ArminJo/JK-BMSToPylontechCAN/README.md

<div align = center>

# [Arduino JK-BMS To Pylontech CAN Protocol Converter](https://github.com/ArminJo/JK-BMSToPylontechCAN)

Converts the JK-BMS RS485 data to Pylontech CAN data for inverters which are not compatible with JK-BMS protocol but with Pylontech protocol, like Deye inverters.<br/>
Display of many BMS information and alarms on a locally attached serial 2004 LCD.<br/>


 &nbsp; &nbsp;

 &nbsp; &nbsp;

 &nbsp; &nbsp;

 &nbsp; &nbsp;

<br/>

Based on https://github.com/syssi/esphome-jk-bms and https://github.com/maxx-ukoo/jk-bms2pylontech.<br/>
The JK-BMS RS485 data (e.g. at connector GPS) are provided as RS232 TTL with 115200 Bit/s.

</div>

#### If you find this program useful, please give it a star.

&#x1F30E; [Google Translate](https://translate.google.com/translate?sl=en&u=https://github.com/ArminJo/JK-BMSToPylontechCAN)

<br/>

# Features
- Protocol converter from the JK-BMS status frame to Pylontech CAN frames.
- Supports sending of total capayity for **SMA** and **Luxpower** inverters.
- Optional linear **reducing maximum current above 80% SOC** (values can be adapted to your needs).
- Support for **multiple BMS** on a Nano board.
- Display of BMS information, Cell voltages, statistics and alarms on a locally attached **serial 2004 LCD**.
- Page button for switching **6 LCD display pages**.
- **CAN Info page** and debug output during long press of button.
- Statistics of minimum and maximum cells during balancing to **identify conspicuous cells**.
- Switch off LCD backlight after timeout (can be disabled at compile time).
- Beep on alarm and connection timeouts with selectable timeout.
- Alarm on cell voltage zero which indicats an internal BMS failure.
- Serial.print() function is still available for monitoring and debugging.
- **SOC graph output for Arduino Serial Plotter** at Plotter Info page. Clearing of SOC EEPROM data on long press.
- The voltage in the SOC graph is corrected by the automatically computed ESR to get a smoother voltage curve.
- Runs on an ATmega644 with all features. Compile it with [MightyCore](https://github.com/MCUdude/MightyCore).

<br/>

**If the Aduino IDE complains about more than 100% of program storage space, burn the Uno Bootloader on your Nano, if not already done, and select the Uno as board. The Arduino Nano board definition has a [wrong "upload.maximum_size" value](https://github.com/arduino/ArduinoCore-avr/pull/546).**<br/>
Look [here](https://github.com/ArminJo/JK-BMSToPylontechCAN/blob/main/JK-BMSToPylontechCAN/JK-BMSToPylontechCAN.ino#L139) for options to reduce program size / add optional features.

**On a MCP2515 / TJA1050 kit for Arduino you must [replace the assembled 8 MHz crystal with a 16 MHz one](https://www.mittns.de/thread/1340-mcp2515-8mhz-auf-16mhz-upgrade/).**

**The MCP2515 / TJA1050 kit for Arduino may be supplied by an extra 5 V regulator. My Arduino-Nano internal regulator cannot provide more than 100 mA and got defect on my site after a few days.**

**By default, the program sends a request to force charge the battery if SOC is below 5 %. This can be adapted by changing the line `#define SOC_THRESHOLD_FOR_FORCE_CHARGE_REQUEST_I 5`.**

At around 100% SOC, the JK-BMS seems to send strange current information of more than +/- 1 ampere.<br/>
If CAN communications breaks, the inverter may use different values for controlling the battery (e.g. "Use Batt V"), which may lead to additional discharging / charging.

<br/>

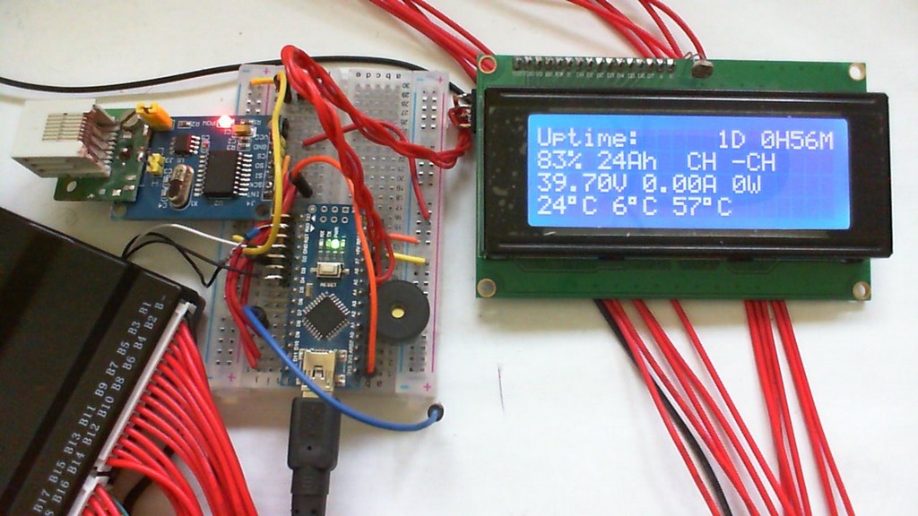
[picture p1: pictures/BreadboardAndOverviewPage.jpg]
Overview


<br/>

# Multiple BMS
Multiple BMS are enabled by activating line `#define HANDLE_MULTIPLE_BMS`.<br/>
At the time, 2 BMS are supported, but the code is prepared to support more.

The first BMS is connected with 115200 baud at pin 4 by SoftwareSerialTX to the JK-BMS RX line.
The second BMS can be connected at Nano pin 5 to the JK-BMS RX line of the second BMS.

We use the hardware serial RX pin for all serial from BMS (RX) because the RX data won't come at the same time.
But it is necessary to use a Schottky diode in each line to create a wired OR gate. 
As the active level of USART is **low**, all the cathodes of the Schottky diodes must be connected to the Nano RX pin, 
while each anode is connected to the BMS TX pin.

**Therefore we do not need a CPU with 2 serial ports, a Arduino Nano is sufficient.**

<br/>

# SOC graph for a 16S LiFePO4 battery
Created by attaching Arduio 1.8.19 Serial Plotter and then doing a long button press followed by a single one to enter the SOC History page.<br/>

Here you see a steep capacity increasing at the transition from 100 % to 99 %.
This happens when the specified capacity in the BMS is smaller than the real one.
The new 99 % represents a bigger capacity than the old 100 %.<br/>
If the capacity is around 100 Ah, the gradient of the capacity and the SOC line is identical.

Here the current is not negative for 99%, because it is the average of the current above 100% -increasing the capacity- and the negative current delivered for the step from 100% to 99%.

The voltage line is smooth, because it is corrected with the ESR (Equivalent Series Resistance) of the battery.
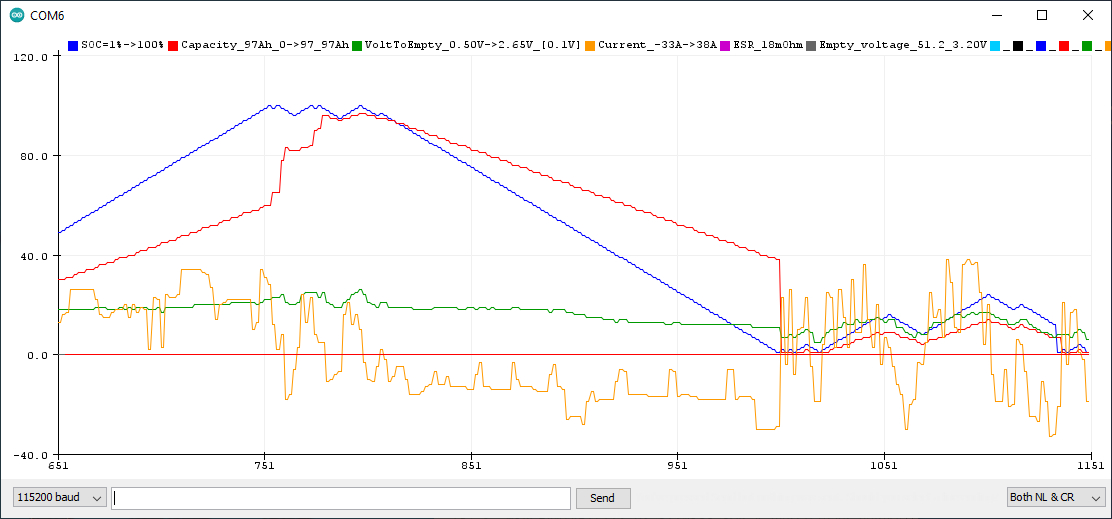
[picture p2: extras/SOCDataESR.png]


The same (raw) data without ESR correction of voltage.
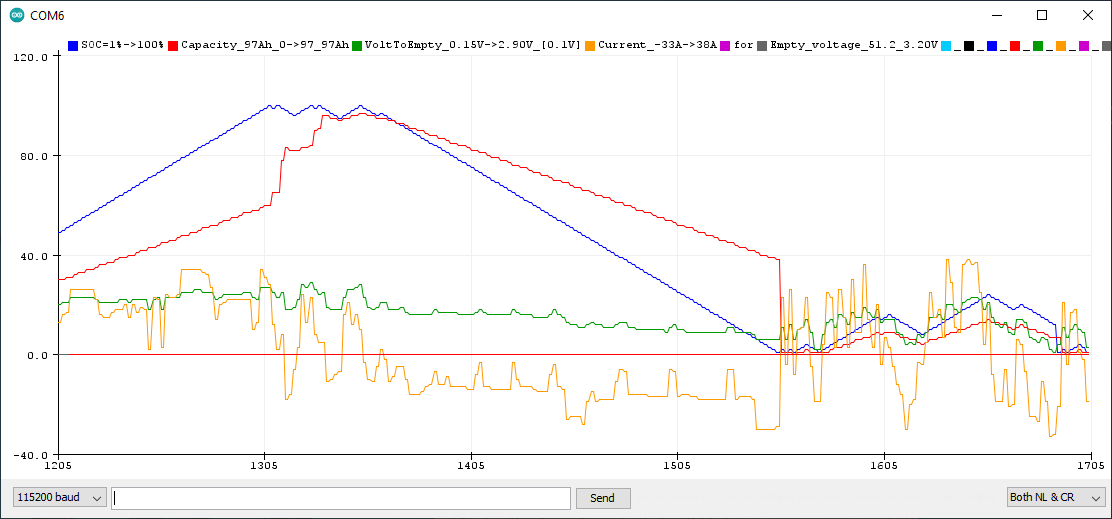
[picture p3: extras/SOCDataNoESR.png]


# Screenshots
 The screenshots are taken from the [Wokwi example](https://wokwi.com/projects/371657348012321793) with `STANDALONE_TEST` enabled and therefore may contain random data.

| Big Info page with:<br/>- SOC and Power<br/>- Maximum of 3 Temperatures and Ampere in/out<br/>- Difference between minimum / empty and (current battery voltage - Volt to full)<br/>- Display of  "C"harging "D"ischarging and "B"alancing active flags | Overview pagewith :<br/>- SOC, charged capacity, state of enable flags<br/>- Voltage, current and power<br/>- Voltage difference to empty, MosFet temperature, maximum sensor temperature, state of enabled functions. <br/>- If Overvoltage, C is replaced by O<br/>- If Undervoltage, D is Replaced by U |
| :-: | :-: |
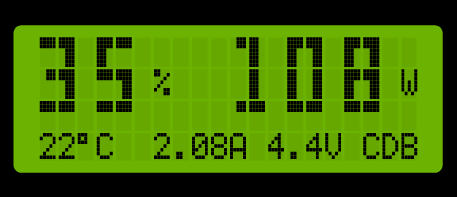
[picture p4: pictures/BigInfoPage.png]
Big Info page
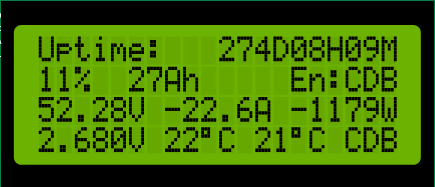
[picture p5: pictures/OverviewPage.png]
Overview page
|  |  |
| Undervoltage Alarm page<br/>Start of alarm message in first line<br/>Index and value of minimum cell and uptime in second line | Overtemperature Alarm page<br/>Alarm message is cleared by switching page |
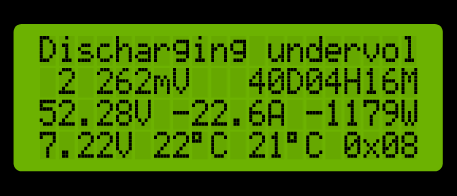
[picture p6: pictures/AlarmPage_Undervoltage.png]
Alarm page undervoltage
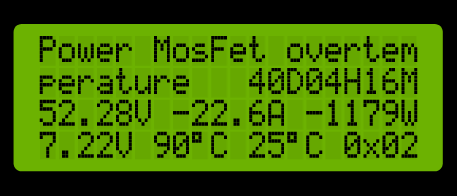
[picture p7: pictures/AlarmPage_MosFetOvertemperature.png]
Alarm page overtemperature
|  |  |
| Cell Info page with maximum and minimum indicators | Cell Info page with SHOW_SHORT_CELL_VOLTAGES aktivated:<br/>- (Cell voltages - 3 V)<br/>- SOC, current in A, state of enabled functions and difference between minimum / empty and current battery voltage in last column |
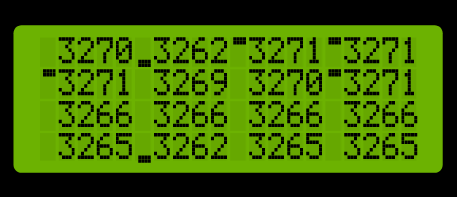
[picture p8: pictures/CellInfoPage.png]
Cell Info page long
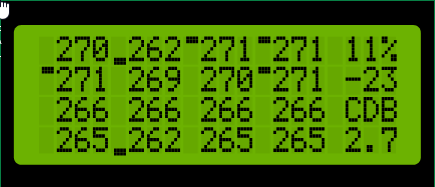
[picture p9: pictures/CellInfoPage_shortVoltages.png]
Cell Info page short
|  |  |
| Maximum Cell Statistics page with total balancing time in right rows | Minimum Cell Statistics page<br/>The maximum and minimum displays are toggled every 8 seconds |
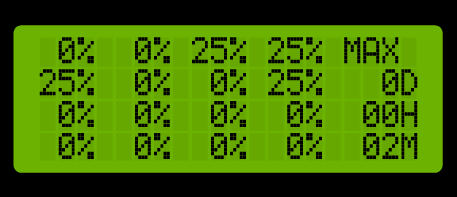
[picture p10: pictures/StatisticsMaxPage.png]
Max page
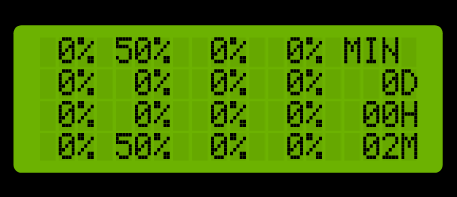
[picture p11: pictures/StatisticsMinPage.png]
Min page
|  |   |
| CAN Info page |  |
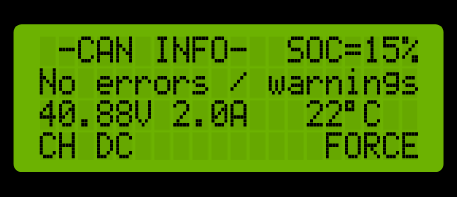
[picture p12: pictures/CANInfoPage.png]
CAN Info page
|  |  |
| Capacity Info page (CAN Info page + 2 buttton presses) percentages | Capacity Info page voltages<br/>Current capacity change in first row if delta-SOC > 1<br/>Historic capacity changes with delta-SOC > 40 in row 2 to 4 |
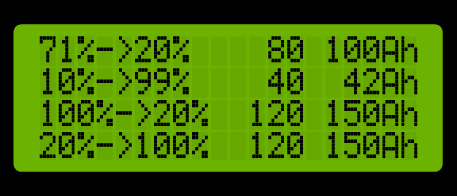
[picture p13: pictures/CapacityStatisticsPercentagePage.png]
Percentage page
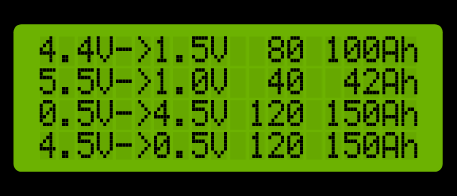
[picture p14: pictures/CapacityStatisticsVoltagePage.png]
Voltage page
|  |   |

<br/>

# Pictures

| My installation | Automatic brightness |
| :-: | :-: |
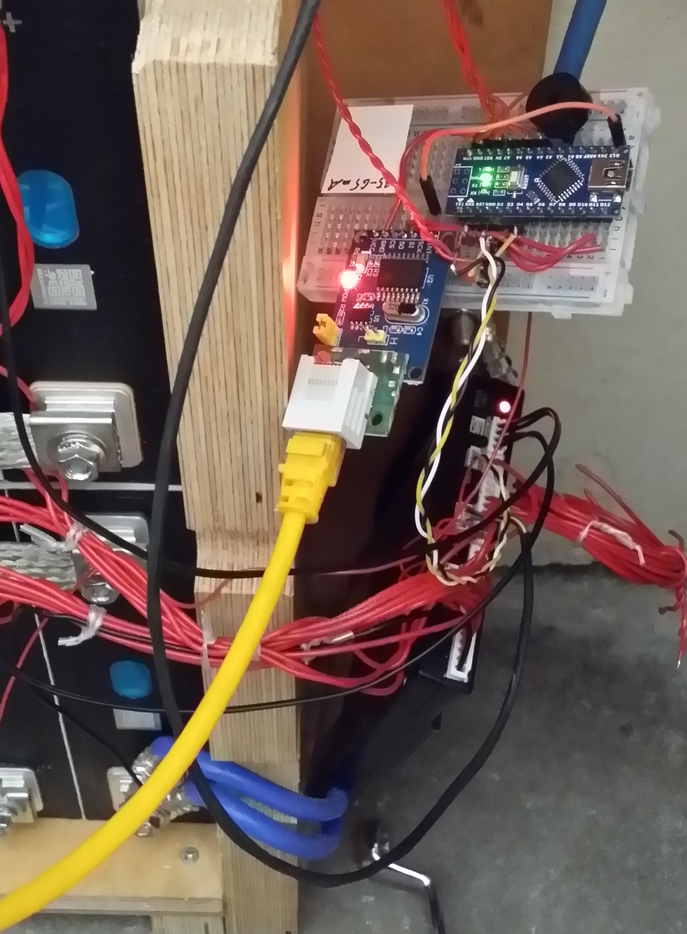
[picture p15: pictures/CompleteInstallation.jpg]
My installation
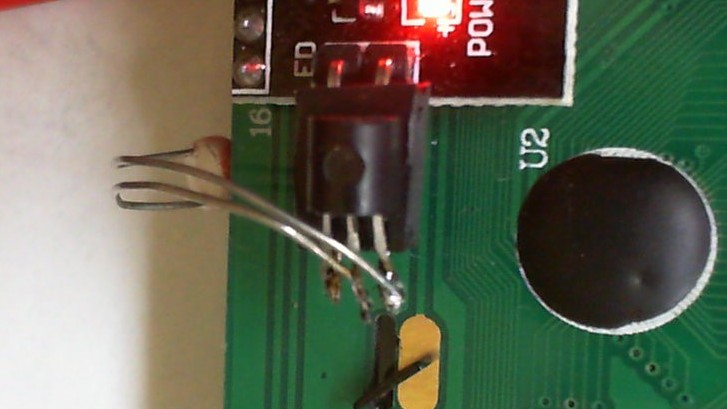
[picture p16: pictures/AutomaticBrightness.jpg]
Automatic brightness
|  |  |
| Breadboard detail |  |
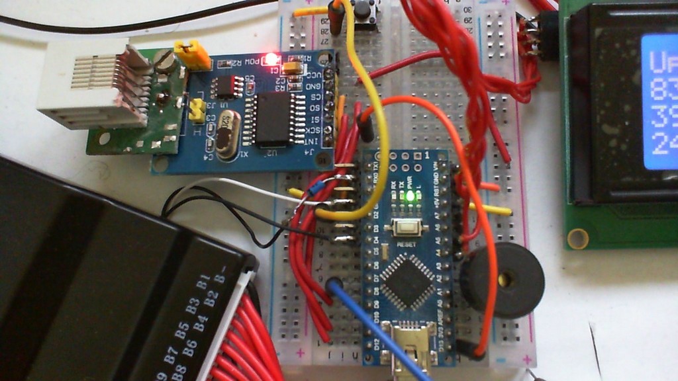
[picture p17: pictures/BreadboardDetail.jpg]
Breadboard detail
|  |  |
| Breadboard without BMS connected | Standalone test |
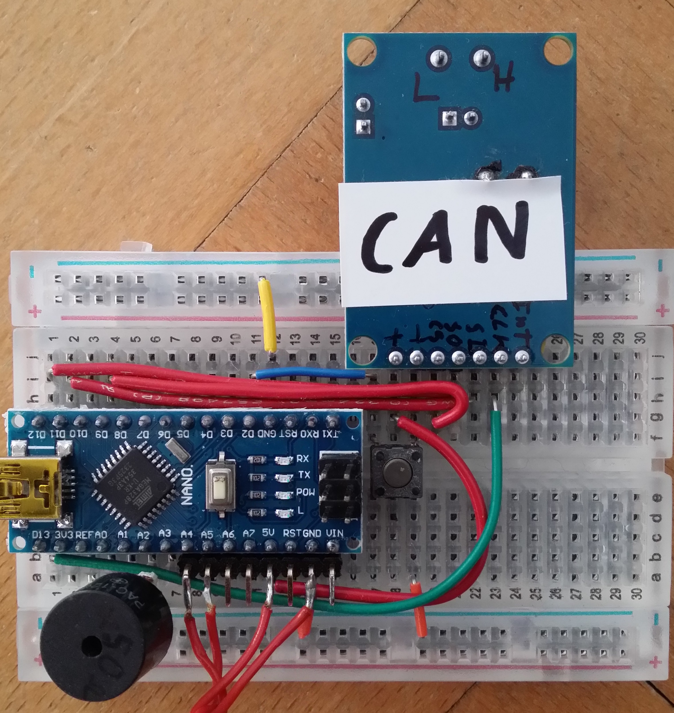
[picture p18: pictures/BreadboardSimple.jpg]
Breadboard detail
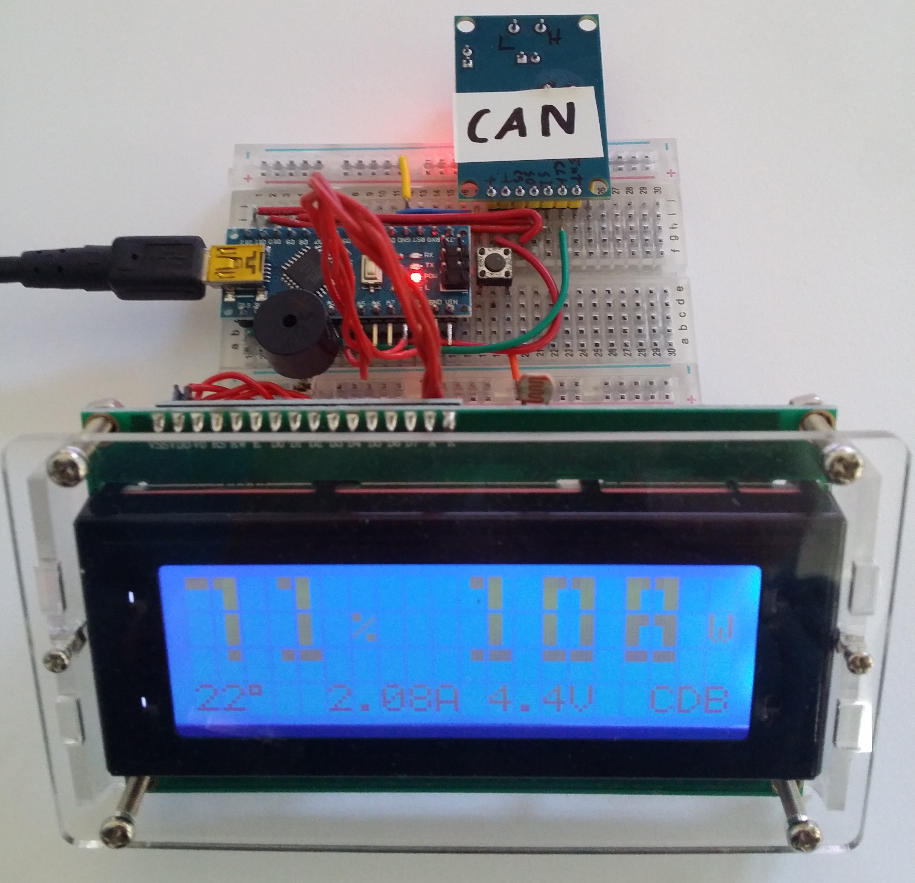
[picture p19: pictures/StandaloneTest.jpg]
Standalone test
|  |  |
| No-breadboard version overview | No-breadboard version overview |
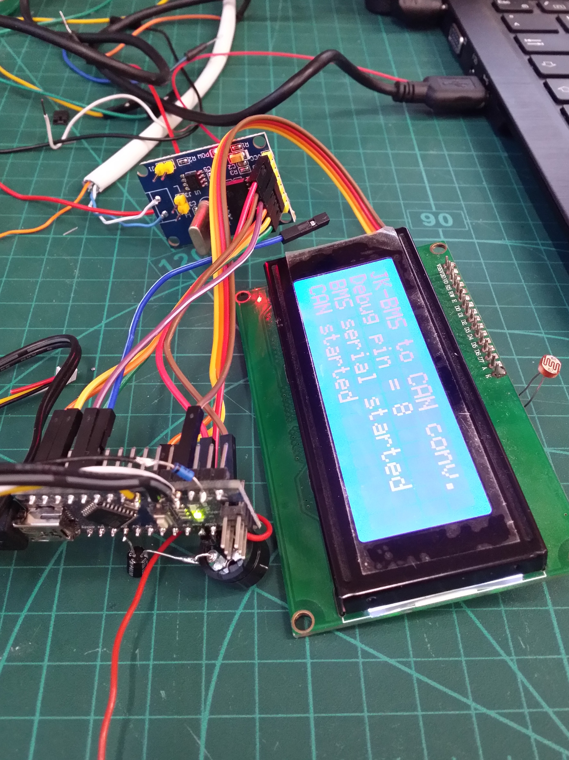
[picture p20: pictures/NoBreadboardOverview1.jpg]
Overview no breadboard
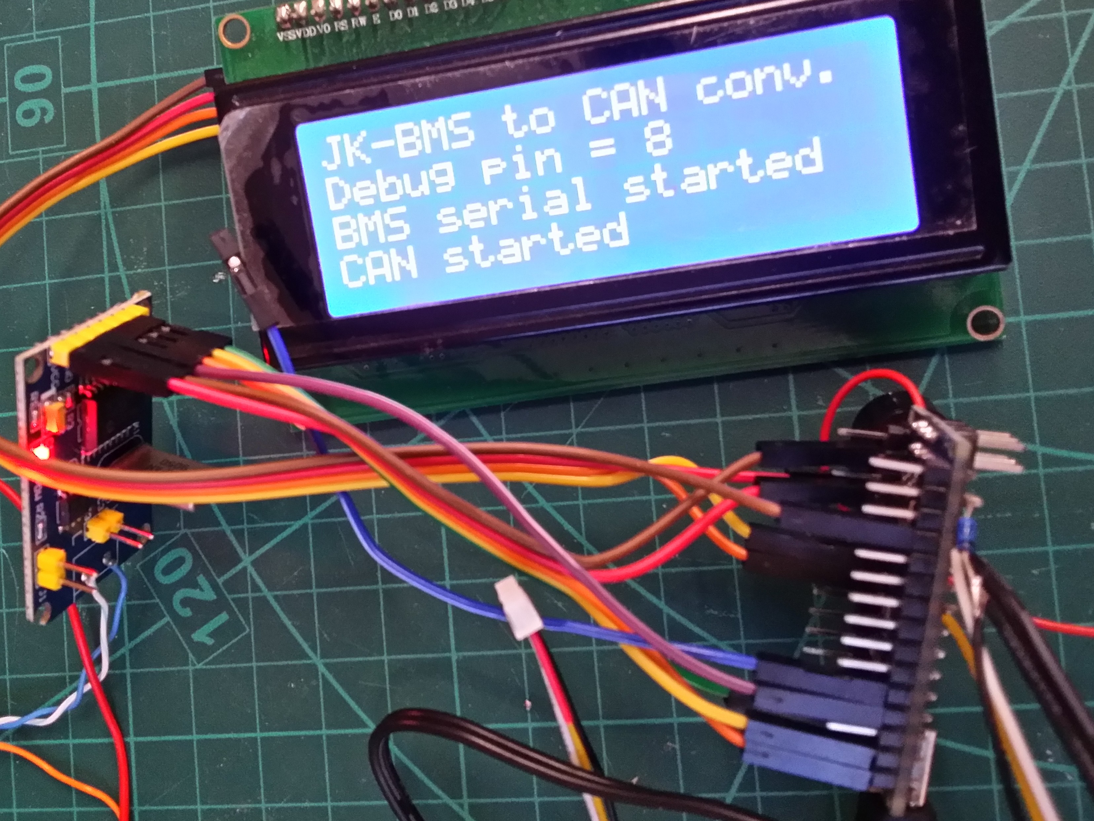
[picture p21: pictures/NoBreadboardOverview2.jpg]
Overview no breadboard
|  |  |
| Nano top view | Nano bottom view |
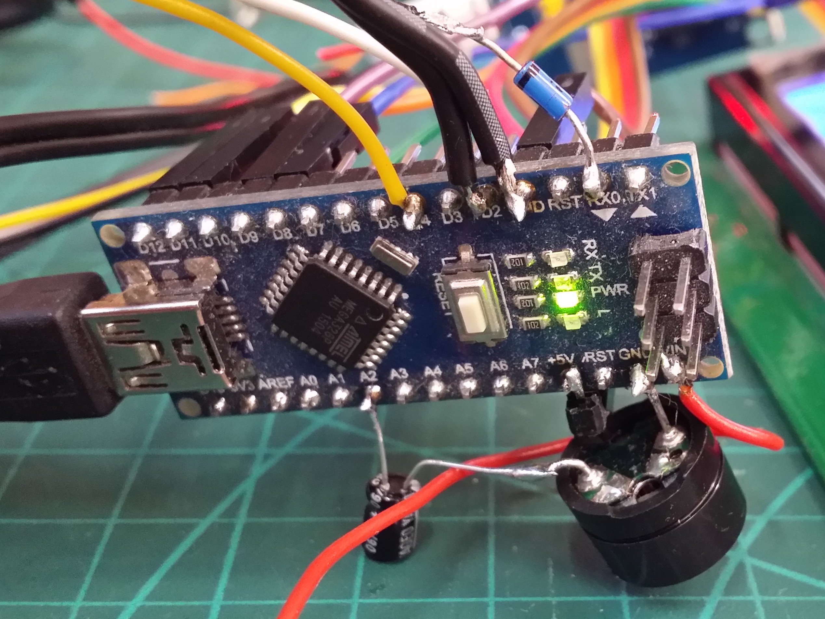
[picture p22: pictures/NanoTop.jpg]
Nano top view
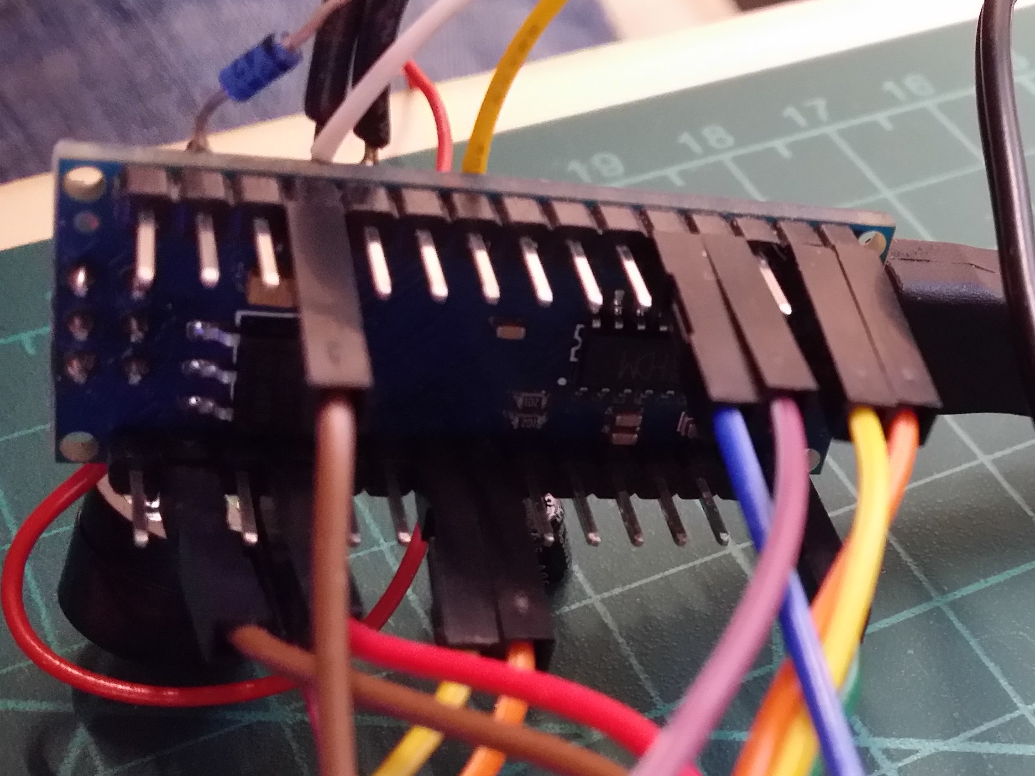
[picture p23: pictures/NanoBottom.jpg]
Nano bottom view
|  |  |

<br/>

# Youtube video of JK-BMS doing wrong computing of capacity.
I discharged the battery for 10 minutes with 45A, which gives **7.5 Ah** capacity loss.<br/>
Start of 10 minutes period is left screenshot with time of ...**21M40S** and Capacity **50.7 Ah**, end of period is right screenshot with time of ...**31M40S** and Capacity **38.6 Ah**.<br/>
These 2 values correspond to a **BMS computed capacity loss of 12.1 Ah** (50.7 Ah - 38.6 Ah)!<br/>
**What the hell is the formula they used for this obviosly wrong result!!!***<br/>
SOC went from 40 % to 30 %, which at least corresponds to 12.5 Ah for a total battery capacity of 125 Ah.

Youtube video of JK-BMS doing wrong computing of capacity (https://www.youtube.com/watch?v=tDN8iFr98JA)

<br/>

# Example on Wokwi
Also usable as connection schematic.

- [Wokwi JK-BMSToPylontechCAN example](https://wokwi.com/projects/371657348012321793).

 <br/>

# Connection schematic
The standard **RX** of the Arduino is used for the JK-BMS connection.<br/>
A **schottky diode** is inserted into the RX line to allow programming the AVR with the JK-BMS still connected and switched on.
Keep in mind that programming will fail if JK-BMS is connected and switched off.<br/>
The standard **TX** of the Arduino is used for Serial.print() for monitoring and debugging. The short **request to JK-BMS is sent by `SoftwareSerialTX` using pin 4**.<br/>
If you use the cable from the separate RS485 adapter of the JK-BMS and follow the labeling on the board, you have to **swap the lines for RX and TX (pin 4)** on the Uno / Nano.

**Troubleshooting BMS receive problems**<br/>
Since the RX pin of the Nano is also connected to the TX pin of the USB converter chip (CH340 or similar),
it can be difficult for the JK-BMS TX output to pull it properly down.<br/>
This results in not receiving any data from the BMS despite the connection.<br/>
In this case, first try to remove the diode and second connect a pull down at the Nano RX.<br/>
Depending on the USB converter chip, this pull down can be in the range from 680 Ohm to 1 kOhm.

**Power** is taken from an **USB power supply** connected to the Nano. Current is 40 mA for a dark 2004 display and 55 mA for a bright one.<br/>
Optionally, power can be taken from the second battery (>6.4 V), but then you may require an external 5V regulator. My built in regulator broke 2 times (with LCD connected).<br/>
Or use the complete battery voltage for Nano supply and a buck converters for around 48 to 60 volt. But my test converter had an idle current of 6 mA (0.3 W), so I decided to stay with the USB power supply.

On the Deye, connect cable before setting `Battery Mode` to `Lithium`, to avoid alarm. `Lithium Mode` for Pylontech CAN is `0` or `PYLON`.

```
 ALTERNATIVE EXTERNAL POWER SUPPLY:
                                          78L05    Optional Schottky diode - From Uno/Nano 5 V
                                           ___                         to enable powering CAN
 Optional 6.4 V from Battery #2 >-o-------|___|-------o-|<|-< Uno 5V   module by Nano USB, if
                                  |         |         |                battery is not attached
                                  |        ---        |
 . . . . . . . . . . . . . . . . . . . . . . . . . . . . . . . . . . . . . . . . . . . . . . .
                                  |                   |
  __________ Schottky diode   ____|____           ____|____             _________
 |        TX|>--|<|-o- RX -->|RX Vin   |<- SPI ->|   5V    |           |         |
 |        RX|<------|- TX --<|4  Uno/  |         | MCP2515 |           |         |
 |  JK-BMS  |      .-. opt.  |   Nano  |         |   CAN   |<-- CAN -->|  DEYE   |
 |          |   1k | | pull  |         |         |         |           |         |
 |          |      '-' down  |         |         |         |           |         |
 |__________|<------o- GND ->|_________|<- GND ->|_________|           |_________|

An optional pull down may be required at the RX pin of the Nano,
to compensate for the load of the USB chip (CH340 or similar) at this pin.
Depending on the USB chip, the pull down can be down to 680 Ohm.

# Connection diagram for JK-BMS GPS / UART-TTL socket (4 Pin, JST 1.25mm pitch)
  ___ ________ ___
 |                |
 | O   O   O   O  |
 |GND  RX  TX VBAT|
 |________________|
   |   |   |
   |   |   o-|<|-- RX of Uno / Nano
   |   o---------- D4 (or other pin, if specified differently)
   o-------------- GND

# Using an abitrary PNP transistor instead of a diode between BMS TX and Nano RX,
#   to support weak TX outputs and multiple BMS connected to one Nano RX.
  ___ ________ ___
 |                |
 | O   O   O   O  |
 |GND  RX  TX VBAT|
 |________________|
   |   |   |
   |   |   |      o GND
   |   |   |      |
   |   |   |    |/  C
   |   |   o----|       Any PNP will work!
   |   |     B  |<
   |   |          | E
   |   |          o-- RX of Uno / Nano
   |   o------------- D4 (or other pin, if specified differently)
   o----------------- GND

# Automatic brightness control for 2004 LCD
   5V O------o------o
             |      |
            .-.     |
        LDR | |     |
            | |     |
            '-'     |
             |    |/
             o----|
                  |>
                    |
                    o To anode of LCD backlight

Alternative circuit for VCC lower than 5 volt e.g. for supply by Li-ion battery

  3.5V to 5V O------o------o Anode of LCD backlight
             |
            .-.
   LDR with | |
     high R | |     o Kathode of LCD backlight
            '-'     |
             |    |/
             o----|
                  |>
                    |
  GND O-------------o

```
<br/>

# Example schematics and PCB layouts
- [KiCad8 schematics and PCB layout](https://github.com/dremeier/Arduino-JK-BMS-To-Pylontech-CAN-PCB) for ATmega644 compiled with [MightyCore](https://github.com/MCUdude/MightyCore) and 2 BMS connectors by Andé Meier.
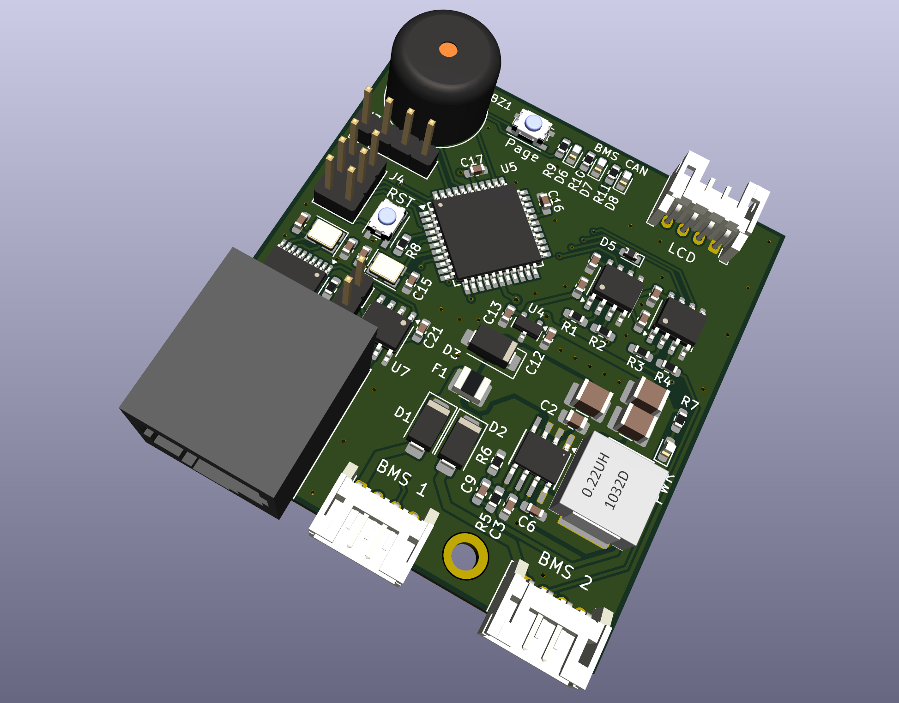
[picture p24: pictures/BMS-CAN_PCB_top_v0.1.png]
PCB layout (https://github.com/dremeier/Arduino-JK-BMS-To-Pylontech-CAN-PCB)


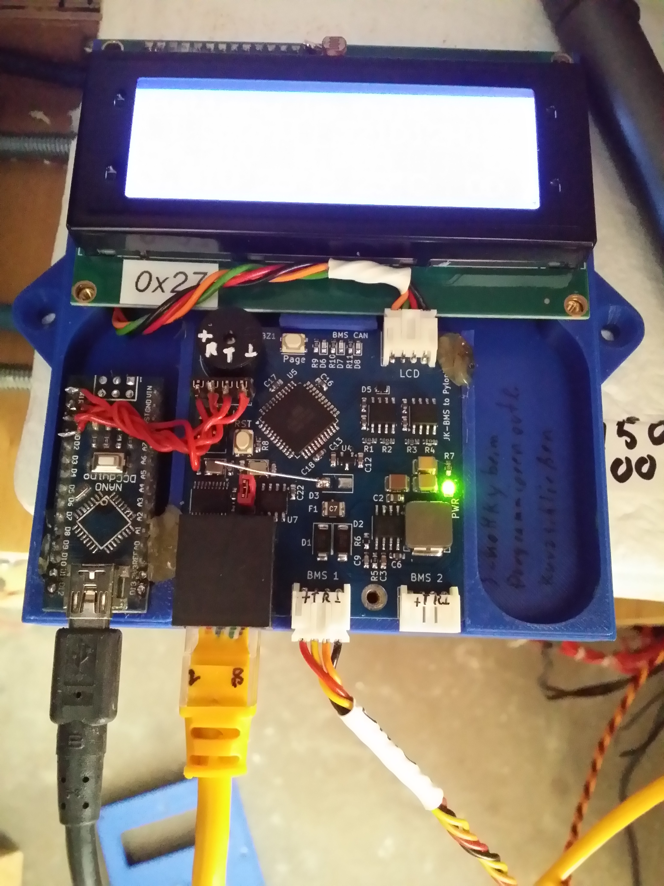
[picture p25: pictures/644Board.jpg]
644 board


- EasyEda schematics and PCB layout by Ngoc Dang Dinh.
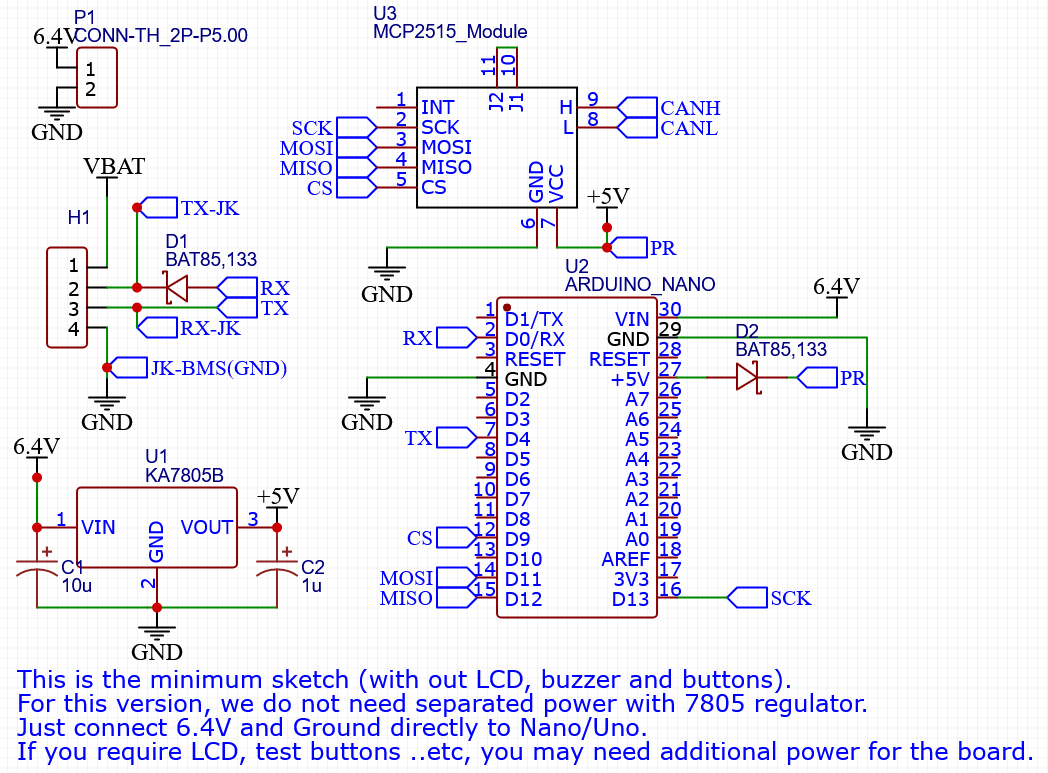
[picture p26: pictures/EasyEda_shematics_by_Ngoc_Dang_Dinh.png]
Minimal layout (https://easyeda.com/editor#id=0d1a2556b7634c8bbd22e9c0474cd401)


- EasyEda [schematics](https://easyeda.com/editor#id=809cb7e913b5453f9d324c442df66a4e) and [PCB layout](https://easyeda.com/editor#id=005061dbeb414870bc63ab052561ddf4) by rooftopsolarsa/WannaBeSolarSparky from [this](https://github.com/ArminJo/JK-BMSToPylontechCAN/discussions/27) discussion. The status LEDs are missing in the schematic and button2 is no longer required.

<br/>

# Board pinout diagrams
- [Nano](https://store.arduino.cc/products/arduino-nano#docs)
- [Uno](https://store.arduino.cc/products/arduino-uno-rev3#docs)
 <br/>

# Principle of operation
1. A request to deliver all informations is sent to the BMS (1.85 ms).
2. Wait and receive the BMS status frame (wait for 0.18 to 1 ms + receive 25.5 ms).
3. The BMS status frame is stored in a buffer and parity and other plausi checks are made.
4. The cell data are converted and enhanced to fill the JKConvertedCellInfoStruct.
   Other frame data are mapped to a C structure.
   But all words and longs in this structure are filled with big endian and thus cannot be read directly but must be swapped on reading.
5. Other frame data are converted and enhanced to fill the JKComputedDataStruct.
6. The content of the status frame is printed. After reset, all info is printed once, then only dynamic info is printed.
7. The required CAN data is filled in the according PylontechCANFrameInfoStruct.
8. Dynamic data and alarms are displayed on the optional 2004 LCD if attached.
9. CAN data is sent.

<br/>

# Compile with the Arduino IDE
Download and extract the repository. In the Arduino IDE open the sketch with File -> Open... and select the JK-BMSToPylontechCAN folder.<br/>
All libraries, especially the modified ones, are included in this project.

It is always recommended to burn the Uno bootloader on a Nano board, and trating your Nano board as an an Uno board for Arduino compiles.
This will give you 1.5 kB more program space, without any disadvantages. Even A6 and A7 are available :-).

<br/>

# Compile options / macros for this software
To customize the software to different requirements, there are some compile options / macros available.<br/>
These macros must be defined in your program before the line `#include "JK-BMS.hpp"` to take effect.<br/>
Modify them by enabling / disabling them, or change the values if applicable.

| Name | Default value | Description |
|-|-|-|
| `MILLISECONDS_BETWEEN_JK_DATA_FRAME_`<br/>`REQUESTS` | 2000 | % |
| `MILLISECONDS_BETWEEN_CAN_FRAME_SEND` | 2000 | % |
| `NO_BEEP_ON_ERROR` | disabled | . |
| `ONE_BEEP_ON_ERROR` | disabled | If activated, only beep once if error was detected. |
| `MULTIPLE_BEEPS_WITH_TIMEOUT` | enabled | If error was detected, beep for `BEEP_TIMEOUT_SECONDS` (60) s. |
| `BEEP_TIMEOUT_SECONDS` | 60 | 1 minute, every MILLISECONDS_BETWEEN_JK_DATA_FRAME_REQUESTS` (2) seconds. |
| `SUPPRESS_LIFEPO4_PLAUSI_WARNING` | disabled | Disables warning on Serial out about using LiFePO4 beyond 3.0 v to 3.45 V. |
| `ENABLE_OVER_AND_UNDER_VOLTAGE_WARNING_ON_LCD` | disabled | Enables switching to Overview page and showing over- and undervoltage data. |
| `MAXIMUM_NUMBER_OF_CELLS` | 24 | Maximum number of cell info which can be converted. Saves RAM. |
| `USE_NO_LCD` | disabled | Disables the code for the LCD display. Saves 25% program space on a Nano. |
| `DISPLAY_ALWAYS_ON` | disabled | If activated, the display backlight is always on. This disables the value of `DISPLAY_ON_TIME_SECONDS`. |
| `DISPLAY_ON_TIME_SECONDS` | 300 | 300 s / 5 min after the last button press, the backlight of the LCD display is switched off. |
| `DISPLAY_ON_TIME_SECONDS_IF_TIMEOUT` | 180 | 180 s / 3 min after the first timeout / BMS shutdown, the backlight of the LCD display is switched off. |
| `USE_NO_COMMUNICATION_STATUS_LEDS` | disabled | If activated, the code for the BMS and CAN communication status LED is deactivated and the pins are not switched to output. |
| `SERIAL_INFO_PRINT` | disabled | Enables writing some info to serial output. Requires additional 1684 bytes program space. |
| `ENABLE_MONITORING` | enabled for more than 32k FLASH | Enables writing cell and current values CSV data to serial output. Requires additional 858 bytes program space. |
| `NO_CELL_STATISTICS` | disabled | Disables generating and display of cell balancing statistics. Saves 1628 bytes program space. |
| `NO_SOC_HISTORY` | disabled | Disables generating, storing and display of SOC graph for Arduino Serial Plotter. Saves 3882 bytes program space. |
| `STANDALONE_TEST` | disabled | If activated, fixed BMS data is sent to CAN bus and displayed on LCD. |
| `NO_CAPACITY_35F_EXTENSIONS` | disabled | If activated, supress sending of frame 0x35F for total capacity for SMA Sunny Island inverters over CAN. Saves 56 bytes program space. |
| `NO_CAPACITY_379_EXTENSIONS` | disabled | If activated, supress sending of frame 0x379 for total capacity for Luxpower SNA inverters over CAN. Saves 24 bytes program space. |
| `NO_BYD_LIMITS_373_EXTENSIONS` | disabled | If activated, supress sending of frame 0x373 for cell limits as sent by BYD battery over CAN. Saves 200 bytes program space. |
| `DO_NOT_SHOW_SHORT_CELL_VOLTAGES` | disabled | If activated, do not print 3 digits cell voltage (value - 3.0 V) on Cell Info page. Disables display of up to 20 voltages or display of additional information on this page. Saves 470 bytes program space. |

The next macros enables and controls the build in CAN data modification function.

| Name | Default value | Description |
|-|-|-|
| `CAN_DATA_MODIFICATION` | disabled | If activated, it currently enables the function to reduce max current at high SOC level. |
| `MAX_CURRENT_MODIFICATION_LOWER_SOC_`<br/>`THRESHOLD_PERCENT` | 80 | Start SOC for linear reducing maximum current. |
| `MAX_CURRENT_MODIFICATION_MIN_CURRENT_`<br/>`TENTHS_OF_AMPERE` | 50 | Value of current at 100 % SOC. Units are 100 mA! |

There may be some some more options like `BUTTON_DEBOUNCING_MILLIS`, which are only for very special requirements.

The CSV data printed, if `ENABLE_MONITORING` is enabled, has the caption:
`"Uptime[min];Cell_1;Cell_2;Cell_3;Cell_4;Cell_5;Cell_6;Cell_7;Cell_8;Cell_9;Cell_10;Cell_11;Cell_12;Cell_13;Cell_14;Cell_15;Cell_16;Voltage[mV];Current[A];Capacity[100mAh];SOC[%]`<br/>
Example data: `CSV: 270;262;271;271;271;269;270;271;266;266;266;266;265;262;265;265;5228;-22.56;71;1`
<br/>

# Libraries used
This program uses the following libraries, which are already included in this repository:

- [SoftwareSerialTX](https://reference.arduino.cc/reference/en/libraries/liquidcrystal-i2c/) for sending Serial to JK-BMS.
- Modified [LiquidCrystal_I2C](https://reference.arduino.cc/reference/en/libraries/liquidcrystal-i2c/) for LCD connected by I2C.
- [SoftI2CMaster](https://github.com/felias-fogg/SoftI2CMaster) for LCD minimal I2C functions.
- [LCDBigNumbers](https://github.com/ArminJo/LCDBigNumbers) for LCD big number generation.
- [EasyButtonAtInt01](https://github.com/ArminJo/EasyButtonAtInt01) for LCD page switching button.
- Modified mcp_can_dfs.h file from Seed-Studio [Seeed_Arduino_CAN](https://github.com/Seeed-Studio/Seeed_Arduino_CAN).

 <br/>

# BOM
### Required
- Breadboard.
- Jumper wire.
- Pin header to connect cables to breadboard.
- Schottky diode e.g. BAT 42, BAT 43, BAT 85.
- Arduino Nano.
- 16 MHz crystal.
- MCP2515 / TJA1050 kit for Arduino. !!! You must replace the assembled 8 MHz crystal with a 16 MHz one !!!

### Optional
- 2004 LCD with serial I2C interface adapter.
- 2 pin female header for automatic LCD brightness control.
- LDR for automatic LCD brightness control.
- BC 549 or any NPN type for automatic LCD brightness control. The effect varies, depending on the LDR and the hFE of the transistor.

<br/>

### Links:
- [CAN Bus Bit Timing Calculator](https://www.kvaser.com/support/calculators/bit-timing-calculator/)
- [Pylontech US2000 / US3000 CAN reading and CAN replication](https://www.setfirelabs.com/green-energy/pylontech-can-reading-can-replication)
- [BYD Battery-Box Premium LVS B019 CAN Protocol](https://github.com/dfch/BydCanProtocol/tree/main)
- [Ultimate Guide to LiFePO4 Voltage Chart](https://www.jackery.com/blogs/knowledge/ultimate-guide-to-lifepo4-voltage-chart)

<br/>

# Tested Inverter
- SUN-5K-SG05LP1-EU
- Growatt SPH6000

# Revision History
### Version 4.0.0
- JK_BMS communication and print functions are now contained in the JK_BMS class.
- Support for multi BMS handling.

### Version 3.2.1
- New macro ENABLE_OVER_AND_UNDER_VOLTAGE_WARNING_ON_LCD.

### Version 3.2.0
- Adaption for ATmega644.
- Automatic ESR computation only for more than 100 data points.
- Keep accumulated analytics data at reset.

### Version 3.1.0
- Analytics bug fixing.
- Analytics graph handling of extra capacity below 0 % and above 100 %.

### Version 3.0.0
- Automatic computation of battery ESR if analytics are enabled.
- Removed direct computation of capacity.
- Changed CSV line.
- Changed default monitoring interval to 10 min / 1 hour.
- Added monitoring every Ah.

### Version 2.6.0
- Refactored alarm and timeout handling.
- Removed default setting of `CAPACITY_35F_EXTENSIONS`, `CAPACITY_379_EXTENSIONS` and `BYD_LIMITS_373_EXTENSIONS`.

### Version 2.5.2
- Fixed bugs.
- Back to start page at next button press after 1 minute.
- `SHOW_SHORT_CELL_VOLTAGES` is default now.
- Improved graph output.
- Reduced serial output.

### Version 2.4.0
- Added optional user function to reduce max current at high SOC level.
- Optional 3 digits cell voltage on LCD.
- Support for communication status LED.
- Internal capacity computing.
- Added frame 0x373 for BYD style Cell limits.
- SOC graph output for Arduino Serial Plotter at startup and Capacity Statistics page.

### Version 2.3.0
- Added frame 0x35F for total capacity as SMA extension, which is no problem for Deye inverters.
- Added frame 0x379 for total capacity as Luxpower extension, which is no problem for Deye inverters.

### Version 2.2.0
- Fixed LCD backlight timeout bug introduced in 1.3.0.
- Long press of page button instead of debug button.
- Do not use sleep any more by default.

### Version 2.1.1
- Fixed SOH == 0 bug.

### Version 2.1
- New compile option / macro `USE_NO_LCD`.
- GUI and print improvements.

### Version 2.0
- New page for minimum and maximum cell statistics and balancing time.
- Show difference between actual and 100% voltage.

### Version 1.3
- First release version.

### Version 0.9
- Initial version.

# Sample Serial output
See also [here](https://github.com/ArminJo/JK-BMSToPylontechCAN/tree/main/extras).

```
START ../src/JK-BMSToPylontechCAN.cpp
Version 2.0 from Sep  8 2023
Serial to JK-BMS started with 115.200 kbit/s!
CAN started with 500 kbit/s!
Page switching button is at pin PAGE_BUTTON_PIN
At long press, CAN Info page is entered and additional debug data is printed as long as button is pressed
2000 ms between 2 BMS requests
2000 ms between 2 CAN transmissions
No LCD Backlight timeout

*** BMS INFO ***
Protocol Version Number=1
Software Version Number=11.XW_S11.26___
Modify Parameter Password=1234
# External Temperature Sensors=2

*** BATTERY INFO ***
Manufacturer Date=2307
Manufacturer Id=Armins__BMS1JK_B2A20S20P
Device ID String=Armins__
Device Address=1
Total Battery Capacity[Ah]=115, Low Capacity Alarm Percent=20
Charging Cycles=1
Total Charging Cycle Capacity=218
# Battery Cells=16, Cell Count=16

*** VOLTAGE PROTECTION INFO ***
Battery Overvoltage Protection[mV]=55200, Undervoltage=48000
Cell Overvoltage Protection[mV]=3450, Recovery=3400, Delay[s]=5
Cell Undervoltage Protection[mV]=3000, Recovery=3050, Delay[s]=5
Cell Voltage Difference Protection[mV]=300
Discharging Overcurrent Protection[A]=80, Delay[s]=30
Charging Overcurrent Protection[A]=43, Delay[s]=30

*** TEMPERATURE PROTECTION INFO ***
Power MosFet Temperature Protection=80, Recovery=70
Sensor1 Temperature Protection=100, Recovery=100
Sensor1 to Sensor2 Temperature Difference Protection=20
Charge Overtemperature Protection=45, Discharge=45
Charge Undertemperature Protection=3, Recovery=5
Discharge Undertemperature Protection=-20, Recovery=-10

*** MISC INFO ***
Balance Starting Cell Voltage=[mV]3350
Balance Triggering Voltage Difference[mV]=10

Current Calibration[mA]=1048
Sleep Wait Time[s]=10

Dedicated Charge Switch Active=0
Start Current Calibration State=0
Battery Actual Capacity[Ah]=115

Reboot detected: keep SOCDataPointsInfo

Total Runtime Minutes=49260 ->   34D05H00M
*** CELL INFO ***
16 Cells, Minimum=3397 mV, Maximum=3408mV, Delta=11 mV, Average=3403 mV
 1=3397 mV,  2=3399 mV,  3=3400 mV,  4=3403 mV,  5=3406 mV,  6=3407 mV,  7=3407 mV,  8=3408 mV,
 9=3400 mV,  10=3406 mV, 11=3407 mV, 12=3404 mV, 13=3404 mV, 14=3403 mV, 15=3401 mV, 16=3402 mV,

Temperature: Power MosFet=28, Sensor 1=25, Sensor 2=25
SOC[%]=99 -> Remaining Capacity[Ah]=113
Battery Voltage[V]=54.41, Current[A]=-1.25, Power[W]=-68
Battery Voltage difference to full[V]=0.8
Charging MosFet enabled, active | Discharging MosFet enabled, active | Balancing enabled, not active
Battery Voltage[V]=54.41, Current[A]=1.25, Power[W]=68
Battery Voltage difference to full[V]=0.8
Set LCD display page to: 0
Set LCD display page to: 1
Set LCD display page to: 2
Debug mode just activated
Send CAN
CANId=0x351, FrameLength=8, Data=0x28, 0x2, 0xF4, 0x1, 0x20, 0x3, 0xE0, 0x1
CANId=0x355, FrameLength=4, Data=0x3C, 0x0, 0x64, 0x0
CANId=0x356, FrameLength=6, Data=0x6C, 0x14, 0x0, 0x0, 0xDC, 0x0
CANId=0x35E, FrameLength=8, Data=0x50, 0x59, 0x4C, 0x4F, 0x4E, 0x20, 0x20, 0x20
CANId=0x35C, FrameLength=2, Data=0xC0, 0x0
CANId=0x305, FrameLength=8, Data=0x21, 0x0, 0x0, 0x0, 0x0, 0x0, 0x0, 0x0
CANId=0x359, FrameLength=7, Data=0x0, 0x0, 0x0, 0x0, 0x1, 0x50, 0x4E

Send requestFrame with TxToJKBMS
 0x4E 0x57 0x0 0x13 0x0 0x0 0x0 0x0 0x6 0x3 0x0 0x0 0x0 0x0 0x0 0x0 0x68 0x0 0x0 0x1 0x29
291 bytes received
0x00  0x4E 0x57 0x01 0x21 0x00 0x00 0x00 0x00 0x06 0x00 0x01
0x0B  0x79 0x30 0x01 0x0C 0xC6
0x10  0x02 0x0C 0xBE 0x03 0x0C 0xC7 0x04 0x0C 0xC7 0x05 0x0C 0xC7 0x06 0x0C 0xC5 0x07
0x20  0x0C 0xC6 0x08 0x0C 0xC7 0x09 0x0C 0xC2 0x0A 0x0C 0xC2 0x0B 0x0C 0xC2 0x0C 0x0C
0x30  0xC2 0x0D 0x0C 0xC1 0x0E 0x0C 0xC1 0x0F 0x0C 0xC1 0x10 0x0C 0xC1
0x3D  0x80 0x00 0x16
0x40  0x81 0x00 0x15 0x82 0x00 0x16 0x83 0x14 0x6C 0x84 0x00 0x00 0x85 0x3C 0x86 0x02
0x50  0x87 0x00 0x00 0x89 0x00 0x00 0x00 0x00 0x8A 0x00 0x10 0x8B 0x00 0x00 0x8C 0x00
0x60  0x03 0x8E 0x15 0x90 0x8F 0x12 0xC0 0x90 0x0D 0x7A 0x91 0x0D 0x48 0x92 0x00 0x05
0x70  0x93 0x0B 0xB8 0x94 0x0B 0xEA 0x95 0x00 0x05 0x96 0x01 0x2C 0x97 0x00 0x50 0x98
0x80  0x00 0x1E 0x99 0x00 0x32 0x9A 0x00 0x1E 0x9B 0x0C 0x80 0x9C 0x00 0x0A 0x9D 0x01
0x90  0x9E 0x00 0x50 0x9F 0x00 0x46 0xA0 0x00 0x64 0xA1 0x00 0x64 0xA2 0x00 0x14 0xA3
0xA0  0x00 0x3C 0xA4 0x00 0x46 0xA5 0x00 0x05 0xA6 0x00 0x0A 0xA7 0xFF 0xEC 0xA8 0xFF
0xB0  0xF6 0xA9 0x10 0xAA 0x00 0x00 0x00 0x6E 0xAB 0x01 0xAC 0x01 0xAD 0x04 0x18 0xAE
0xC0  0x01 0xAF 0x00 0xB0 0x00 0x0A 0xB1 0x14 0xB2 0x31 0x32 0x33 0x34 0x35 0x36 0x00
0xD0  0x00 0x00 0x00 0xB3 0x00 0xB4 0x41 0x72 0x6D 0x69 0x6E 0x73 0x5F 0x5F 0xB5 0x32
0xE0  0x33 0x30 0x37 0xB6 0x00 0x00 0x0E 0x85 0xB7 0x31 0x31 0x2E 0x58 0x57 0x5F 0x53
0xF0  0x31 0x31 0x2E 0x32 0x36 0x5F 0x5F 0x5F 0xB8 0x00 0xB9 0x00 0x00 0x00 0x6E 0xBA
0x100  0x41 0x72 0x6D 0x69 0x6E 0x73 0x5F 0x5F 0x42 0x4D 0x53 0x00 0x4A 0x4B 0x5F 0x42
0x110  0x32 0x41 0x32 0x30 0x53 0x32 0x30 0x50 0xC0 0x01
0x11A  0x00 0x00 0x00 0x00 0x68 0x00
0x120  0x00 0x51 0xCA

```
