ArminJo/JK-BMSToPylontechCAN/(threads)

Thread 5 (2023-07-30):

Troubleshooting and Warning W31 on Deye

ArminJo, 2023-07-30:
<div type='discussions-op-text'>

<sup>Originally posted by **cfi700** July 29, 2023</sup>
First of all, thanks for the great project.

While rebuilding (with Arduino Nano Clone) I noticed the following problems:
PIN SCL is not PIN A3 but PIN A5.
PIN Rx is not PIN 1 as specified but PIN 2.

If you use the cable from the RS485 adapter of the JK-BMS and follow the labeling on the board, you have to swap the lines for RX and TX on the nano.

The BigNumbers are not always displayed correctly, mostly when the current changes from two digits (e.g. 31.5 A) to one digit (e.g. 7.9 A).

The Inverter (SUN-10K-SG04LP03-EU) displays the warning "W31 Battery_comm_warn" after a short time. Nevertheless, correct data is displayed on the Deye.
</div>

ArminJo, 2023-07-30:
From Author cfi700

Hello, I have found a solution for the warning W31.
When transmitting the battery voltage, the value in the CAN frame is shifted by one decimal place.
After the change:
FrameData.Voltage100Millivolt = JKComputedData.BatteryVoltage10Millivolt;// / 10;
the voltage value is transferred correctly and the warning disappears.

ArminJo, 2023-07-30:
@cfi700 Thanks for doing the QS 👍
These and many other display bugs are fixed now.

Closed 2023-07-30.

Thread 7 (2023-08-06):

Cell Info Page with maximum and minimum indicators

cfi700, 2023-08-06:
The indicator for the maximum is not always displayed correctly (see first row).
The indicator for the minimum does not appear at all.

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

Info: I use a battery with 16 cells and have set this in the source code accordingly.

ArminJo, 2023-08-06:
What is the Serial output telling?

cfi700, 2023-08-06:
I have captured some serial information.
The indicator looks always the same (Max: left top corner) (Min: not displayed)

SOC[%]=33 -> Remaining Capacity[Ah]=66
Battery Voltage[V]=52.09, Current[A]=-20.29, Power[W]=-1056

Total Runtime Minutes=41521 -> -> 28D20H 1M

*** CELL INFO ***
1=3257 mV, 2=3258 mV, 3=3258 mV, 4=3257 mV, 5=3256 mV, 6=3257 mV, 7=3257 mV, 8=3256 mV,
9=3254 mV, 10=3256 mV, 11=3257 mV, 12=3254 mV, 13=3256 mV, 14=3256 mV, 15=3254 mV, 16=3256 mV,
Minimum=3254 mV at cell #9, Maximum=3258 mV at cell #2 of 16
Delta=4 mV, Average=3256 mV<\r>

SOC[%]=33 -> Remaining Capacity[Ah]=66
Battery Voltage[V]=52.09, Current[A]=-20.68, Power[W]=-1077

Closed 2023-08-06.

Thread 13 (2023-10-22):

Inverter read battery total capacity (norminal) wrong (50Ah) while serial log show different value (210Ah)

paulsteigel, 2023-10-22:
Hi Armin,
Today I tried a test with Arduino Uno R3 (ATMega328) at my parent's home and have the inverter connected successfully with the JK-BMS. However, Battery Capacity shown by Inverter was only 50Ah while the real value (read by Serial log was 210Ah - this is the correct number). Other values were correct such as: SOC, voltage...etc, only the total capacity of the battery was wrong!
I doubt the CAN converter module (code) have a bit of problem on calculating. Can you please be so kind to help checking this with thanks.
Yours very faithfully,
Dang Dinh Ngoc
===============QUOTE SERIAL LOG========================
C:\Users\Admin\Desktop\JK-BMSToPylontechCAN-main\JK-BMSToPylontechCAN-main\JK-BMSToPylontechCAN\JK-BMSToPylontechCAN.ino
Version 2.2.2 from Oct 19 2023
No I2C LCD connected at address 0x27
Serial to JK-BMS started with 115200 bit/s!
CAN started with 500 kbit/s!
Page switching button is at pin 2
At long press, CAN Info page is entered and additional debug data is printed as long as button is pressed
2000 ms between 2 BMS requests
2000 ms between 2 CAN transmissions
LCD Backlight timeout is 5 min

* BMS INFO *
Protocol Version Number=1
Software Version Number=11.XW_S11.272__
Modify Parameter Password=123456a@
# External Temperature Sensors=2

* BATTERY INFO *
Manufacturer Date=2310
Manufacturer Id=Input Userda210Ah0804202
Device ID String=Input Us
Device Address=1
Total Battery Capacity[Ah]=210, Low Capacity Alarm Percent=20
Charging Cycles=8
Total Charging Cycle Capacity=1710
# Battery Cells=16, Cell Count=16

* VOLTAGE PROTECTION INFO *
Battery Overvoltage Protection[mV]=56000, Undervoltage=48000
Cell Overvoltage Protection[mV]=3500, Recovery=3450, Delay[s]=5
Cell Undervoltage Protection[mV]=3000, Recovery=3050, Delay[s]=5
Cell Voltage Difference Protection[mV]=300
Discharging Overcurrent Protection[A]=80, Delay[s]=300
Charging Overcurrent Protection[A]=60, Delay[s]=30

* TEMPERATURE PROTECTION INFO *
Power MosFet Temperature Protection=100, Recovery=80
Sensor1 Temperature Protection=100, Recovery=100
Sensor1 to Sensor2 Temperature Difference Protection=20
Charge Overtemperature Protection=70, Discharge=70
Charge Undertemperature Protection=-20, Recovery=-10
Discharge Undertemperature Protection=-20, Recovery=-10

* MISC INFO *
Balance Starting Cell Voltage=[mV]2900
Balance Triggering Voltage Difference[mV]=10

Current Calibration[mA]=834
Sleep Wait Time[s]=10

Dedicated Charge Switch Active=0
Start Current Calibration State=0
Battery Actual Capacity[Ah]=210

Total Runtime Minutes=18848 ->   13D02H08M
* CELL INFO *
16 Cells, Minimum=3273 mV, Maximum=3281mV, Delta=8 mV, Average=3279 mV
 1=3280 mV,  2=3279 mV,  3=3279 mV,  4=3278 mV,  5=3279 mV,  6=3278 mV,  7=3280 mV,  8=3281 mV,
 9=3273 mV,  10=3279 mV, 11=3278 mV, 12=3279 mV, 13=3280 mV, 14=3280 mV, 15=3280 mV, 16=3281 mV,

Warning: CellOvervoltageProtectionMillivolt value 3500 mV > 3450 mV is not recommended for LiFePO4 chemistry. There is less than 1% extra capacity above 3.5V.
Temperature: Power MosFet=31, Sensor 1=27, Sensor 2=27
SOC[%]=38 -> Remaining Capacity[Ah]=79
Battery Voltage[V]=52.46, Current[A]=-9.34, Power[W]=-489, Difference to full[V]=3.5
===============END QUOTE===============================

ArminJo, 2023-10-22:
> At long press, CAN Info page is entered and additional debug data is printed as long as button is pressed

What is the output of the debug page???

paulsteigel, 2023-10-22:
Hi Armin,
Thank you for your quick response. I connected a button to pin 3 (on A) and C to Ground (my button has 4 pin) - I currently dont have a 1K resitor to limit current - sorry. The following data is printed, I dont see CAN debuging data printed. I might be wrong then!

1= 0 % |    0,  2= 0 % |    0,  3= 0 % |    0,  4= 0 % |    0,  5= 0 % |    0,  6= 0 % |    0,  7= 0 % |    0,  8= 0 % |    0,
 9=72 % |  150, 10= 0 % |    0, 11=27 % |   57, 12= 0 % |    0, 13= 0 % |    0, 14= 0 % |    0, 15= 0 % |    0, 16= 0 % |    0,
Cell Maximum percentages
 1= 2 % |    7,  2= 0 % |    0,  3= 0 % |    0,  4= 0 % |    0,  5= 0 % |    0,  6= 0 % |    0,  7= 1 % |    6,  8=18 % |   59,
 9= 0 % |    0, 10= 0 % |    0, 11= 0 % |    0, 12= 0 % |    0, 13= 2 % |    7, 14=15 % |   49, 15=16 % |   52, 16=43 % |  138,

Warning: CellOvervoltageProtectionMillivolt value 3500 mV > 3450 mV is not recommended for LiFePO4 chemistry. There is less than 1% extra capacity above 3.5V.
Charging MosFet enabled, active | Discharging MosFet enabled, active | Balancing enabled, not active
Charging MosFet enabled, active | Discharging MosFet enabled, active | Balancing enabled, active

Charging MosFet enabled, active | Discharging MosFet enabled, active | Balancing enabled, active
Charging MosFet enabled, active | Discharging MosFet enabled, active | Balancing enabled, not active
Charging MosFet enabled, active | Discharging MosFet enabled, active | Balancing enabled, active
Charging MosFet enabled, active | Discharging MosFet enabled, active | Balancing enabled, not active
Charging MosFet enabled, active | Discharging MosFet enabled, active | Balancing enabled, active
Charging MosFet enabled, active | Discharging MosFet enabled, active | Balancing enabled, not active
Charging MosFet enabled, active | Discharging MosFet enabled, active | Balancing enabled, active
Charging MosFet enabled, active | Discharging MosFet enabled, active | Balancing enabled, not active
Charging MosFet enabled, active | Discharging MosFet enabled, active | Balancing enabled, active
Battery Voltage[V]=52.44, Current[A]=-9.47, Power[W]=-496, Difference to full[V]=3.6
Charging MosFet enabled, active | Discharging MosFet enabled, active | Balancing enabled, not active
Charging MosFet enabled, active | Discharging MosFet enabled, active | Balancing enabled, active
Battery Voltage[V]=52.43, Current[A]=-9.60, Power[W]=-503, Difference to full[V]=3.6
Charging MosFet enabled, active | Discharging MosFet enabled, active | Balancing enabled, not active
Charging MosFet enabled, active | Discharging MosFet enabled, active | Balancing enabled, active
Battery Voltage[V]=52.43, Current[A]=-9.87, Power[W]=-517, Difference to full[V]=3.6
Charging MosFet enabled, active | Discharging MosFet enabled, active | Balancing enabled, not active
Charging MosFet enabled, active | Discharging MosFet enabled, active | Balancing enabled, active
Charging MosFet enabled, active | Discharging MosFet enabled, active | Balancing enabled, not active
Charging MosFet enabled, active | Discharging MosFet enabled, active | Balancing enabled, active
Battery Voltage[V]=52.43, Current[A]=-10.00, Power[W]=-524, Difference to full[V]=3.6
Battery Voltage[V]=52.43, Current[A]=-9.60, Power[W]=-503, Difference to full[V]=3.6
Charging MosFet enabled, active | Discharging MosFet enabled, active | Balancing enabled, not active
Battery Voltage[V]=52.43, Current[A]=-9.20, Power[W]=-482, Difference to full[V]=3.6
Charging MosFet enabled, active | Discharging MosFet enabled, active | Balancing enabled, active
Battery Voltage[V]=52.43, Current[A]=-9.47, Power[W]=-496, Difference to full[V]=3.6
Battery Voltage[V]=52.43, Current[A]=-9.74, Power[W]=-510, Difference to full[V]=3.6
Total Runtime Minutes=18920 ->   13D03H20M
* CELL INFO *
16 Cells, Minimum=3270 mV, Maximum=3280mV, Delta=10 mV, Average=3276 mV
 1=3279 mV,  2=3278 mV,  3=3278 mV,  4=3276 mV,  5=3278 mV,  6=3276 mV,  7=3279 mV,  8=3279 mV,
 9=3271 mV,  10=3275 mV, 11=3270 mV, 12=3276 mV, 13=3278 mV, 14=3279 mV, 15=3279 mV, 16=3280 mV,

* CELL STATISTICS *
Total balancing time=314 s ->   0D00H05M14S
Cell Minimum percentages

SOC[%]=32 -> Remaining Capacity[Ah]=67

ArminJo, 2023-10-22:
It must look like https://github.com/ArminJo/JK-BMSToPylontechCAN/blob/9f9be264ac7ef9d2e3c29954dffca267e3409461/extras/JK-BMS.log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

paulsteigel, 2023-10-22:
> It must look like
>
> https://github.com/ArminJo/JK-BMSToPylontechCAN/blob/9f9be264ac7ef9d2e3c29954dffca267e3409461/extras/JK-BMS.log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

Hi Armin,
I updated the log file and discovered that CAN data frame does not include Total Capacity in Ah. That is why the Inverter does not reflect / and or calculate and just use its default value! (50Ah).
I also update the CAN log (previous comment) for your reference then!
Ngoc

ArminJo, 2023-10-22:
I must test it for backward compatibility...

paulsteigel, 2023-10-22:
Many thanks Armin,
It will be well appreciated by many users like my country then.
Also, I am thinking of adding a mod-bus with MAXRS485 to connect several batteries in parallel (the mater will connect with converter via CAN and slave batteries will connect together using mod-bus.
Thanks again for all your supports!
Ngoc

ArminJo, 2023-10-23:
Hi Ngoc,
what is the sensible content of the 6 non capacity bytes in frame 0x35F? I guessed some values.

What is the sensible content of `SOCHighDefinition100PPM` as 3. word of frame 0x355, documented in SMA CAN protocol. I did not include it so far.

There should be no difference between the 328 versions, except if this are counterfeit versions.
My two China clone Nanos are working fine.

paulsteigel, 2023-10-24:
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

Hi Armin,
Regarding this table, I assume only the 4th and 5th are meaningful for the capacity in Ah to be sent to the inverter.
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

I am now checking a bit more with other type of batteries to see whether these can be meaningful and worth incorporating into the PylontechCAN. At the moments, the SOC is enough for the inverter to control charging/discharging.

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
What I am wondering is how the inverter can have this data for some other type of the batteries (SVE5000WM), it can read the Capacity in Ah and also apply a nice charging curve for the battery (see second image). So it means that the Inverter can request more data than we have included in the CAN message and probably have its internal charging computation so far.
Best,
Ngoc

Closed 2023-10-24.

Thread 23 (2023-12-11):

TJA1050 instead of MCP2515

anntwel98, 2023-12-11:
Hi
Can I use TJA1050 Instead of MCP2515!
How about wiring for TJA1050, It only have
Vcc,Rx,Tx and GND.

Thanks,

ArminJo, 2023-12-11:
1. This is NO issue!
2. You can use TJA1050, because it is on the MCP2515 board too, but then you must simulate the functionality of MCP2515 in software.

Closed 2023-12-11.

Thread 29 (2023-12-16):

Code Signal Flag from inverter to indicate CAN comms is working?

rooftopsolarsa, 2023-12-16:
Hey ArminJo :)

I am trying to add status LED's to show if COMMS is working or not.

On the JKBMMS side I have managed to adjust/add to the code to allow LED to be on/off depending on status of BMS comms working or not.

I have defined STATUS LED's for CAN and BMS and POWER status
Then..
AT LINE 698 in JK-BMSToPylontechCAN.ino

```
bool readJK_BMSStatusFrame() {
    sMillisOfLastReceivedByte = millis();
    uint8_t tReceiveResultCode = readJK_BMSStatusFrameByte();
    if (tReceiveResultCode == JK_BMS_RECEIVE_FINISHED) {
        /*
         * All JK-BMS status frame data received
         */

// START MY CODE HERE TO SWITCH ON LED
digitalWrite(BMS_STATUS_LED_PIN, HIGH); // Turn on LED IF BMS CONNECTED and Receiving - WORKING
// END MY CODE

        return true;

    } else if (tReceiveResultCode != JK_BMS_RECEIVE_OK) {
        /*
         * Error here
         */

// START MY CODE HERE TO SWITCH OFF LED
digitalWrite(BMS_STATUS_LED_PIN, LOW); // Turn on LED IF BMS CONNECTED and Receiving - WORKING
// END MY CODE HERE TO SWITCH OFF LED

        Serial.print(F("Receive error="));
        Serial.print(tReceiveResultCode);
        Serial.print(F(" at index"));
        Serial.println(sReplyFrameBufferIndex);
        sFrameIsRequested = false; // do not try to receive more
        sBMSFrameProcessingComplete = true;
        printJKReplyFrameBuffer();
    }
    return false;
}
```

Now I want to do the same for the CAN side.
In the code I can find where to see status if CAN Module is on or not. But I cannot find any code which shows any signal/flag/callback coming from the inverter to say all comms are working.

Currently it looks like the CAN is one-way only, sending to the inverter, and nothing coming back from the inverter?
Or advise suggest another way to know in the code if CAN is communicating or not?

ArminJo, 2023-12-17:
Yes you are right. The CAN communication is one way. I do not try to receive any response or acknowledge from the inverter, but maybe there is a response or acknowledge I am not aware of.

rooftopsolarsa, 2023-12-17:
Ok great, I thought I was going crazy to not find anything coming back from inverter.
So it will have to be enough to know the CAN MODULE is working by showing LED on.
Now I can maybe just flash the led each time CAN is sent to inverter.

In your code at line 546
```
    /*
     * Send CAN frame independently of the period of JK-BMS data requests
     * 0.5 MB/s
     * Inverter reply every second: 0x305: 00-00-00-00-00-00-00-00
     * Do not send, if BMS is starting up, the 0% SOC during this time will trigger a deye error beep.
     */
    if (sCANDataIsInitialized && !JKComputedData.BMSIsStarting
            && millis() - sMillisOfLastCANFrameSent >= MILLISECONDS_BETWEEN_CAN_FRAME_SEND) {
        sMillisOfLastCANFrameSent = millis();

          digitalWrite(CAN_STATUS_LED_PIN, LOW); // Turn OFF LED IF CAN SENT
          delay(20);
          digitalWrite(CAN_STATUS_LED_PIN, HIGH); // Turn ON LED BACK ON

        if (sDebugModeActivated) {
            Serial.println(F("Send CAN"));
        }
        sendPylontechAllCANFrames(sDebugModeActivated);
    }
```
I am just not sure how the delay(n) will affect the timing in your code?
Or do you have a better more elegant solution to flash the LED each time CAN is sent to the inverter?

ArminJo, 2023-12-17:
Thanks for the inspiration 🥇
I added code for communication status LEDs and tested it.

Closed 2023-12-17.

Thread 36 (2024-08-23):

UART received from JKBMS(B2A8S20P) needs offset to ground in order for Arduino Nano 5V to hear it.

agmkv70, 2024-08-23:
Hello, after setting up recommended design, I found out that Nano(5V 328p) wasn't hearing the BMS. It occurred that having VCC at 5.09V (when line at 1) and 5.09-2V at sending 0 was not enough to trigger RX to be heard! (2V - amplitude of BMS signal on oscilloscope)
Well, so I put a random pulldown 0.6kOhm resistor at Nano's RX and it worked just fine. Could be of use for someone else.

ArminJo, 2024-08-23:
Thanks for the hint 👍
Are you using a shottky diode in the BMS TX line, or is it a plain silizium diode?
You can mesure it with the diode range of a multimeter, the shottky diode should have 0,2 to 0.3 V.

agmkv70, 2024-08-23:
I do not use any diode now (programming needs taking the board away from the room with bms), but I tried putting in some 0.59V diode. voltage seemed to drop by about 0.5 and it still wasn't enough

ArminJo, 2024-08-23:
No diode is optimal, with a 0.59V (SI) diode it will most probably not work.
600 Ohm seems to be a bit low, can you check it with 1 or 2 k Ohm?
Depending on your results, I will document the pull down resistor in the readme then.
Thanks

agmkv70, 2024-08-23:
OK, I'll check in the evening or tomorrow

agmkv70, 2024-08-23:
I have a nice robotdyn version of nano like this: https://www.cgtrader.com/3d-models/electronics/other/arduino-nano-v3-with-microchip-atmega328p-from-robotdyn
on CH340G.
Resistor is marked as 680 Ohm, and has 673 Ohm.
Signal range on RX is just fine 3.63V max and amplitude:1.65V. So I guess no reason to even try anything else...

Closed 2024-08-23.

Thread 39 (2025-01-20):

HV BATTERY

Emiton41, 2025-01-20:
Can i use this solution to make hv battery from 10 jk pb bms in series and connect them to deye 50kwt inverter?

ArminJo, 2025-01-20:
This is a discussion, not an issue!

Closed 2025-01-20.
