ArminJo/JK-BMSToPylontechCAN/JK-BMSToPylontechCAN/JK-BMS.h

/*
 * JK-BMS.h
 *
 * Definitions of the JK-BMS class and the data structures used by JK-BMS and the converter
 *
 *  We use 6 Structures:
 *  1. JKReplyStruct - the main reply structure, containing raw BMS reply data Big Endian, which must be swapped.
 *  2. JKLastReplyStruct - copy of SOC, Uptime, Alarm and Status flags of last reply to detect changes.
 *  3. JKConvertedCellInfoStruct - including statistics (min, max, average etc.) for print and LCD usage.
 *  4. JKComputedDataStruct - swapped and computed data based on JKReplyStruct content.
 *  5. JKLastPrintedDataStruct - part of last JKComputedDataStruct to detect changes.
 *  6. CellStatisticsStruct - for minimum and maximum cell voltages statistics.
 *
 *  Copyright (C) 2023-2026  Armin Joachimsmeyer
 *
 *  This file is part of ArduinoUtils https://github.com/ArminJo/JK-BMSToPylontechCAN.
 *
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
 */

/*
 * The protocol at the display connector RS485 is 2400 baud 294 bytes in 1.2 seconds with a pause of 0.5 s.
 * It starts with A5 5A 5D 82 10 00 0F 7C-7E
 * at 0x16 there are 10 words 0F 7C-7F
 * At 0x32 there are 46 bytes 0x00 for error flags, (tested with sensor over temperature resulting in a 01 at 0x57)
 * At 0x60 there are 24 Values A5 5A 05 82 2 (0 0 to 1 7) 3 for 24 cell values
 * of 16 bit each (for the status display page) followed by the END token A5 5A 03 80 01 00
 *
 *
 */
#ifndef _JK_BMS_H
#define _JK_BMS_H

#include "SoftwareSerialTX.h"

#define JK_FRAME_START_BYTE_0   0x4E
#define JK_FRAME_START_BYTE_1   0x57
#define JK_FRAME_END_BYTE       0x68

extern uint8_t JKReplyFrameBuffer[350]; // The raw big endian data as received from JK BMS

extern char sUpTimeString[12]; // "1000D23H12M" is 11 bytes long
extern bool sUpTimeStringMinuteHasChanged;

uint8_t swap(uint8_t aByte);
uint16_t swap(uint16_t aWordToSwapBytes);
uint32_t swap(uint32_t aLongToSwapBytes);

void myPrintln(const __FlashStringHelper *aPGMString, uint8_t a8BitValue);
void myPrint(const __FlashStringHelper *aPGMString, uint8_t a8BitValue);
void myPrintln(const __FlashStringHelper *aPGMString, uint16_t a16BitValue);
void myPrint(const __FlashStringHelper *aPGMString, uint16_t a16BitValue);
void myPrintln(const __FlashStringHelper *aPGMString, int16_t a16BitValue);
void myPrint(const __FlashStringHelper *aPGMString, int16_t a16BitValue);
void myPrintlnSwap(const __FlashStringHelper *aPGMString, uint16_t a16BitValue);
void myPrintlnSwap(const __FlashStringHelper *aPGMString, int16_t a16BitValue);
void myPrintSwap(const __FlashStringHelper *aPGMString, int16_t a16BitValue);
void myPrintIntAsFloatSwap(const __FlashStringHelper *aPGMString, int16_t a16BitValue);
void myPrintlnSwap(const __FlashStringHelper *aPGMString, uint32_t a32BitValue);

struct JKCellInfoStruct {
    uint16_t CellMillivolt;
#if defined(USE_SERIAL_2004_LCD)
    uint8_t VoltageIsMinMaxOrBetween; // One of VOLTAGE_IS_MINIMUM, VOLTAGE_IS_MAXIMUM or VOLTAGE_IS_BETWEEN_MINIMUM_AND_MAXIMUM
#endif
};

struct JKConvertedCellInfoStruct {
    uint8_t ActualNumberOfCellInfoEntries;
    JKCellInfoStruct CellInfoStructArray[MAXIMUM_NUMBER_OF_CELLS];
    uint16_t MinimumCellMillivolt;
    uint8_t IndexOfMinimumCellMillivolt;
    uint16_t MaximumCellMillivolt;
    uint8_t IndexOfMaximumCellMillivolt;
    uint16_t DeltaCellMillivolt;    // Difference between MinimumVoltagCell and MaximumVoltagCell
    uint16_t RoundedAverageCellMillivolt;
};
#if defined(CAN_DATA_MODIFICATION_TOP_SOC)
uint16_t MaximumCellMillivoltAtSOC90 = 0;
#endif

#define VOLTAGE_IS_BETWEEN_MINIMUM_AND_MAXIMUM  0
#define VOLTAGE_IS_MINIMUM                      1
#define VOLTAGE_IS_MAXIMUM                      2

#if !defined(NO_CELL_STATISTICS)
/*
 * Arrays of counters, which count the times, a cell has minimal or maximal voltage
 * To identify runaway cells
 */
struct CellStatisticsStruct {
    uint16_t CellMinimumArray[MAXIMUM_NUMBER_OF_CELLS]; // Count of cell minimums
    uint16_t CellMaximumArray[MAXIMUM_NUMBER_OF_CELLS];
    uint8_t CellMinimumPercentageArray[MAXIMUM_NUMBER_OF_CELLS]; // Percentage of cell minimums
    uint8_t CellMaximumPercentageArray[MAXIMUM_NUMBER_OF_CELLS];
    uint32_t BalancingCount;            // Count of active balancing in SECONDS_BETWEEN_JK_DATA_FRAME_REQUESTS (2 seconds) units
    uint32_t LastPrintedBalancingCount; // For printing with printJKDynamicInfo()
};

#define MINIMUM_BALANCING_COUNT_FOR_DISPLAY     60 //  120 seconds / 2 minutes of balancing
#endif // NO_CELL_STATISTICS

#define JK_BMS_FRAME_HEADER_LENGTH              11
#define JK_BMS_FRAME_TRAILER_LENGTH             9
#define JK_BMS_FRAME_CELL_INFO_LENGTH           2 // 1 byte +1 for token 0x79
#define JK_BMS_FRAME_INDEX_OF_CELL_INFO_LENGTH  (JK_BMS_FRAME_HEADER_LENGTH + 1) // +1 for token 0x79
#define MINIMAL_JK_BMS_FRAME_LENGTH             19

#define TIMEOUT_MILLIS_FOR_FRAME_REPLY          100 // I measured 26 ms between request end and end of received 273 byte result
#if TIMEOUT_MILLIS_FOR_FRAME_REPLY > MILLISECONDS_BETWEEN_JK_DATA_FRAME_REQUESTS
#error "TIMEOUT_MILLIS_FOR_FRAME_REPLY must be smaller than MILLISECONDS_BETWEEN_JK_DATA_FRAME_REQUESTS to detect timeouts"
#endif

/*
 * All 16 and 32 bit values are stored byte swapped, i.e. MSB is stored in lower address.
 * Must be read with swap()
 */
struct JKFrameHeaderStruct {
    uint16_t StartFrameToken;   // 0x4E57
    uint16_t LengthOfFrame;     // Excluding StartFrameToken
    uint32_t BMS_ID;            // Highest byte is default 00
    uint8_t Function;           // 0x01 (activation), 0x02 (write), 0x03 (read), 0x05 (password), 0x06 (read all)
    uint8_t FrameSource;        // 0=BMS, 1=Bluetooth, 2=GPRS, 3=PC
    uint8_t TransportType;      // 0=Request, 1=Response, 2=BMSActiveUpload
};

struct JKFrameTailStruct {
    uint32_t RecordNumber;      // High byte is random code, low 3 bytes is record number
    uint8_t EndToken;           // 0x68
    uint16_t UnusedChecksum;    // 0x0000
    uint16_t Checksum;          // Including StartFrameToken
};

/*
 * This structure contains all converted and computed data useful for display
 * One structure per BMS
 */
struct JKComputedDataStruct {
    int16_t TemperaturePowerMosFet;     // Degree Celsius
    int16_t TemperatureSensor1;
    int16_t TemperatureSensor2;
    int16_t TemperatureMaximum;         // Computed value

    uint16_t TotalCapacityAmpereHour;
    uint16_t RemainingCapacityAmpereHour;   // Computed value
    uint16_t BatteryFullVoltage10Millivolt; // Computed by BMS! Is ActualNumberOfCellInfoEntries *  CellOvervoltageProtectionMillivolt
    uint16_t BatteryEmptyVoltage10Millivolt;
    uint16_t BatteryVoltage10Millivolt;
//    int16_t BatteryVoltageDifferenceToFull10Millivolt; // saves 60 bytes program memory :-)
    int16_t BatteryVoltageDifferenceToEmpty10Millivolt;
    float BatteryVoltageFloat;          // Volt
    int16_t Battery10MilliAmpere;       // Charging is positive discharging is negative
    float BatteryLoadCurrentFloat;      // Ampere
    int16_t BatteryLoadPower;           // Watt Computed value, Charging is positive discharging is negative
    int32_t BatteryCapacityAsAccumulator10MilliAmpere; // 500 Ah = 180,000,000 10MilliAmpereSeconds. Pre-computed capacity to compare with accumulator value.
    bool BMSIsStarting;                 // True if SOC and Cycles are both 0, for around 16 seconds during JK-BMS startup.
};

#define AMPERE_HOUR_AS_ACCUMULATOR_10_MILLIAMPERE   (3600L * 100 * MILLIS_IN_ONE_SECOND / MILLISECONDS_BETWEEN_JK_DATA_FRAME_REQUESTS) // 180000

struct JKLastPrintedDataStruct {
    int16_t TemperaturePowerMosFet;     // Degree Celsius
    int16_t TemperatureSensor1;
    int16_t TemperatureSensor2;
    float BatteryVoltageFloat;          // Volt
    int16_t BatteryLoadPower;           // Watt Computed value, Charging is positive discharging is negative
    int32_t BatteryCapacityAccumulator10MilliAmpere; // For CSV line to print every 1%
};

//#define NUMBER_OF_DEFINED_ALARM_BITS    14
#define NUMBER_OF_DEFINED_ALARM_BITS    15
#define NO_ALARM_WORD_CONTENT         0x00
#define MASK_OF_CHARGING_AND_DISCHARGING_OVERVOLTAGE_ALARM_UNSWAPPED    0x0C00
// Required for displaying specific info for this alarms
#define INDEX_OF_CHARGING_OVERVOLTAGE_ALARM                 2
#define MASK_OF_CHARGING_OVERVOLTAGE_ALARM_UNSWAPPED        0x0800
#define INDEX_OF_DISCHARGING_UNDERVOLTAGE_ALARM             3
#define MASK_OF_DISCHARGING_UNDERVOLTAGE_ALARM_UNSWAPPED    0x0400
#define INDEX_NO_ALARM                                      0xFF

union BatteryAlarmFlagsUnion {                  // 0x8B
    uint16_t AlarmsAsWord;
    struct {
        // High byte of alarms sent. Swapped value is only used locally/temporarily for display and error message output
        bool Sensor2OvertemperatureAlarm :1;    // 0x0100
        bool Sensor1Or2UndertemperatureAlarm :1; // 0x0200 Disables charging, but Has no effect on discharging
        bool CellOvervoltageAlarm :1;           // 0x0400
        bool CellUndervoltageAlarm :1;
        bool _309_A_ProtectionAlarm :1;         // 0x1000
        bool _309_B_ProtectionAlarm :1;
        bool Internal_CellVoltageIsZero :1;     // Me misuse this bit as internal "cell voltage is zero" alarm
        bool Reserved1Alarm :1;                 // Two highest bits were reserved

        // Low byte of alarms sent
        bool LowCapacityAlarm :1;               // 0x0001
        bool PowerMosFetOvertemperatureAlarm :1;
        bool ChargeOvervoltageAlarm :1;         // 0x0004 This happens quite often, if battery charging is approaching 100 %
        bool DischargeUndervoltageAlarm :1;
        bool Sensor1Or2OvertemperatureAlarm :1; // 0x0010 - Affects the charging/discharging MosFet state, not the enable flags
        /*
         * Set with delay of (Dis)ChargeOvercurrentDelaySeconds / "OCP Delay(S)" seconds initially or on retry.
         * Retry is done after "OCPR Time(S)"
         */
        bool ChargeOvercurrentAlarm :1; // 0x0020 - Set with delay of ChargeOvercurrentDelaySeconds seconds initially or on retry
        bool DischargeOvercurrentAlarm :1; // 0x0040 - Set with delay of DischargeOvercurrentDelaySeconds seconds initially or on retry
        bool CellVoltageDifferenceAlarm :1;     // 0x0080
    } AlarmBits;
};

#define STATUS_BYTE_BALANCER_MASK           0x04
#define STATUS_BYTE_CHARGE_ACTIVE_MASK      0x01
#define STATUS_BYTE_DISCHARGE_ACTIVE_MASK   0x02

union BMSStatusUnion {
    uint16_t StatusAsWord;
    uint8_t StatusAsByteArray[2]; // StatusAsByteArray[1] contains the flags
    struct {
        uint8_t ReservedStatusHighByte; // This is the low byte of StatusAsWord, but it was sent as high byte of status
        bool ChargeMosFetActive :1;     // 0x01 // Is disabled e.g. on over current or temperature
        bool DischargeMosFetActive :1;  // 0x02 // Is disabled e.g. on over current or temperature
        bool BalancerActive :1;         // 0x04
        bool BatteryDown :1;            // 0x08
        uint8_t ReservedStatus :4;
    } StatusBits;
};

struct JKMultiBMSDataStruct {
    int16_t SumOfBatteryLoadPower;
    int16_t SumOfTotalCapacityAmpereHour;
    int16_t SumOfBattery10MilliAmpere;
    bool anyAlarm;
    bool anyTimeout;
    uint16_t SumOfChargeOvercurrentProtectionAmpere;
    uint16_t SumOfDischargeOvercurrentProtectionAmpere;
    int16_t TemperatureMaximum;
    uint8_t oredStatusAsByte;
    BatteryAlarmFlagsUnion oredAlarms; // not swapped !!!
};

/*
 * Structure representing the semantic of the JK reply, except cell voltage info.
 * 221 bytes.
 *
 * All 16 and 32 bit values in this structure are filled with big endian by the JK protocol i.e. the higher byte is located at the lower memory address.
 * AVR and others are using little endian i.e. the lower byte is located at the lower memory address.
 * !!! => all 16 and 32 bit values in this structure must be "swapped" before interpreting them!!!
 *
 * All temperatures are in degree celsius.
 * Power MosFet temperature sensor is originally named PowerTube
 * Sensor1 temperature sensor is originally named Battery Box
 * Sensor2 temperature sensor is originally named Battery
 * Battery values are often originally named Total
 *
 * List of values seen in Bluetooth, but not in reply:
 * ChargeOvercurrentRecoverySeconds (Charge OCPR Time(S))
 * DischargeOvercurrentRecoverySeconds (Discharge OCPR Time(S))
 * ShortCircuitProtectionDelay  (SCP Delay(us))
 * ShortCircuitProtectionRecoverySeconds (SCPR Time(S))
 * CellPowerOffVoltage (Power Off Vol.(V))
 *
 * List of values in reply, but not in Bluetooth:
 * CellOvervoltageDelaySeconds (0x92)
 * CellUndervoltageDelaySeconds (0x95)
 */
struct JKReplyStruct {
    uint8_t TokenTemperaturePowerMosFet;    // 0x80
    uint16_t TemperaturePowerMosFet;        // 99 = 99 degree Celsius, 100 = 100, 101 = -1, 140 = -40
    uint8_t TokenTemperatureSensor1;        // 0x81 TemperatureSensor1
    uint16_t TemperatureSensor1;            // originally named Battery Box, the outmost sensor beneath the led
    uint8_t TokenTemperatureSensor2;        // 0x82
    uint16_t TemperatureSensor2;            // originally named Battery, the inner sensor beneath the battery+
    uint8_t TokenVoltage;                   // 0x83
    uint16_t Battery10Millivolt;
    uint8_t TokenCurrent;                   // 0x84
    // Current values start with 200mA at 240 mA real current -> 410 -> 620 -> 830mA@920mA real -> 1030@1080mA real -> 1.33 => Resolution is 0.21A
    uint16_t Battery10MilliAmpere; // Highest bit: 0=Discharge, 1=Charge -> depends on ProtocolVersionNumber. Maximal current is 327 A
    uint8_t TokenSOCPercent;                // 0x85
    uint8_t SOCPercent;                     // 0-100%
    uint8_t TokenNumberOfTemperatureSensors; // 0x86
    uint8_t NumberOfTemperatureSensors;     // 2
    uint8_t TokenCycles;                    // 0x87
    uint16_t Cycles;
    uint8_t TokenTotalBatteryCycleCapacity; // 0x89
    uint32_t TotalBatteryCycleCapacity;     // Ah

    uint8_t TokenNumberOfBatteryCells;      // 0x8A
    uint16_t NumberOfBatteryCells;
    uint8_t TokenBatteryAlarm;              // 0x8B
    union BatteryAlarmFlagsUnion BatteryAlarmFlags;

    uint8_t TokenBatteryStatus;                     // 0x8C
    union BMSStatusUnion BMSStatus;                 // Current status, not enabled one

    uint8_t TokenBatteryOvervoltageProtection10Millivolt; // 0x8E
    uint16_t BatteryOvervoltageProtection10Millivolt; // 1000 to 15000 BMS computed: # of cells * CellOvervoltageProtectionMillivolt
    uint8_t TokenBatteryUndervoltageProtection10Millivolt; // 0x8F
    uint16_t BatteryUndervoltageProtection10Millivolt; // 1000 to 15000 BMS computed: # of cells * CellUndervoltageProtectionMillivolt
    uint8_t TokenCellOvervoltageProtectionMillivolt;    // 0x90
    uint16_t CellOvervoltageProtectionMillivolt;        // 1000 to 4500
    uint8_t TokenCellOvervoltageRecoveryMillivolt;      // 0x91
    uint16_t CellOvervoltageRecoveryMillivolt;          // 1000 to 4500
    uint8_t TokenCellOvervoltageDelaySeconds;           // 0x92
    uint16_t CellOvervoltageDelaySeconds;               // Cannot be set by App! I received 5
    uint8_t TokenCellUndervoltageProtectionMillivolt;   // 0x93
    uint16_t CellUndervoltageProtectionMillivolt;
    uint8_t TokenCellUndervoltageRecoveryMillivolt;     // 0x94
    uint16_t CellUndervoltageRecoveryMillivolt;
    uint8_t TokenCellUndervoltageDelaySeconds;          // 0x95
    uint16_t CellUndervoltageDelaySeconds; // Cannot be set by App! I received 5 but the BMS took 100 seconds to signal an undervoltage, see CellUndervoltage.log

    uint8_t TokenVoltageDifferenceProtectionMillivolt;  // 0x96
    uint16_t VoltageDifferenceProtectionMillivolt;      // 0 to 100

    uint8_t TokenDischargeOvercurrentProtectionAmpere;  // 0x97
    uint16_t DischargeOvercurrentProtectionAmpere;      // 1 to 1000
    uint8_t TokenDischargeOvercurrentDelaySeconds;      // 0x98
    uint16_t DischargeOvercurrentDelaySeconds; // DischargeOvercurrentRecoverySeconds can be set by App, but is not contained in reply
    uint8_t TokenChargeOvercurrentProtectionAmpere;     // 0x99
    uint16_t ChargeOvercurrentProtectionAmpere;         // 1 to 1000
    uint8_t TokenChargeOvercurrentDelaySeconds;         // 0x9A
    uint16_t ChargeOvercurrentDelaySeconds;     // ChargeOvercurrentRecoverySeconds can be set by App, but is not contained in reply

    uint8_t TokenBalancingStartVoltage;                 // 0x9B
    uint16_t BalancingStartMillivolt;                   // 2000 to 4500
    uint8_t TokenBalancingStartDifferentialVoltage;     // 0x9C
    uint16_t BalancingStartDifferentialMillivolt;       // 10 to 1000
    uint8_t TokenBalancingState;                        // 0x9D
    uint8_t BalancingIsEnabled;                         // 0=off 1=on

    uint8_t TokenPowerMosFetTemperatureProtection;      // 0x9E
    uint16_t PowerMosFetTemperatureProtection;          // 0 to 100
    uint8_t TokenPowerMosFetRecoveryTemperature;        // 0x9F
    uint16_t PowerMosFetRecoveryTemperature;            // 0 to 100
    uint8_t TokenSensor1TemperatureProtection;          // 0xA0
    uint16_t Sensor1TemperatureProtection;              // 40 to 100
    uint8_t TokenSensor1RecoveryTemperature;            // 0xA1
    uint16_t Sensor1RecoveryTemperature;                // 40 to 100

    uint8_t TokenBatteryDifferenceTemperatureProtection; // 0xA2
    uint16_t BatteryDifferenceTemperatureProtection;    // 2 to 20

    uint8_t TokenChargeOvertemperatureProtection;       // 0xA3
    uint16_t ChargeOvertemperatureProtection;           // 0 to 100
    uint8_t TokenDischargeOvertemperatureProtection;    // 0xA4
    uint16_t DischargeOvertemperatureProtection;        // 0 to 100

    uint8_t TokenChargeUndertemperatureProtection;      // 0xA5
    int16_t ChargeUndertemperatureProtection;           // -45 to 25
    uint8_t TokenChargeRecoveryUndertemperature;        // 0xA6
    int16_t ChargeRecoveryUndertemperature;             // -45 to 25
    uint8_t TokenDischargeUndertemperatureProtection;   // 0xA7
    int16_t DischargeUndertemperatureProtection;        // -45 to 25
    uint8_t TokenDischargeRecoveryUndertemperature;     // 0xA8
    int16_t DischargeRecoveryUndertemperature;          // -45 to 25

    uint8_t TokenBatteryCellCount;              // 0xA9
    uint8_t BatteryCellCount;                   // 3 to 32

    uint8_t TokenTotalCapacity;                 // 0xAA
    uint32_t TotalCapacityAmpereHour;           // Ah

    uint8_t TokenChargeMosFetState;             // 0xAB
    uint8_t ChargeIsEnabled;                    // 0=off 1=on
    uint8_t TokenDischargeMosFetState;          // 0xAC
    uint8_t DischargeIsEnabled;                 // 0=off 1=on

    uint8_t TokenCurrentCalibration;            // 0xAD
    uint16_t CurrentCalibrationMilliampere;     // 100 to 20000 mA - 1039 for my BMS (factory calibration?)

    uint8_t TokenBoardAddress;                  // 0xAE
    uint8_t BoardAddress;                       // 1 -used for cascading

    uint8_t TokenBatteryType;                   // 0xAF
    uint8_t BatteryType;                       // 0 (lithium iron phosphate), 1 (ternary), 2 (lithium titanate), value is constant 1

    uint8_t TokenSleepWaitingTime;              // 0xB0
    uint16_t SleepWaitingTimeSeconds;           //

    uint8_t TokenLowCapacityAlarm;              // 0xB1
    uint8_t LowCapacityAlarmPercent;            // 0 to 80

    uint8_t TokenModifyParameterPassword;       // 0xB2
    char ModifyParameterPassword[10];           // "123456" - can be HEX

    uint8_t TokenDedicatedChargerSwitchState;   // 0xB3
    uint8_t DedicatedChargerSwitchIsActive;     // 0=off 1=on

    uint8_t TokenDeviceIdString;                // 0xB4
    char DeviceIdString[8];                // First 8 characters of the manufacturer id entered in the app field "User Private Data"

    uint8_t TokenManufacturerDate;              // 0xB5
    char ManufacturerDate[4];                   // "YYMM" - Date of first connection with app

    uint8_t TokenSystemWorkingMinutes;          // 0xB6
    uint32_t SystemWorkingMinutes;              // Minutes

    uint8_t TokenSoftwareVersionNumber;         // 0xB7
    char SoftwareVersionNumber[15];             // "11.XW_S11.26___" or from documentation: "NW_1_0_0_200428"

    uint8_t TokenStartCurrentCalibration;       // 0xB8
    uint8_t StartCurrentCalibration;            // 0=stop 1=start

    uint8_t TokenActualBatteryCapacity;         // 0xB9
    uint32_t ActualBatteryCapacityAmpereHour;   // Ah

    uint8_t TokenManufacturerId;                // 0xBA
    char ManufacturerId[24]; // First 12 characters of the 13 characters manufacturer id entered in the app field "User Private Data"
                             // followed by "JK_B2A20S20P" for my balancer

//    uint8_t TokenRestartSystem;                 // 0xBB
//    uint8_t RestartSystem;                      // 0=stop 1=restart
//    uint8_t TokenFactoryDataReset;              // 0xBC
//    uint8_t FactoryDataReset;                   // 0=stop 1=reset
//    uint8_t TokenRemoteUpgradeIdentification;   // 0xBD
//    uint8_t RemoteUpgradeIdentification;        // 0=stop 1=start
//
//    uint8_t TokenGPSTurnOffVoltage;             // 0xBE
//    uint16_t GPSTurnOffVoltageMillivolt;
//    uint8_t TokenGPSRecoveryVoltage;            // 0xBF
//    uint16_t GPSRecoveryVoltageMillivolt;

    uint8_t TokenProtocolVersionNumber;         // 0xC0
    uint8_t ProtocolVersionNumber;              // 00, 01 -> Redefine the 0x84 current data as 10 mA,
                                                // with the highest bit being 0 for discharge and 1 for charge
};

/*
 * Contains only 4 unconverted values (not in JKComputedDataStruct) which are compared witch current ones to detect changes
 */
struct JKLastReplyStruct {
    uint8_t SOCPercent;                         // 0-100% 0x85
    union BatteryAlarmFlagsUnion BatteryAlarmFlags;
    union BMSStatusUnion BMSStatus;
    uint32_t SystemWorkingMinutes;              // Minutes 0xB6
};

/*
 * Return codes for uint8_t returns
 */
#define JK_BMS_RECEIVE_ONGOING      0 // No requested or ongoing receiving
#define JK_BMS_RECEIVE_FINISHED     1
#define JK_BMS_RECEIVE_TIMEOUT      2
#define JK_BMS_RECEIVE_ERROR        3 // Received byte was not plausible

class JK_BMS {
public:
    JK_BMS();
    void init(uint8_t aTxPinNumber);
    void requestJK_BMSStatusFrame(bool aDebugModeActive);
    void RequestStatusFrame(bool aDebugModeActive);
    uint8_t readJK_BMSStatusFrameByte();
    uint8_t checkForReplyFromBMSOrTimeout();

    void printJKReplyFrameBuffer();

    /*
     * Processing functions
     */
    void fillJKComputedData();
    void fillJKConvertedCellInfo();
    void computeUpTimeString();
    void processReceivedData();

    /*
     * Print functions
     */
    void printEnabledState(bool aIsEnabled);
    void printActiveState(bool aIsActive);

#if defined(ENABLE_MONITORING)
    void setCSVString();
    void printCSVLine(char aLeadingChar = '\0');
#endif
#if !defined(NO_CELL_STATISTICS)
    void printJKCellStatisticsInfo();
#endif
    void printJKCellInfoOverview();
    void printJKCellInfo();
    void printVoltageProtectionInfo();
    void printTemperatureProtectionInfo();
    void printBatteryInfo();
    void printBMSInfo();
    void printMiscellaneousInfo();
    void detectAndPrintAlarmInfo();

    void printJKStaticInfo();
    void printJKDynamicInfo();

    int32_t getOnePercentCapacityAsAccumulator10Milliampere();
    int16_t getJKTemperature(uint16_t aJKRAWTemperature);
    int16_t getCurrent(uint16_t aJKRAWCurrent);

    /*
     * Flags for interface
     */
    bool TimeoutJustDetected = false; // Is set to true at first detection of timeout and reset by beep timeout or receiving of a frame
    bool JKBMSFrameHasTimeout;        // True, as long as BMS timeout persists.
    /*
     * sAlarmJustGetsActive is set and reset by detectAndPrintAlarmInfo() and reset by checkButtonPressForLCD() and beep handling.
     * Can also be set to true if 2 alarms are active and one of them gets inactive. If true, beep (with optional timeout) is generated.
     */
    bool AlarmJustGetsActive = false; // True if alarm bits changed and any alarm is still active. False if alarm bits changed and no alarm is active.
    bool AlarmActive = false;         // True as long as any alarm is still active. False if no alarm is active.
#if defined(USE_SERIAL_2004_LCD)
    uint8_t AlarmIndexToShowOnLCD = INDEX_NO_ALARM; // Index of current alarm to show with Alarm / Overview page. Set by detectAndPrintAlarmInfo() and reset on page switch.
#endif

    /*
     * Size of reply is 291 bytes for 16 cells. sizeof(JKReplyStruct) is 221.
     */
    uint16_t ReplyFrameLength;              // Received length of frame
    uint16_t ReplyFrameBufferIndex;         // Index of next byte to write to array, except for last byte received. Starting with 0.

    /*
     * BMS communication timeout
     */
    uint32_t MillisOfLastReceivedByte;      // For timeout detection

    /*
     * Use a 115200 baud software serial for the short request frame.
     * If available, we also can use a second hardware serial here :-).
     */
    SoftwareSerialTX TxToJKBMS;

#if defined(HANDLE_MULTIPLE_BMS)
    uint8_t NumberOfThisBMS; // The number of the BMS this class is used for. Starting with 1. => Is index of next BMS in list :-).
    static uint8_t sBMS_ArrayNextIndex;     // = number of the BMS classes instantiated.
    static JK_BMS *BMSArray[NUMBER_OF_SUPPORTED_BMS];
    static float getSumOfBatteryLoadCurrentFloat();
    static uint8_t getAverageOfBatterySOC();
    static void resetJKMultiBMSData();
#endif

    /*
     * The JKFrameAllDataStruct starts behind the header + cell data header 0x79 + CellInfoSize
     * + the variable length cell data 3 bytes per cell, (CellInfoSize is contained in JKReplyFrameBuffer[12])
     */
    JKReplyStruct *JKAllReplyPointer = reinterpret_cast<JKReplyStruct*>(&JKReplyFrameBuffer[JK_BMS_FRAME_HEADER_LENGTH + 2 + 48]); // assume 16 cells
    JKLastReplyStruct lastJKReply;
    JKComputedDataStruct JKComputedData;            // All derived converted and computed data useful for display
    JKLastPrintedDataStruct JKLastPrintedData;      // For detecting changes for printing
    JKConvertedCellInfoStruct JKConvertedCellInfo;  // The converted little endian cell voltage data
#if !defined(NO_CELL_STATISTICS)
    struct CellStatisticsStruct CellStatistics;
#endif //NO_CELL_STATISTICS
};

#endif // _JK_BMS_H
