ArminJo/JK-BMSToPylontechCAN/JK-BMSToPylontechCAN/JK-BMS_SOCHistory.hpp

/*
 * JK-BMS_SOCHistory.hpp
 *
 * Functions for computing the capacity and storing and displaying the SOC graph
 *
 * Automatic computation of ESR (Equivalent Series Resistor) = delta voltage / delta current by function readAndPrintSOCData().
 * Voltage output in graph is compensated by ESR.
 * Printout of the uncompensated voltage is forced by connecting pin DISABLE_ESR_IN_GRAPH_OUTPUT_PIN (8) to low.
 *
 * The right ESR if found by computing the sum of deltas for current ESR and ESR + 1 and ESR - 1.
 * If ESR + 1 or ESR - 1 deltas are at least 3 smaller than the current value, then the computation is run again with the ESR of the smaller value.
 *
 *  Copyright (C) 2024-2026  Armin Joachimsmeyer
 *
 *  This file is part of ArduinoUtils https://github.com/ArminJo/JK-BMSToPylontechCAN.
 *
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
 */

#ifndef _JK_BMS_SOC_HISTORY_HPP
#define _JK_BMS_SOC_HISTORY_HPP

#include <Arduino.h>
#include <limits.h>

#include "JK-BMS_SOCHistory.h"

#include "LocalDebugLevelCheck.h"
// This block must be located after the includes of other *.hpp files
//#define LOCAL_DEBUG // This enables debug output only for this file - only for development
//#define LOCAL_TRACE // This enables trace output only for this file - only for development
#include "LocalDebugLevelStart.h"

EEMEM uint8_t sBatteryESRMilliohm_EEPROM;
uint8_t sBatteryESRMilliohm;
// To consume the rest of the first 4 bytes (of a former SOCDataPointDeltaStruct)
volatile EEMEM uint8_t sFiller1_EEPROM;
volatile EEMEM uint8_t sFiller2_EEPROM;
volatile EEMEM uint8_t sFiller3_EEPROM;

/*
 * Cyclic buffer start is SOCDataPointsInfo.ArrayStartIndex and length (required if not fully written) SOCDataPointsInfo.ArrayLength
 */
EEMEM SOCDataPointDeltaStruct SOCDataPointsEEPROMArray[NUMBER_OF_SOC_DATA_POINTS]; // 255 for 1 kB EEPROM
SOCDataPointsInfoStruct SOCDataPointsInfo
#ifdef KEEP_SOC_HISTORY_ACCUMULATED_DATA_AT_RESET
__attribute__((section(".noinit")))
#endif
;

/*
 * Compute clipped 16 bit sum of 7 16 bit values from SOCDataPointsInfo.NumberOfSamples up to lastWrittenBatteryCapacityAsAccumulator10Milliampere
 */
uint16_t computeSOCDataPointsInfoChecksum() {
    uint16_t *tPointer = (uint16_t*) &SOCDataPointsInfo.NumberOfSamples;
    uint16_t tChecksum = 0;
    do {
        tChecksum += *tPointer++;
    } while (tPointer < &SOCDataPointsInfo.checksumForReboot);
    DEBUG_PRINT(F("SOCDataPointsInfoChecksum="));
    DEBUG_PRINTLN(SOCDataPointsInfo.checksumForReboot);
    return tChecksum;
}

/*
 * Is called only once in loop after receiving of first response
 */
void initializeAnalytics() {
#ifdef KEEP_SOC_HISTORY_ACCUMULATED_DATA_AT_RESET
    /*
     * If computed checksum is equal actual checksum, we assume that we had an reset
     * e.g. for displaying the Arduino Plotter graph and can reuse the contents of the accumulators,
     * especially NumberOfSamples and DeltaAccumulator10Milliampere
     */
    auto tComputedChecksum= computeSOCDataPointsInfoChecksum();
    if (tComputedChecksum != SOCDataPointsInfo.checksumForReboot) {
        // Clear only members from NumberOfSamples up to DeltaAccumulator10Milliampere
        memset(&SOCDataPointsInfo.NumberOfSamples, 0, 14);
        // Reset to computed value based on SOCPercent and TotalCapacityAmpereHour
        SOCDataPointsInfo.lastWrittenBatteryCapacityAsAccumulator10Milliampere =
                JK_BMS_1.JKComputedData.BatteryCapacityAsAccumulator10MilliAmpere;
        JK_INFO_PRINT(tComputedChecksum);
        JK_INFO_PRINT(F(" != "));
        JK_INFO_PRINT(SOCDataPointsInfo.checksumForReboot);
        JK_INFO_PRINT(F(" -> Break detected: clear"));
    } else {
        JK_INFO_PRINT(F("Reboot detected: keep"));
    }
    JK_INFO_PRINTLN(F(" SOCDataPointsInfo"));

#else
    // Reset to computed value based on SOCPercent and TotalCapacityAmpereHour
    SOCDataPointsInfo.lastWrittenBatteryCapacityAsAccumulator10Milliampere =
            JK_BMS_1.JKComputedData.BatteryCapacityAsAccumulator10MilliAmpere;
#endif
}
/*
 * Just clear the complete EEPROM
 */
void updateCompleteEEPROMTo_FF() {
    for (int i = 0; i <= E2END; ++i) {
        eeprom_update_byte((uint8_t*) i, 0xFF);
    }
    SOCDataPointsInfo.ArrayStartIndex = 0;
    SOCDataPointsInfo.ArrayLength = 0;

    Serial.println(F("Cleared EEPROM"));
}

void readBatteryESRfromEEPROM() {
    sBatteryESRMilliohm = eeprom_read_byte(&sBatteryESRMilliohm_EEPROM);
    if (sBatteryESRMilliohm > 0x30 || sBatteryESRMilliohm < 2) {
        // ESR cannot be smaller than 2 mOhm, because we use this formula: tCurrentSOCDataPoint.AverageAmpere * (sBatteryESRMilliohm - 1)
        sBatteryESRMilliohm = 10; // initial value, if EEPROM was not initialized
    }
}

/*
 * Assumes that cleared EEPROM is filled with 0xFF
 * Looks for first 0xFF entry or for a change in the SOC_EVEN_EEPROM_PAGE_INDICATION_BIT stored in SOC value.
 * Sets SOCDataPointsInfo.ArrayStartIndex and SOCDataPointsInfo.ArrayLength
 */
void findFirstSOCDataPointIndex() {

    // Default values
    uint16_t tSOCDataPointsArrayStartIndex = 0; // value if buffer was not fully written
    uint16_t tSOCDataPointsArrayLength = NUMBER_OF_SOC_DATA_POINTS; // value if SOC jump was found

    bool tStartPageIsEvenFlag;
    DEBUG_PRINTLN(F("Search for even/odd toggling"));

    for (uint16_t i = 0; i < NUMBER_OF_SOC_DATA_POINTS - 1; ++i) {
        uint8_t tSOCPercent = eeprom_read_byte(&SOCDataPointsEEPROMArray[i].SOCPercent);
        DEBUG_PRINT(F("tSOCPercent=0x"));
        DEBUG_PRINTLN(tSOCPercent, HEX);
        if (tSOCPercent == 0xFF) {
            // We found an empty entry, so EEPROM was not fully written => SOCDataPointsInfo.ArrayStartIndex is 0
            tSOCDataPointsArrayLength = i;
            break;
        }

        bool tPageIsEvenFlag = tSOCPercent & SOC_EVEN_EEPROM_PAGE_INDICATION_BIT;
        if (i == 0) {
            tStartPageIsEvenFlag = tPageIsEvenFlag; // Flag at begin of check
            SOCDataPointsInfo.currentlyWritingOnAnEvenPage = tPageIsEvenFlag;
        } else if (tStartPageIsEvenFlag ^ tPageIsEvenFlag) {
            // Here data page changes from even to odd or vice versa
#if defined(USE_LAYOUT_FOR_644_BOARD)
            JK_INFO_PRINT(F("Found even/odd toggling before index="));
            JK_INFO_PRINTLN(i);
#else
            DEBUG_PRINT(F("Found even/odd toggling before index="));
            DEBUG_PRINTLN(i);
#endif
            tSOCDataPointsArrayStartIndex = i;
            break;
        }
    }
    SOCDataPointsInfo.ArrayStartIndex = tSOCDataPointsArrayStartIndex;
    SOCDataPointsInfo.ArrayLength = tSOCDataPointsArrayLength;
}

void setESRMilliohmAndPrintDeltas(uint16_t aVoltToEmptyAccumulatedDeltasESR, uint16_t aVoltToEmptyAccumulatedDeltasNewESR,
        uint8_t aNewESRMilliohm) {

    JK_INFO_PRINT(F("Delta of "));
    JK_INFO_PRINT(sBatteryESRMilliohm);
    JK_INFO_PRINT(F(" mOhm="));
    JK_INFO_PRINT(aVoltToEmptyAccumulatedDeltasESR);
    JK_INFO_PRINT(F(", Delta of new "));
    JK_INFO_PRINT(aNewESRMilliohm);
    JK_INFO_PRINT(F(" mOhm="));
    JK_INFO_PRINTLN(aVoltToEmptyAccumulatedDeltasNewESR);
#if defined(NO_SERIAL_INFO_PRINT)
    (void) aVoltToEmptyAccumulatedDeltasESR;
    (void) aVoltToEmptyAccumulatedDeltasNewESR;
#endif
    sBatteryESRMilliohm = aNewESRMilliohm;
}

/*
 * Read and print SOC EEPROM data for Arduino Plotter
 * Compute ESR.
 * Capacity is reset to 1% on transition from SOC 0% to 1%
 */
void readAndPrintSOCData() {
    if (SOCDataPointsInfo.ArrayLength == 0) {
        return;
    }

    while (true) {
        SOCDataPointMinMaxStruct tMinimumSOCData;
        tMinimumSOCData.SOCPercent = UINT8_MAX;
        tMinimumSOCData.VoltageDifferenceToEmpty50Millivolt = INT16_MAX;
        tMinimumSOCData.CapacityAmpereHour = INT16_MAX;
        tMinimumSOCData.AverageAmpere = INT8_MAX;

        SOCDataPointMinMaxStruct tMaximumSOCData;
        tMaximumSOCData.SOCPercent = 0;
        tMaximumSOCData.VoltageDifferenceToEmpty50Millivolt = INT16_MIN;
        tMaximumSOCData.CapacityAmpereHour = INT16_MIN;
        tMaximumSOCData.AverageAmpere = INT8_MIN;

        SOCDataPointDeltaStruct tCurrentSOCDataPoint;
        auto tSOCDataPointsArrayIndex = SOCDataPointsInfo.ArrayStartIndex;
        int16_t tCurrentCapacityAmpereHour;
        int16_t tCurrentCapacity100MilliampereHour;
        int16_t tVoltageDifferenceToEmpty50Millivolt;

        /*
         * For automatic ESR computation
         */
        uint16_t tVoltToEmptyAccumulatedDeltasESR = 0;
        uint16_t tVoltToEmptyAccumulatedDeltasESRPlus1 = 0;
        uint16_t tVoltToEmptyAccumulatedDeltasESRMinus1 = 0;
        int16_t tLastVoltageDifferenceToEmpty50MillivoltESR;
        int16_t tLastVoltageDifferenceToEmpty50MillivoltESRPlus1;
        int16_t tLastVoltageDifferenceToEmpty50MillivoltESRMinus1;
        uint8_t tLastSOCPercent = 0;

//    float tDeltaTimeMinutes = 0;

        /*
         * Print 500 data points in order to shift unwanted entries out to left of plotter window
         */
        if (((499 / NUMBER_OF_SOC_DATA_POINTS) + 1) > 1) {
            Serial.println(F("1k EEPROM -> print SOC data with each entry printed twice")); // for 1 kB EEPROM
        } else {
            Serial.println(F("Print SOC data")); // for 2 kB EEPROM
        }
        // Using a bool variable requires 16 bytes more
        if (digitalReadFast(DISABLE_ESR_IN_GRAPH_OUTPUT_PIN) == LOW) {
            Serial.println(F("Pin " STR(DISABLE_ESR_IN_GRAPH_OUTPUT_PIN) " is low ->no battery ESR compensation for voltage"));
        }

        uint16_t i;
        for (i = 0; i < SOCDataPointsInfo.ArrayLength; ++i) {
            /*
             * Read EEPROM data block
             */
            eeprom_read_block(&tCurrentSOCDataPoint, &SOCDataPointsEEPROMArray[tSOCDataPointsArrayIndex],
                    sizeof(tCurrentSOCDataPoint));

            /*
             * This printout does not disturb the graph :-)
             */
            DEBUG_PRINT(F("index="));
            DEBUG_PRINT(tSOCDataPointsArrayIndex);
            DEBUG_PRINT(F(" even="));
            DEBUG_PRINT((bool) (tCurrentSOCDataPoint.SOCPercent & SOC_EVEN_EEPROM_PAGE_INDICATION_BIT));

            tCurrentSOCDataPoint.SOCPercent &= ~SOC_EVEN_EEPROM_PAGE_INDICATION_BIT; // remove indication bit

            DEBUG_PRINT(F(", SOC="));
            DEBUG_PRINT(tCurrentSOCDataPoint.SOCPercent);
            DEBUG_PRINT(F(", Diff50mV="));
            DEBUG_PRINT(tCurrentSOCDataPoint.VoltageDifferenceToEmpty50Millivolt);
            DEBUG_PRINT(F(", AverageA="));
            DEBUG_PRINT(tCurrentSOCDataPoint.AverageAmpere);
            DEBUG_PRINT(F(", Delta100mAh="));
            DEBUG_PRINTLN(tCurrentSOCDataPoint.Delta100MilliampereHour);

            if (i == 0) {
                // Initialize start value of capacity with a reasonable value
                tCurrentCapacity100MilliampereHour = (tCurrentSOCDataPoint.SOCPercent
                        * JK_BMS_1.JKComputedData.TotalCapacityAmpereHour) / 10;
                tCurrentCapacityAmpereHour = tCurrentCapacity100MilliampereHour / 10;
            }

            /*
             * Check for transition from 1 to 2 in order to reset capacity (before adding the delta) to the value of 1%
             */
            if (tLastSOCPercent == 1 && tCurrentSOCDataPoint.SOCPercent == 2) {
                tCurrentCapacity100MilliampereHour = JK_BMS_1.JKComputedData.TotalCapacityAmpereHour / 10; // * 10 / 100
                tMinimumSOCData.CapacityAmpereHour = 0; // Set minimum to 0
            }
            tLastSOCPercent = tCurrentSOCDataPoint.SOCPercent;

            /*
             * Compute minimum and maximum values for caption
             */
            if (tMinimumSOCData.SOCPercent > tCurrentSOCDataPoint.SOCPercent) {
                tMinimumSOCData.SOCPercent = tCurrentSOCDataPoint.SOCPercent;
            } else if (tMaximumSOCData.SOCPercent < tCurrentSOCDataPoint.SOCPercent) {
                tMaximumSOCData.SOCPercent = tCurrentSOCDataPoint.SOCPercent;
            }

            tCurrentCapacity100MilliampereHour += tCurrentSOCDataPoint.Delta100MilliampereHour;
            tCurrentCapacityAmpereHour = tCurrentCapacity100MilliampereHour / 10;
            if (tMinimumSOCData.CapacityAmpereHour > tCurrentCapacityAmpereHour) {
                tMinimumSOCData.CapacityAmpereHour = tCurrentCapacityAmpereHour;
            } else if (tMaximumSOCData.CapacityAmpereHour < tCurrentCapacityAmpereHour) {
                tMaximumSOCData.CapacityAmpereHour = tCurrentCapacityAmpereHour;
            }

            if (tMinimumSOCData.AverageAmpere > tCurrentSOCDataPoint.AverageAmpere) {
                tMinimumSOCData.AverageAmpere = tCurrentSOCDataPoint.AverageAmpere;
            } else if (tMaximumSOCData.AverageAmpere < tCurrentSOCDataPoint.AverageAmpere) {
                tMaximumSOCData.AverageAmpere = tCurrentSOCDataPoint.AverageAmpere;
            }

            tVoltageDifferenceToEmpty50Millivolt = tCurrentSOCDataPoint.VoltageDifferenceToEmpty50Millivolt;
            if (tVoltageDifferenceToEmpty50Millivolt > 240) {
                // Interpret values > 12 V as negative ones
                tVoltageDifferenceToEmpty50Millivolt = (int8_t) tCurrentSOCDataPoint.VoltageDifferenceToEmpty50Millivolt;
            }

            /*
             * Compensate voltage with Current * ESR
             * Show delta sum of sBatteryESRMilliohm + 1 and sBatteryESRMilliohm + 1
             * sBatteryESRMilliohm must me minimal to be correct, if one of the +1 or -1 value is smaller
             * it seems to be the more correct, than sBatteryESRMilliohm
             */
            if (digitalReadFast(DISABLE_ESR_IN_GRAPH_OUTPUT_PIN) != LOW) {
                /*
                 * Compute sum of delta values for (sBatteryESRMilliohm + 1)
                 */
                int16_t tVoltageDifferenceToEmpty50MillivoltPlus1 = tVoltageDifferenceToEmpty50Millivolt
                        - (((int16_t) tCurrentSOCDataPoint.AverageAmpere * (sBatteryESRMilliohm + 1)) / 50);
                if (i != 0) {
                    tVoltToEmptyAccumulatedDeltasESRPlus1 += abs(
                            tVoltageDifferenceToEmpty50MillivoltPlus1 - tLastVoltageDifferenceToEmpty50MillivoltESRPlus1);
                }
                tLastVoltageDifferenceToEmpty50MillivoltESRPlus1 = tVoltageDifferenceToEmpty50MillivoltPlus1;

                /*
                 * Compute sum of delta values for (sBatteryESRMilliohm - 1)
                 */
                int16_t tVoltageDifferenceToEmpty50MillivoltMinus1 = tVoltageDifferenceToEmpty50Millivolt
                        - (((int16_t) tCurrentSOCDataPoint.AverageAmpere * (sBatteryESRMilliohm - 1)) / 50);
                if (i != 0) {
                    tVoltToEmptyAccumulatedDeltasESRMinus1 += abs(
                            tVoltageDifferenceToEmpty50MillivoltMinus1 - tLastVoltageDifferenceToEmpty50MillivoltESRMinus1);
                }
                tLastVoltageDifferenceToEmpty50MillivoltESRMinus1 = tVoltageDifferenceToEmpty50MillivoltMinus1;

                /*
                 * Compute sum of delta values for sBatteryESRMilliohm
                 */
                tVoltageDifferenceToEmpty50Millivolt -= (((int16_t) tCurrentSOCDataPoint.AverageAmpere * sBatteryESRMilliohm) / 50);
                if (i != 0) {
                    tVoltToEmptyAccumulatedDeltasESR += abs(
                            tVoltageDifferenceToEmpty50Millivolt - tLastVoltageDifferenceToEmpty50MillivoltESR);
                }
                tLastVoltageDifferenceToEmpty50MillivoltESR = tVoltageDifferenceToEmpty50Millivolt;
            }

            if (tMinimumSOCData.VoltageDifferenceToEmpty50Millivolt > tVoltageDifferenceToEmpty50Millivolt) {
                tMinimumSOCData.VoltageDifferenceToEmpty50Millivolt = tVoltageDifferenceToEmpty50Millivolt;
            } else if (tMaximumSOCData.VoltageDifferenceToEmpty50Millivolt < tVoltageDifferenceToEmpty50Millivolt) {
                tMaximumSOCData.VoltageDifferenceToEmpty50Millivolt = tVoltageDifferenceToEmpty50Millivolt;
            }

            if (i < SOCDataPointsInfo.ArrayLength - 1) {
                /*
                 * ((499 / NUMBER_OF_SOC_DATA_POINTS) + 1) is 2 from 166 to 499 and 1 above
                 */
                for (uint_fast8_t j = 0; j < ((499 / NUMBER_OF_SOC_DATA_POINTS) + 1); ++j) {
                    Serial.print(tCurrentSOCDataPoint.SOCPercent);
                    Serial.print(' ');
                    Serial.print(tCurrentCapacityAmpereHour); // print capacity in Ah
                    Serial.print(' ');
                    Serial.print(tVoltageDifferenceToEmpty50Millivolt / 2);
                    Serial.print(' ');
                    Serial.print(tCurrentSOCDataPoint.AverageAmpere); // print ampere
                    Serial.println(F(" 0 0 0 0 0 0")); // to clear unwanted entries from former prints
                }

            } else {
                /*
                 * print last entry with caption
                 */
                for (uint_fast8_t j = 0; j < ((499 / NUMBER_OF_SOC_DATA_POINTS) + 1); ++j) {
                    Serial.print(F("SOC="));
                    Serial.print(tMinimumSOCData.SOCPercent);
                    Serial.print(F("%->"));
                    Serial.print(tMaximumSOCData.SOCPercent);
                    Serial.print(F("%:"));
                    Serial.print(tCurrentSOCDataPoint.SOCPercent);
                    Serial.print(F(" Cap_"));
                    Serial.print(tMinimumSOCData.CapacityAmpereHour); // Minimum Ah
                    Serial.print(F("->"));
                    Serial.print(tMaximumSOCData.CapacityAmpereHour); // Maximum Ah
                    Serial.print(F("_"));
                    Serial.print(tMaximumSOCData.CapacityAmpereHour - tMinimumSOCData.CapacityAmpereHour); // Delta Ah
                    Serial.print(F("Ah__100%_"));
                    uint16_t tTotalCapacity = ((tMaximumSOCData.CapacityAmpereHour - tMinimumSOCData.CapacityAmpereHour) * 100)
                            / (tMaximumSOCData.SOCPercent - tMinimumSOCData.SOCPercent);
                    Serial.print(tTotalCapacity);
                    Serial.print(F("Ah:"));
                    Serial.print(tCurrentCapacityAmpereHour); // print Ah
                    Serial.print(F(" VToEmpty"));
                    Serial.print(JK_BMS_1.JKComputedData.BatteryEmptyVoltage10Millivolt / 100.0, 1);
                    Serial.print('_');
                    Serial.print(swap(JK_BMS_1.JKAllReplyPointer->CellUndervoltageProtectionMillivolt) / 1000.0, 2);
                    Serial.print(F("V__"));
                    Serial.print(tMinimumSOCData.VoltageDifferenceToEmpty50Millivolt / 20.0, 2);
                    Serial.print(F("V->"));
                    Serial.print(tMaximumSOCData.VoltageDifferenceToEmpty50Millivolt / 20.0, 2);
                    Serial.print(F("V_[0.1V]:"));
                    Serial.print(tVoltageDifferenceToEmpty50Millivolt / 2);
                    Serial.print(F(" Current_"));
                    Serial.print(tMinimumSOCData.AverageAmpere);
                    Serial.print(F("A->"));
                    Serial.print(tMaximumSOCData.AverageAmpere);
                    Serial.print(F("A:"));
                    Serial.print(tCurrentSOCDataPoint.AverageAmpere);

                    if (digitalReadFast(DISABLE_ESR_IN_GRAPH_OUTPUT_PIN) != LOW) {
                        Serial.print(F(" ESR_"));
                        Serial.print(sBatteryESRMilliohm);
//#if defined(LOCAL_DEBUG)
                        Serial.print(F("mOhm_"));
                        Serial.print(tVoltToEmptyAccumulatedDeltasESR); // chosen value should be minimum
                        Serial.print(F("__"));
                        Serial.print(sBatteryESRMilliohm + 1);
                        Serial.print('_');
                        Serial.print(tVoltToEmptyAccumulatedDeltasESRPlus1); // adjacent value to proof that tVoltToEmptyAccumulatedDeltasESR is minimum
                        Serial.print(F("__"));
                        Serial.print(sBatteryESRMilliohm - 1);
                        Serial.print('_');
                        Serial.print(tVoltToEmptyAccumulatedDeltasESRMinus1); // adjacent value to proof that tVoltToEmptyAccumulatedDeltasESR is minimum
                        Serial.print(F(":0")); // does this avoid the initial peak for plotter?
//#else
//                        Serial.print(F("mOhm:0"));
//#endif

                    }

                    // to overwrite residual output of former prints
                    Serial.println(F(" _:0 _:0 _:0 _:0 _:0 _:0 _:0 _:0"));
                }

                /*
                 * If not enough data points, padding to 500 data points to guarantee,
                 * that old data is shifted out of the 500 point Arduino Serial Plotter window
                 */
                if (((499 / NUMBER_OF_SOC_DATA_POINTS) + 1) > 1) {
                    for (; i < 249; ++i) {
                        // For 1 k EEPROM print every entry twice
                        Serial.println(F(" 0 0 0 0 0 0 0 0 0 0"));
                        Serial.println(F(" 0 0 0 0 0 0 0 0 0 0"));
                    }
                } else {
                    for (; i < 499; ++i) {
                        // For 2 k EEPROM
                        Serial.println(F(" 0 0 0 0 0 0 0 0 0 0"));
                    }
                }
            }

            // Prepare for next block of cyclic buffer
            tSOCDataPointsArrayIndex = (tSOCDataPointsArrayIndex + 1) % NUMBER_OF_SOC_DATA_POINTS;
        }

        if (digitalReadFast(DISABLE_ESR_IN_GRAPH_OUTPUT_PIN) == LOW || SOCDataPointsInfo.ArrayLength < 100) {
            break; // no automatic ESR computation here
        }
        /*
         * Check if BatteryESR + 1 or BatteryESR - 1 deltas are at least 3 smaller than current value,
         * then run loop again with the ESR of the smaller value.
         */
        if (tVoltToEmptyAccumulatedDeltasESR - 3 >= tVoltToEmptyAccumulatedDeltasESRPlus1) {
            setESRMilliohmAndPrintDeltas(tVoltToEmptyAccumulatedDeltasESR, tVoltToEmptyAccumulatedDeltasESRPlus1,
                    sBatteryESRMilliohm + 1);
        } else if (tVoltToEmptyAccumulatedDeltasESR - 3 >= tVoltToEmptyAccumulatedDeltasESRMinus1 && sBatteryESRMilliohm >= 2) {
            // sBatteryESRMilliohm must be >= 2, because we use this formula above: tCurrentSOCDataPoint.AverageAmpere * (sBatteryESRMilliohm - 1)
            setESRMilliohmAndPrintDeltas(tVoltToEmptyAccumulatedDeltasESR, tVoltToEmptyAccumulatedDeltasESRMinus1,
                    sBatteryESRMilliohm - 1);
        } else {
            break; // Current BatteryESR deltas is smaller than BatteryESR + 1 and BatteryESR - 1 deltas.
        }
        // This is NOT printed for last graph :-)
        JK_INFO_PRINT(F("Set new ESR to "));
        JK_INFO_PRINTLN(sBatteryESRMilliohm);
    }
    eeprom_update_byte(&sBatteryESRMilliohm_EEPROM, sBatteryESRMilliohm); // Update final ESR value to eeprom
}

/*
 * Compute delta values and write them to EEPROM if SOC changed
 * Write additional values, if written SOC is 1% or 100% and capacity changed more than 1%.
 * Is called for every new dataset
 * Values are taken at the lower edge of SOC.
 * E.g. values for SOC 10 are written for rising SOC at SOC = 10.001 for falling SOC at 9.990
 * => we can not write values for SOC 0 with this condition!
 */
void writeSOCDataToEEPROMIfSOCChanged() {
    SOCDataPointDeltaStruct tSOCDataPoint;

    /*
     * Accumulate values at each call
     * If we charge beyond 100% SOC, because the battery is not fully charged at the level the BMS thinks it is 100%,
     * we get an positive value for the transition from 100 % to 99 % because the new 99 % learned by the BMS is bigger than the old 100 %.
     * This can happen at the start of the system, when there was no full 0% to 100% capacity cycle
     * and the BMS has not yet learned the correct capacity for 100%.
     */
    SOCDataPointsInfo.DeltaAccumulator10Milliampere += JK_BMS_1.JKComputedData.Battery10MilliAmpere; // Can hold values of +/-11930 Ah
    SOCDataPointsInfo.AverageAccumulator10Milliampere += JK_BMS_1.JKComputedData.Battery10MilliAmpere;
    SOCDataPointsInfo.AverageAccumulatorVoltageDifferenceToEmpty10Millivolt +=
            JK_BMS_1.JKComputedData.BatteryVoltageDifferenceToEmpty10Millivolt;
    SOCDataPointsInfo.NumberOfSamples++; // For one sample each 2 seconds, we can store up to 36.4 hours here.
    TRACE_PRINT(F("#Samples="));
    TRACE_PRINT(SOCDataPointsInfo.NumberOfSamples);
    TRACE_PRINT(F(", 10mA="));
    TRACE_PRINT(JK_BMS_1.JKComputedData.Battery10MilliAmpere);
    TRACE_PRINT(F(", DeltaAcc10mA="));
    TRACE_PRINTLN(SOCDataPointsInfo.DeltaAccumulator10Milliampere);

    auto tCurrentSOCPercent = JK_BMS_1.JKAllReplyPointer->SOCPercent;
    /*
     * Check for transition from 0 to 1, where we can reset residual capacity
     */
    if (JK_BMS_1.lastJKReply.SOCPercent == 0 && tCurrentSOCPercent == 1) {
//        Serial.println(F("SOC 0 -> 1 -> reset residual capacity"));
        SOCDataPointsInfo.DeltaAccumulator10Milliampere = 0; // Reset residual capacity
        SOCDataPointsInfo.lastWrittenBatteryCapacityAsAccumulator10Milliampere =
                JK_BMS_1.JKComputedData.BatteryCapacityAsAccumulator10MilliAmpere; // Reset to computed value based on SOCPercent and TotalCapacityAmpereHour
    }

    uint16_t tSOCDataPointsArrayNextWriteIndex = (SOCDataPointsInfo.ArrayStartIndex + SOCDataPointsInfo.ArrayLength)
            % NUMBER_OF_SOC_DATA_POINTS;
    uint16_t tSOCDataPointsArrayLastWriteIndex;
    if (tSOCDataPointsArrayNextWriteIndex == 0) {
        tSOCDataPointsArrayLastWriteIndex = NUMBER_OF_SOC_DATA_POINTS - 1;
    } else {
        tSOCDataPointsArrayLastWriteIndex = tSOCDataPointsArrayNextWriteIndex - 1;
    }

    auto tLastWrittenSOCPercent = eeprom_read_byte(&SOCDataPointsEEPROMArray[tSOCDataPointsArrayLastWriteIndex].SOCPercent);
    bool tLastWritingOnAnEvenPage = tLastWrittenSOCPercent & SOC_EVEN_EEPROM_PAGE_INDICATION_BIT;
    tLastWrittenSOCPercent &= ~SOC_EVEN_EEPROM_PAGE_INDICATION_BIT;

    /*
     * Allow to go down from tLastWrittenSOCPercent 1% to 0%, but do not allow to go up from tLastWrittenSOCPercent 1%
     * e.g. capacity delta is already reached from 1% to 1.9% SOC
     */
    bool tExtraCapacityChangedMoreThan1Percent = (tLastWrittenSOCPercent == 100 || tLastWrittenSOCPercent == 0
            || (tLastWrittenSOCPercent == 1 && tCurrentSOCPercent != 1))
            && abs(
                    SOCDataPointsInfo.lastWrittenBatteryCapacityAsAccumulator10Milliampere
                            - JK_BMS_1.JKComputedData.BatteryCapacityAsAccumulator10MilliAmpere)
                    > JK_BMS_1.getOnePercentCapacityAsAccumulator10Milliampere();

    if (tExtraCapacityChangedMoreThan1Percent) {
        JK_INFO_PRINTLN(F("Write data for extra capacity"));
    }

    /*
     * Write condition
     */
    if ((tExtraCapacityChangedMoreThan1Percent) || tCurrentSOCPercent > tLastWrittenSOCPercent
            || tCurrentSOCPercent < (tLastWrittenSOCPercent - 1)) {

        /*
         * Insert new entry, if last written SOC was 100% or 1% or 0% and capacity change of more than 1 %
         * Insert new entry on SOC change, but not for 100% -> 99% and 1% <-> 0%
         * First check for buffer wrap around and toggle currentlyWritingOnAnEvenPage flag
         */
        if (tSOCDataPointsArrayLastWriteIndex == (NUMBER_OF_SOC_DATA_POINTS - 1)) {
            // Here we write next entry at index 0, i.e. we start at next page, so we must switch even / odd indicator
            SOCDataPointsInfo.currentlyWritingOnAnEvenPage = !(tLastWritingOnAnEvenPage);
            JK_INFO_PRINT(F("Buffer wrap around detected, set even to "));
            JK_INFO_PRINTLN(SOCDataPointsInfo.currentlyWritingOnAnEvenPage);
        }

        if (SOCDataPointsInfo.ArrayLength == NUMBER_OF_SOC_DATA_POINTS) {
            // Array is full, overwrite old start entry
            SOCDataPointsInfo.ArrayStartIndex++;
            if (SOCDataPointsInfo.ArrayStartIndex == NUMBER_OF_SOC_DATA_POINTS) {
                SOCDataPointsInfo.ArrayStartIndex = 0; // Wrap around
            }
        } else {
            // Array is not full, increase length
            SOCDataPointsInfo.ArrayLength++;
        }

        // Compute new SOC to be written
        if (tCurrentSOCPercent > tLastWrittenSOCPercent || tExtraCapacityChangedMoreThan1Percent) {
            // Here SOC was just incremented or capacity changed
            tSOCDataPoint.SOCPercent = tCurrentSOCPercent;
        } else {
            /*
             * Here tCurrentSOCPercent < (SOCDataPointsEEPROMArray[tSOCDataPointsArrayIndex].SOCPercent - 1
             * SOC is decreasing, so we take values at the point just below the lower edge of the SOC, i.e. at upper edge of SOC - 1.
             * We take this as values for the SOC just above this edge :-).
             */
            tSOCDataPoint.SOCPercent = tCurrentSOCPercent + 1;
        }
        if (SOCDataPointsInfo.currentlyWritingOnAnEvenPage) {
            tSOCDataPoint.SOCPercent |= SOC_EVEN_EEPROM_PAGE_INDICATION_BIT;
        }

        /*
         * Compute current value and adjust accumulator
         * Use integer as intermediate value and restrict the written value to the values of a signed char
         * Adjust accumulator with the value written to avoid rounding errors.
         * We can have a residual of up to 18000 (100 mAh) after write
         */
        int tDelta100MilliampereHour = SOCDataPointsInfo.DeltaAccumulator10Milliampere
                / (CAPACITY_10_mA_ACCUMULATOR_1_AMPERE_HOUR / 10); // / 18000
        tDelta100MilliampereHour = constrain(tDelta100MilliampereHour, SCHAR_MIN, SCHAR_MAX); // clip to -128 to 128
        tSOCDataPoint.Delta100MilliampereHour = tDelta100MilliampereHour;
        SOCDataPointsInfo.DeltaAccumulator10Milliampere -= tDelta100MilliampereHour
                * (CAPACITY_10_mA_ACCUMULATOR_1_AMPERE_HOUR / 10);

        // compute average volt to empty
        long tNumberOfSamplesTimes5 = SOCDataPointsInfo.NumberOfSamples * 5L;
        tSOCDataPoint.VoltageDifferenceToEmpty50Millivolt = SOCDataPointsInfo.AverageAccumulatorVoltageDifferenceToEmpty10Millivolt
                / tNumberOfSamplesTimes5;

        /*
         * Compute average ampere
         * Must use 32 bit, since number of samples can be as high as 4000
         */
        tSOCDataPoint.AverageAmpere = SOCDataPointsInfo.AverageAccumulator10Milliampere / (tNumberOfSamplesTimes5 * 20L);

        /*
         * Write to eeprom
         */
        eeprom_write_block(&tSOCDataPoint, &SOCDataPointsEEPROMArray[tSOCDataPointsArrayNextWriteIndex], sizeof(tSOCDataPoint));

#if !defined(STANDALONE_TEST)
        JK_INFO_PRINT(F("EEPROM write of "));
        JK_INFO_PRINT(SOCDataPointsInfo.NumberOfSamples);
        JK_INFO_PRINT(F(" samples at "));
        JK_INFO_PRINT(tSOCDataPointsArrayNextWriteIndex);

        if (SOCDataPointsInfo.ArrayLength != NUMBER_OF_SOC_DATA_POINTS) {
            JK_INFO_PRINT(F(", length="));
            JK_INFO_PRINT(SOCDataPointsInfo.ArrayLength);
        }
        JK_INFO_PRINT(F(", SOC="));
        JK_INFO_PRINT(tSOCDataPoint.SOCPercent & (~SOC_EVEN_EEPROM_PAGE_INDICATION_BIT));
        JK_INFO_PRINT(F("%, VoltageDifferenceToEmpty50Millivolt="));
        JK_INFO_PRINT(tSOCDataPoint.VoltageDifferenceToEmpty50Millivolt);
        JK_INFO_PRINT(F(", AverageAmpere="));
        JK_INFO_PRINT(tSOCDataPoint.AverageAmpere);
        JK_INFO_PRINT(F(", Delta100MilliampereHour="));
        JK_INFO_PRINT(tSOCDataPoint.Delta100MilliampereHour);

        DEBUG_PRINT(F(", Left100MilliampereHour=")); // residual for next value to avoid rounding errors
        DEBUG_PRINT(SOCDataPointsInfo.DeltaAccumulator10Milliampere / (CAPACITY_10_mA_ACCUMULATOR_1_AMPERE_HOUR / 10.0), 2);
        DEBUG_PRINT(F(", even="));
        DEBUG_PRINT(SOCDataPointsInfo.currentlyWritingOnAnEvenPage);

        JK_INFO_PRINTLN();
#endif

        /*
         * Initialize for next samples
         */
        SOCDataPointsInfo.AverageAccumulator10Milliampere = 0;
        SOCDataPointsInfo.AverageAccumulatorVoltageDifferenceToEmpty10Millivolt = 0;
        SOCDataPointsInfo.NumberOfSamples = 0;
        SOCDataPointsInfo.lastWrittenBatteryCapacityAsAccumulator10Milliampere =
                JK_BMS_1.JKComputedData.BatteryCapacityAsAccumulator10MilliAmpere;
#if defined(ENABLE_MONITORING) && !defined(NO_SOC_HISTORY) && !defined(USE_NO_LCD)
        if (sLCDDisplayPage < PageSOCHistory) // Do not interfere with plotter output
#  if defined(ENABLE_MONITORING)
        {
            // Special monitoring output to generate capacity to cell voltage graphs e.g. with excel
            JK_BMS_1.printCSVLine('#');
            Serial.println();
        }
#  endif
#endif
    }

#ifdef KEEP_SOC_HISTORY_ACCUMULATED_DATA_AT_RESET
        // Update checksum
        SOCDataPointsInfo.checksumForReboot = computeSOCDataPointsInfoChecksum();
#endif
}

#include "LocalDebugLevelEnd.h"
#endif // _JK_BMS_SOC_HISTORY_HPP
