ArminJo/JK-BMSToPylontechCAN/JK-BMSToPylontechCAN/LCDBigNumbers.hpp

/*
 *  LCDBigNumbers.hpp
 *
 *  Arduino library to write big numbers on a 1602 or 2004 LCD.
 *
 *  Copyright (C) 2022-2026  Armin Joachimsmeyer
 *
 *  This file is part of LCDBigNumbers https://github.com/ArminJo/LCDBigNumbers.
 *
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
 */

#ifndef _LCD_BIG_NUMBERS_HPP
#define _LCD_BIG_NUMBERS_HPP

#include <Arduino.h>

#define ONE_COLUMN_SPACE_CHARACTER      '|' // This input character is printed as a one column space. Normal spaces are printed as a space with the width of the number.
#define ONE_COLUMN_SPACE_STRING         "|" // This input string is printed as a one column space. Normal spaces are printed as a space with the width of the number.

#define ONE_COLUMN_HYPHEN_CHARACTER      '_' // This input character is printed as a one column hyphen. Normal hyphen / minus are printed as a hyphen with the width of the number - 1.
#define ONE_COLUMN_HYPHEN_STRING         "_" // This input string is printed as a one column hyphen. Normal hyphen / minus are printed as a hyphen with the width of the number - 1.

#define VERSION_LCD_BIG_NUMBERS "1.2.3"
#define VERSION_LCD_BIG_NUMBERS_MAJOR 1
#define VERSION_LCD_BIG_NUMBERS_MINOR 2
#define VERSION_LCD_BIG_NUMBERS_PATCH 3
// The change log is at the README.md

/*
 * Macro to convert 3 version parts into an integer
 * To be used in preprocessor comparisons, such as #if VERSION_LCD_BIG_NUMBERS_HEX >= VERSION_HEX_VALUE(3, 0, 0)
 */
#define VERSION_HEX_VALUE(major, minor, patch) ((major << 16) | (minor << 8) | (patch))
#define VERSION_LCD_BIG_NUMBERS_HEX  VERSION_HEX_VALUE(VERSION_LCD_BIG_NUMBERS_MAJOR, VERSION_LCD_BIG_NUMBERS_MINOR, VERSION_LCD_BIG_NUMBERS_PATCH)

// START - This is a copy from https://github.com/ArminJo/Arduino-Utils/blob/master/src/LCDPrintUtils.hpp
//#define USE_PARALLEL_2004_LCD // Is default
//#define USE_PARALLEL_1602_LCD
//#define USE_SERIAL_2004_LCD
//#define USE_SERIAL_1602_LCD

#if !defined(USE_PARALLEL_2004_LCD) && !defined(USE_PARALLEL_1602_LCD) && !defined(USE_SERIAL_2004_LCD) && !defined(USE_SERIAL_1602_LCD)
#warning "No LCD type like USE_SERIAL_2004_LCD specified, therefore using USE_PARALLEL_2004_LCD as default"
#define USE_PARALLEL_2004_LCD    // Use parallel 2004 LCD as default
#endif

#if defined(USE_PARALLEL_2004_LCD) || defined(USE_PARALLEL_1602_LCD)
#  if defined(USE_PARALLEL_2004_LCD)
#define LCD_ROWS        4
#  else
#define LCD_ROWS        2
#  endif
#define USE_PARALLEL_LCD
#include <LiquidCrystal.h>
#else
#  if defined(USE_SERIAL_2004_LCD)
#define LCD_ROWS        4
#  else
#define LCD_ROWS        2
#  endif
#include "LiquidCrystal_I2C.hpp" // Here we use an enhanced version, which supports SoftI2CMaster
#endif
// END Copy from https://github.com/ArminJo/Arduino-Utils/blob/master/src/LCDPrintUtils.hpp

#define DEFAULT_TEST_DELAY  3000
#define NUMBER_OF_SPECIAL_CHARACTERS_IN_FONT_ARRAY  3

#define COLUMN_MASK     0x0C // Number of columns = shifted masked value + 1
#define ROW_MASK        0x03 // Number of rows = masked value + 1
#define VARIANT_MASK    0x30
// Numbers are created by using the above masks
#define BIG_NUMBERS_FONT_1_COLUMN_2_ROWS_VARIANT_1  0x01
#define BIG_NUMBERS_FONT_2_COLUMN_2_ROWS_VARIANT_1  0x05
#define BIG_NUMBERS_FONT_3_COLUMN_2_ROWS_VARIANT_1  0x09
#define BIG_NUMBERS_FONT_3_COLUMN_2_ROWS_VARIANT_2  0x19
#define BIG_NUMBERS_FONT_3_COLUMN_2_ROWS_VARIANT_3  0x29
#define BIG_NUMBERS_FONT_2_COLUMN_3_ROWS_VARIANT_1  0x06
#define BIG_NUMBERS_FONT_2_COLUMN_3_ROWS_VARIANT_2  0x16
#define BIG_NUMBERS_FONT_3_COLUMN_3_ROWS_VARIANT_1  0x0A
#define BIG_NUMBERS_FONT_3_COLUMN_4_ROWS_VARIANT_1  0x0B
#define BIG_NUMBERS_FONT_3_COLUMN_4_ROWS_VARIANT_2  0x1B

#if defined(DEBUG)
#define LOCAL_DEBUG
#else
//#define LOCAL_DEBUG // To debug/understand the writeBigNumber() function - only for development
#endif

// !!! Must be without trailing comment and closed by @formatter:on
// @formatter:off

// http://www.picbasic.co.uk/forum/showthread.php?t=13376
// 8 custom characters for 1 column font
const uint8_t bigNumbers1x2CustomPatterns_1[][8] PROGMEM = {
 { 0b11110, 0b10010, 0b10010, 0b10010, 0b10010, 0b10010, 0b10010, 0b11110 }, // 0 Closed rectangle - used for: 8, 9
 { 0b11110, 0b10010, 0b10010, 0b10010, 0b10010, 0b10010, 0b10010, 0b10010 }, // 1 Rectangle - open at bottom - 0
 { 0b10010, 0b10010, 0b10010, 0b10010, 0b10010, 0b10010, 0b10010, 0b11110 }, // 2 Rectangle - open at top - 0, 4, 6, 8
 { 0b11110, 0b00010, 0b00010, 0b00010, 0b00010, 0b00010, 0b00010, 0b11110 }, // 3 Rectangle - open at left - 3
 { 0b11110, 0b10000, 0b10000, 0b10000, 0b10000, 0b10000, 0b10000, 0b11110 }, // 4 Rectangle - open at right - 2, 5, 6
 { 0b00010, 0b00010, 0b00010, 0b00010, 0b00010, 0b00010, 0b00010, 0b00010 }, // 5 Right bar - 1, 4, 7
 { 0b11110, 0b00010, 0b00010, 0b00010, 0b00010, 0b00010, 0b00010, 0b00010 }, // 6 Top right - 2, 7
 { 0b00010, 0b00010, 0b00010, 0b00010, 0b00010, 0b00010, 0b00010, 0b11110 }  // 7 Right bottom - 3,5,9
};
const uint8_t bigNumbers1x2_1[2][13] PROGMEM = {                   // 2-line numbers
//    "-"   "."   ":"    0     1     2     3     4     5     6     7     8     9
    { 0x5F, 0xFE, 0xA5, 0x01, 0x05, 0x06, 0x03, 0x02, 0x04, 0x04, 0x06, 0x00, 0x00 },
    { 0xFE, 0x2E, 0xA5, 0x02, 0x05, 0x04, 0x07, 0x05, 0x07, 0x02, 0x05, 0x02, 0x07 }
};

// https://www.alpenglowindustries.com/blog/the-big-numbers-go-marching-2x2#/
// https://github.com/AlpenglowIndustries/Alpenglow_BigNums2x2
// 8 custom characters for Trek font
// Requires 1 0xFF block for the special "0"
const uint8_t bigNumbers2x2CustomPatterns_1[][8] PROGMEM = {
 { 0b11111, 0b11111, 0b00000, 0b00000, 0b00000, 0b00000, 0b00000, 0b00000 }, // 0
 { 0b11000, 0b11000, 0b11000, 0b11000, 0b11000, 0b11000, 0b11000, 0b11000 }, // 1
 { 0b00000, 0b00000, 0b00000, 0b00000, 0b00000, 0b00000, 0b11111, 0b11111 }, // 2
 { 0b11111, 0b11111, 0b00011, 0b00011, 0b00011, 0b00011, 0b11111, 0b11111 }, // 3
 { 0b11111, 0b11111, 0b11000, 0b11000, 0b11000, 0b11000, 0b11111, 0b11111 }, // 4
 { 0b11111, 0b11111, 0b11000, 0b11000, 0b11000, 0b11000, 0b11000, 0b11000 }, // 5
 { 0b00011, 0b00011, 0b00011, 0b00011, 0b00011, 0b00011, 0b11111, 0b11111 }, // 6
 { 0b11000, 0b11000, 0b11000, 0b11000, 0b11000, 0b11000, 0b11111, 0b11111 } // 7
};
const uint8_t bigNumbers2x2_1[2][23] PROGMEM = {                   // 2-line numbers
//    "-"   "."   ":"       0          1          2          3          4          5          6          7          8          9
    { 0xFE, 0xFE, 0xA5, 0x05,0xFF, 0x00,0x01, 0x00,0x03, 0x00,0x03, 0x01,0x01, 0x04,0x00, 0x05,0x00, 0x00,0x03, 0x04,0x03, 0x04,0x03},
    { 0x00, 0x2E, 0xA5, 0x07,0x06, 0x02,0x07, 0x04,0x02, 0x02,0x03, 0x00,0x05, 0x02,0x03, 0x04,0x03, 0xFE,0x01, 0x04,0x03, 0x02,0x06}
};


// 3x2 https://liudr.wordpress.com/2011/03/21/big-font/
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
};

// 4x4: https://github.com/wa1hco/BigFont
// @formatter:on
class LCDBigNumbers: public Print { // @suppress("Class has a virtual method and non-virtual destructor")

public:
// If activated gives linker error: undefined reference to `operator delete(void*, unsigned int)'
// If disabled I get a Eclipse warning: Class 'LCDBigNumbers' has virtual method 'flush' but non-virtual destructor
//    virtual ~LCDBigNumbers() {}
#if defined(USE_PARALLEL_LCD)
    LiquidCrystal *LCD;
#else
    LiquidCrystal_I2C *LCD;
#endif
    uint8_t NumberWidth; // Width of the rendered number not including the optional blank gap
    uint8_t NumberHeight;
    uint8_t FontVariant;
    const uint8_t (*bigNumbersCustomPatterns)[8];
    uint8_t NumberOfCustomPatterns;
    const uint8_t *bigNumbersFont;
    bool forceGapBetweenNumbers;    // The default depends on the font used
    uint8_t upperLeftColumnIndex;   // Start of the next character
    uint8_t maximumColumns; // Auto detected maximum of columns which can be written (e.g. 16 or 20). To avoid clearing the gap after a number which ends at the last column. (44 bytes program space)
    uint8_t upperLeftRowIndex;      // Start of the next character

    /*
     *
     */
    void setBigNumberCursor(uint8_t aUpperLeftColumnIndex, uint8_t aUpperLeftRowIndex = 0) {
        upperLeftColumnIndex = aUpperLeftColumnIndex;
        upperLeftRowIndex = aUpperLeftRowIndex;
    }

    size_t write(uint8_t aBigNumberValue) {
        return writeBigNumber(aBigNumberValue);
    }

    /*
     * Creates custom character used for generating big numbers
     * This also sets cursor to 0.0 by call to _createChar()
     */
    void begin() {
        maximumColumns = 0;
        // create maximum 8 custom characters
        for (uint_fast8_t i = 0; i < NumberOfCustomPatterns; i++) {
            _createChar(i, bigNumbersCustomPatterns[i]);
        }
    }

    void enableGapBetweenNumbers() {
        forceGapBetweenNumbers = true;
    }
    void disableGapBetweenNumbers() {
        forceGapBetweenNumbers = false;
    }
    void setGapBetweenNumbers(bool aForceGapBetweenNumbers) {
        forceGapBetweenNumbers = aForceGapBetweenNumbers;
    }

    /*
     * Internal function to select the appropriate font arrays
     */
    void init(const uint8_t aBigNumberFontIdentifier) {
        setBigNumberCursor(0);
        NumberWidth = ((aBigNumberFontIdentifier & COLUMN_MASK) >> 2) + 1;
        NumberHeight = (aBigNumberFontIdentifier & ROW_MASK) + 1;
        FontVariant = ((aBigNumberFontIdentifier & VARIANT_MASK) >> 4) + 1;
        NumberOfCustomPatterns = 8;
        forceGapBetweenNumbers = true;
        switch (aBigNumberFontIdentifier) {
        case BIG_NUMBERS_FONT_1_COLUMN_2_ROWS_VARIANT_1:
            bigNumbersCustomPatterns = bigNumbers1x2CustomPatterns_1;
            bigNumbersFont = (const uint8_t*) bigNumbers1x2_1;
            forceGapBetweenNumbers = false;
            break;
        case BIG_NUMBERS_FONT_2_COLUMN_2_ROWS_VARIANT_1:
            bigNumbersCustomPatterns = bigNumbers2x2CustomPatterns_1;
            bigNumbersFont = (const uint8_t*) bigNumbers2x2_1;
            break;
        case BIG_NUMBERS_FONT_3_COLUMN_2_ROWS_VARIANT_1:
            bigNumbersCustomPatterns = bigNumbers3x2CustomPatterns_1;
            bigNumbersFont = (const uint8_t*) bigNumbers3x2_1;
            NumberOfCustomPatterns = 6;
            break;
        case BIG_NUMBERS_FONT_3_COLUMN_2_ROWS_VARIANT_2:
            bigNumbersCustomPatterns = bigNumbers3x2CustomPatterns_3;
            bigNumbersFont = (const uint8_t*) bigNumbers3x2_3;
            forceGapBetweenNumbers = false;
            break;
        case BIG_NUMBERS_FONT_3_COLUMN_2_ROWS_VARIANT_3:
            bigNumbersCustomPatterns = bigNumbers3x2CustomPatterns_2;
            bigNumbersFont = (const uint8_t*) bigNumbers3x2_2;
            forceGapBetweenNumbers = false;
            break;
#if LCD_ROWS <= 2
        default:
            // ERROR: NumberHeight is greater than 2 for a 2 line display -> fallback to 2x2 font
            bigNumbersCustomPatterns = bigNumbers2x2CustomPatterns_1;
            bigNumbersFont = (const uint8_t*) bigNumbers2x2_1;
            break;
#else
        case BIG_NUMBERS_FONT_2_COLUMN_3_ROWS_VARIANT_1:
            bigNumbersCustomPatterns = bigNumbers2x3CustomPatterns_1;
            bigNumbersFont = (const uint8_t*) bigNumbers2x3_1;
            break;
        case BIG_NUMBERS_FONT_2_COLUMN_3_ROWS_VARIANT_2:
            bigNumbersCustomPatterns = bigNumbers2x3CustomPatterns_2;
            bigNumbersFont = (const uint8_t*) bigNumbers2x3_2;
            break;
        case BIG_NUMBERS_FONT_3_COLUMN_3_ROWS_VARIANT_1:
            bigNumbersCustomPatterns = bigNumbers3x3And3x4CustomPatterns_1;
            bigNumbersFont = (const uint8_t*) bigNumbers3x3_1;
            break;
        case BIG_NUMBERS_FONT_3_COLUMN_4_ROWS_VARIANT_1:
            bigNumbersCustomPatterns = bigNumbers3x3And3x4CustomPatterns_1;
            bigNumbersFont = (const uint8_t*) bigNumbers3x4_1;
            break;
        case BIG_NUMBERS_FONT_3_COLUMN_4_ROWS_VARIANT_2:
            bigNumbersCustomPatterns = bigNumbers3x4CustomPatterns_2;
            bigNumbersFont = (const uint8_t*) bigNumbers3x4_2;
            break;
#endif

        }
    }

#if defined(USE_PARALLEL_LCD)
    LCDBigNumbers(LiquidCrystal *aLCD, const uint8_t aBigNumberFontIdentifier) :
#else
    LCDBigNumbers(LiquidCrystal_I2C *aLCD, const uint8_t aBigNumberFontIdentifier) :
#endif
                    LCD(aLCD) {
        init(aBigNumberFontIdentifier);
    }

    /*
     * Like LiquidCrystal::createChar(uint8_t location, uint8_t charmap[])
     * but with PROGMEM input
     * This also sets cursor to 0.0
     */
    void _createChar(uint8_t location, const uint8_t *charmap) {
        location &= 0x7; // we only have 8 locations 0-7
        LCD->command(LCD_SETCGRAMADDR | (location << 3));
        for (int i = 0; i < 8; i++) {
            LCD->write(pgm_read_byte(charmap++));
        }
        LCD->command(LCD_SETDDRAMADDR); // set cursor to 0.0, this avoids overwriting CGRAM by next write() command.
    }

    /**
     * Draws a big digit of size aNumberWidth x aNumberHeight at cursor position
     * Special characters always have the width of 1!
     * After each number one column gap is inserted. The gap is cleared, if not at the (last + 1) column!
     * @param aNumber - byte 0x00 to 0x09 or ASCII number or one of these special characters: ' ', '|', '-', '_', '.', ':'
     * @return  The number of columns written (1 to 4 currently)
     */
    size_t writeBigNumber(uint8_t aNumberOrSpecialCharacter) {
        uint_fast8_t tFontArrayOffset = 0;
        uint_fast8_t tCharacterWidth = 1;
        /*
         * First 3 entries are the special characters
         * All non characters not compared with here, are mapped to a space with the width of the number
         */
        if (aNumberOrSpecialCharacter == '-' || aNumberOrSpecialCharacter == ONE_COLUMN_HYPHEN_CHARACTER) {
            // here we have the initial values: tFontArrayOffset = 0; and tCharacterWidth = 1;
        } else if (aNumberOrSpecialCharacter == '.') {
            tFontArrayOffset = 1;
        } else if (aNumberOrSpecialCharacter == ':') {
            tFontArrayOffset = 2;
        } else if (aNumberOrSpecialCharacter == ' ') {
            tCharacterWidth = NumberWidth;
        } else if (aNumberOrSpecialCharacter == ONE_COLUMN_SPACE_CHARACTER) {
            // print a one column space
            aNumberOrSpecialCharacter = ' ';
        } else {
            /*
             * Here we have numbers only
             */
            if (aNumberOrSpecialCharacter > 9) {
                // if not byte 0x00 to 0x09, convert ASCII character to number
                aNumberOrSpecialCharacter -= '0';
            }
            if (aNumberOrSpecialCharacter > 9) {
                // If we do not have a number 0 to 9 now, we convert it to a space with the width of a number
                aNumberOrSpecialCharacter = ' ';
            }
            tCharacterWidth = NumberWidth;
            tFontArrayOffset = NUMBER_OF_SPECIAL_CHARACTERS_IN_FONT_ARRAY + (aNumberOrSpecialCharacter * tCharacterWidth);
        }
#if defined(LOCAL_DEBUG)
        Serial.print(F("Number="));
        Serial.print(aNumberOrSpecialCharacter);
        Serial.print(F(" CharacterWidth="));
        Serial.print(tCharacterWidth);
        Serial.print(F(" FontArrayOffset="));
        Serial.print(tFontArrayOffset);
        Serial.print(F(" ColunmOffset="));
        Serial.println(upperLeftColumnIndex);
#endif
        const uint8_t *tArrayPtr = bigNumbersFont + tFontArrayOffset;
        // Render character row by row
        for (uint_fast8_t tRow = 0; tRow < NumberHeight; tRow++) {
            LCD->setCursor(upperLeftColumnIndex, upperLeftRowIndex + tRow);
            // Render all columns in a row
            for (uint_fast8_t i = 0; i < tCharacterWidth; i++) {
                uint8_t tCharacterIndex;
                if (aNumberOrSpecialCharacter == ' ') {
                    tCharacterIndex = ' '; // Blank
                } else {
                    tCharacterIndex = pgm_read_byte(tArrayPtr);
                }
                LCD->write(tCharacterIndex);
                tArrayPtr++; // Prepare for next column, we do not use i
#if defined(LOCAL_DEBUG)
                Serial.print(F(" 0x"));
                Serial.print(tCharacterIndex, HEX);
                Serial.print(F(" 0x"));
                Serial.print((uint16_t) tArrayPtr, HEX);
#endif
            }
            tArrayPtr += NUMBER_OF_SPECIAL_CHARACTERS_IN_FONT_ARRAY + (NumberWidth - tCharacterWidth) + (9 * NumberWidth); // Next array row
#if defined(LOCAL_DEBUG)
            Serial.print('|');
#endif
        }
        upperLeftColumnIndex += tCharacterWidth; // now we are at the index for the next number or the optional blank gap

        /*
         * Auto detect maximum column count, which can be written.
         * We assume that all characters, which were written, fit on the display.
         * Thus the maximum of the upperLeftColumnIndex after write is the index of the first column after the display and maximum possible column count.
         */
        if (maximumColumns < upperLeftColumnIndex) {
            // find maximum column at runtime
            maximumColumns = upperLeftColumnIndex;
        }

        /*
         * Implement the gap after the number character
         */
        if (forceGapBetweenNumbers && (NumberWidth == 1 || tCharacterWidth > 1 || aNumberOrSpecialCharacter == '-')) {
            if (maximumColumns >= upperLeftColumnIndex) {
                // We are not at the last column, so clear the gap after the number
                for (uint_fast8_t tRow = 0; tRow < NumberHeight; tRow++) {
                    LCD->setCursor(upperLeftColumnIndex, upperLeftRowIndex + tRow);
                    LCD->write(' '); // Blank
                }
                tCharacterWidth++;
            }
            upperLeftColumnIndex++; // This provides one column gap between numbers, but not between special characters.
        }

#if defined(LOCAL_DEBUG)
        Serial.println();
#endif
        return tCharacterWidth;
    }

    /**
     * Draws a big digit of size aNumberWidth x aNumberHeight
     * @param aNumber - Number to display, if > 9 a blank character is drawn
     * @param aUpperLeftColumnIndex - Starts with 0, no check!
     * @param aStartRowIndex - Starts with 0, no check!
     */
    size_t writeAt(uint8_t aNumber, uint8_t aUpperLeftColumnIndex, uint8_t aUpperLeftRowIndex = 0) {
        setBigNumberCursor(aUpperLeftColumnIndex, aUpperLeftRowIndex);
        return writeBigNumber(aNumber);
    }

};

/*
 * Print all fonts, used in screenshots, using one object
 */
#if defined(USE_PARALLEL_LCD)
void testBigNumbers(LiquidCrystal *aLCD)
#else
void testBigNumbers(LiquidCrystal_I2C *aLCD)
#endif
        {
    /*
     * 1 X 2
     */
    aLCD->clear(); // Clear display
    // Allocate object
    LCDBigNumbers bigNumberLCD(aLCD, BIG_NUMBERS_FONT_1_COLUMN_2_ROWS_VARIANT_1);
    bigNumberLCD.begin(); // Generate font symbols in LCD controller
    bigNumberLCD.print(F("0123456789 -.:")); // no special space required, we have an 1 column font

    // Print "-42.38 :"
    bigNumberLCD.setBigNumberCursor(0, 2);
    bigNumberLCD.print(F("-42.38"));
    delay(DEFAULT_TEST_DELAY);

    /*
     * 2 X 2
     */
    aLCD->clear(); // Clear display
    // Reconfigure existing object to hold another font
    bigNumberLCD.init(BIG_NUMBERS_FONT_2_COLUMN_2_ROWS_VARIANT_1);
    bigNumberLCD.begin(); // Generate font symbols in LCD controller
    bigNumberLCD.print(F("01234"));
#if LCD_ROWS <= 2
    delay(DEFAULT_TEST_DELAY);
    bigNumberLCD.setBigNumberCursor(0);
    bigNumberLCD.print(F("56789"));
    delay(DEFAULT_TEST_DELAY);
    bigNumberLCD.setBigNumberCursor(0);
    bigNumberLCD.print(F("-.: "));
#else
    bigNumberLCD.setBigNumberCursor(0, 2);
    bigNumberLCD.print(F("56789" ONE_COLUMN_SPACE_STRING "-.:"));
#endif
    delay(DEFAULT_TEST_DELAY);

    aLCD->clear(); // Clear display
    // Print "-42.38 :"
    bigNumberLCD.setBigNumberCursor(0);
    bigNumberLCD.print(F("-42.38"));
    delay(DEFAULT_TEST_DELAY);

    /*
     * 3 X 2 1. variant
     */
    aLCD->clear(); // Clear display
    bigNumberLCD.init(BIG_NUMBERS_FONT_3_COLUMN_2_ROWS_VARIANT_1);
    bigNumberLCD.begin();

#if LCD_ROWS <= 2
    bigNumberLCD.print(F("0123"));
    delay(DEFAULT_TEST_DELAY);
    bigNumberLCD.setBigNumberCursor(0);
    bigNumberLCD.print(F("4567"));
    delay(DEFAULT_TEST_DELAY);
    bigNumberLCD.setBigNumberCursor(0);
    bigNumberLCD.print(F("89" ONE_COLUMN_SPACE_STRING "-.: "));
#else
    bigNumberLCD.print(F("01234"));
    bigNumberLCD.setBigNumberCursor(0, 2);
    bigNumberLCD.print(F("56789"));
    delay(DEFAULT_TEST_DELAY);

    aLCD->clear(); // Clear display
    // Print "-42.38 :"
    bigNumberLCD.setBigNumberCursor(0);
    bigNumberLCD.print(F("-42.38:"));
#endif

    delay(DEFAULT_TEST_DELAY);

    /*
     * 3 X 2 2. variant
     */
    aLCD->clear(); // Clear display
    bigNumberLCD.init( BIG_NUMBERS_FONT_3_COLUMN_2_ROWS_VARIANT_2);
    bigNumberLCD.begin();
    bigNumberLCD.print(F("01234"));
#if LCD_ROWS <= 2
    delay(DEFAULT_TEST_DELAY);
    bigNumberLCD.setBigNumberCursor(0);
    bigNumberLCD.print(F("56789"));
    delay(DEFAULT_TEST_DELAY);
    bigNumberLCD.setBigNumberCursor(0);
    bigNumberLCD.print(F("-.: "));
#else
    bigNumberLCD.setBigNumberCursor(0, 2);
    bigNumberLCD.print(F("56789")); // we have a space between this characters, i.e. forceGapBetweenNumbers is true
#endif
    delay(DEFAULT_TEST_DELAY);

    aLCD->clear(); // Clear display
    // Print "-42.38 :"
    bigNumberLCD.setBigNumberCursor(0);
    bigNumberLCD.print(F("-42.38:"));
    delay(DEFAULT_TEST_DELAY);

    /*
     * 3 X 2 3. variant
     */
    aLCD->clear(); // Clear display
    bigNumberLCD.init( BIG_NUMBERS_FONT_3_COLUMN_2_ROWS_VARIANT_3);
    bigNumberLCD.begin();
    bigNumberLCD.print(F("01234"));
#if LCD_ROWS <= 2
    delay(DEFAULT_TEST_DELAY);
    bigNumberLCD.setBigNumberCursor(0);
    bigNumberLCD.print(F("56789"));
    delay(DEFAULT_TEST_DELAY);
    bigNumberLCD.setBigNumberCursor(0);
    bigNumberLCD.print(F("-.: "));
#else
    bigNumberLCD.setBigNumberCursor(0, 2);
    bigNumberLCD.print(F("56789" ONE_COLUMN_SPACE_STRING "-.:"));
#endif
    delay(DEFAULT_TEST_DELAY);

    aLCD->clear(); // Clear display
    // Print "-42.38 :"
    bigNumberLCD.setBigNumberCursor(0);
    bigNumberLCD.print(F("-42.38"));
    delay(DEFAULT_TEST_DELAY);

#if LCD_ROWS > 2
    /****************
     * 3 line numbers
     ****************/
    /*
     * 2 X 3 Space above
     */
    aLCD->clear(); // Clear display
    bigNumberLCD.init(BIG_NUMBERS_FONT_2_COLUMN_3_ROWS_VARIANT_1);
    bigNumberLCD.begin();
    bigNumberLCD.setBigNumberCursor(0, 1);
    bigNumberLCD.print(F("01234"));
    delay(DEFAULT_TEST_DELAY);
    bigNumberLCD.setBigNumberCursor(0, 1);
    bigNumberLCD.print(F("56789" ONE_COLUMN_SPACE_STRING "-.:"));
    delay(DEFAULT_TEST_DELAY);

    aLCD->clear(); // Clear display
    // Print "-42.38 :"
    bigNumberLCD.setBigNumberCursor(0, 1);
    bigNumberLCD.print(F("-42.38"));
    delay(DEFAULT_TEST_DELAY);

    /*
     * 2 X 3 Space below
     */
    aLCD->clear(); // Clear display
    bigNumberLCD.init( BIG_NUMBERS_FONT_2_COLUMN_3_ROWS_VARIANT_2);
    bigNumberLCD.begin();
    bigNumberLCD.setBigNumberCursor(0, 1);
    bigNumberLCD.print(F("01234"));
    delay(DEFAULT_TEST_DELAY);
    bigNumberLCD.setBigNumberCursor(0, 1);
    bigNumberLCD.print(F("56789" ONE_COLUMN_SPACE_STRING "-.:"));
    delay(DEFAULT_TEST_DELAY);

    aLCD->clear(); // Clear display
    // Print "-42.38 :"
    bigNumberLCD.setBigNumberCursor(0, 1);
    bigNumberLCD.print(F("-42.38"));
    delay(DEFAULT_TEST_DELAY);

    /*
     * 3 X 3 Space below
     */
    aLCD->clear(); // Clear display
    bigNumberLCD.init(BIG_NUMBERS_FONT_3_COLUMN_3_ROWS_VARIANT_1);
    bigNumberLCD.begin();
    bigNumberLCD.setBigNumberCursor(0, 1);
    bigNumberLCD.print(F("01234"));
    delay(DEFAULT_TEST_DELAY);
    bigNumberLCD.setBigNumberCursor(0, 1);
    bigNumberLCD.print(F("56789"));
    delay(DEFAULT_TEST_DELAY);

    aLCD->clear(); // Clear display
    // Print "-42.38 :"
    bigNumberLCD.setBigNumberCursor(0, 1);
    bigNumberLCD.print(F("-42.38:"));
    delay(DEFAULT_TEST_DELAY);

    /****************
     * 4 line numbers
     ****************/
    /*
     * 3 X 4
     */
    aLCD->clear(); // Clear display
    bigNumberLCD.init( BIG_NUMBERS_FONT_3_COLUMN_4_ROWS_VARIANT_1);
    bigNumberLCD.begin();
    bigNumberLCD.print(F("01234"));
    delay(DEFAULT_TEST_DELAY);
    bigNumberLCD.setBigNumberCursor(0);
    bigNumberLCD.print(F("56789"));
    delay(DEFAULT_TEST_DELAY);

    aLCD->clear(); // Clear display
    // Print "-42.38 :"
    bigNumberLCD.setBigNumberCursor(0);
    bigNumberLCD.print(F("-42.38:"));
    delay(DEFAULT_TEST_DELAY);

    /*
     * Variant 2
     */
    aLCD->clear(); // Clear display
    bigNumberLCD.init( BIG_NUMBERS_FONT_3_COLUMN_4_ROWS_VARIANT_2);
    bigNumberLCD.begin();
    bigNumberLCD.print(F("01234"));
    delay(DEFAULT_TEST_DELAY);
    bigNumberLCD.setBigNumberCursor(0);
    bigNumberLCD.print(F("56789"));
    delay(DEFAULT_TEST_DELAY);

    aLCD->clear(); // Clear display
    // Print "-42.38 :"
    bigNumberLCD.setBigNumberCursor(0);
    bigNumberLCD.print(F("-42.38:"));
    delay(DEFAULT_TEST_DELAY);
#endif // LCD_ROWS > 2
}

#if defined(LOCAL_DEBUG)
#undef LOCAL_DEBUG
#endif
#endif // _LCD_BIG_NUMBERS_HPP
