ArminJo/JK-BMSToPylontechCAN/JK-BMSToPylontechCAN/HexDump.hpp

/*
 * HexDump.hpp
 * Hex memory dump utility functions for Arduino.
 * 0x00 and 0xFF are printed as spaces, values above 0x80 are printed as '.'.
 *
 * Sample output:
 * 0x0000:  0xF1 0x81 0x82 0x00 0x08 0x02 0x00 0x27 0xFF 0xFF 0x0E 0xB3 0x81 0xFC 0x9B 0x47  ... .. '  .....G
 * 0x0020:  0x00 0x00 0x00 0x00 0x20 0x65 0x00 0x0F 0xBE 0xEB 0x9B 0x98 0x2C 0xF1 0x08 0x2C       e .....,..,
 *
 *  Copyright (C) 2022-2024  Armin Joachimsmeyer
 *
 *  This file is part of Arduino-Utils https://github.com/ArminJo/Arduino-Utils.
 *
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
 *  You should have received a copy of the GNU General Public License
 *  along with this program. If not, see <http://www.gnu.org/licenses/gpl.html>.
 */

#ifndef _HEX_DUMP_HPP
#define _HEX_DUMP_HPP

#include <Arduino.h>

// Next lines are a copy of the HexDump.h content
#define _16_BYTES_PER_LINE  16

#define HEX_DUMP_FORMAT_16_BIT_ABSOLUTE_ADDRESS 0x00 // Print 16 bit absolute address
#define HEX_DUMP_FORMAT_NO_ADDRESS_AT_ALL       0x01 // Bit 0: else print
#define HEX_DUMP_FORMAT_RELATIVE_ADDRESS        0x02 // Bit 1: else absolute address
#define HEX_DUMP_FORMAT_8_BIT_ADDRESS           0x04 // Bit 2: else 16 bit Address
#define HEX_DUMP_FORMAT_ASCII_VALUES            0x08 // default

void printBufferHex(uint8_t *aBufferAddress, uint16_t aNumberOfBytesToPrint); // Prints no address and hex bytes without ASCII representation.
void printBufferHexDump(uint8_t *aBufferAddress, uint16_t aNumberOfBytesToPrint); // Prints short relative address and hex bytes without ASCII representation.
void printBufferHexAndASCIIDump(uint8_t *aBufferAddress, uint16_t aNumberOfBytesToPrint); // Prints short relative address and hex bytes without ASCII representation.
void printMemoryHexNoASCIIDump(uint8_t *aMemoryAddress, uint16_t aNumberOfBytesToPrint); // Prints 16 bit address and hex bytes with ASCII representation.
void printMemoryHexAndASCIIDump(uint8_t *aMemoryAddress, uint16_t aNumberOfBytesToPrint); // Prints 16 bit address and hex bytes with ASCII representation.
void printStackMemory(uint16_t aNumberOfBytesToPrint); // Prints 16 bit address and hex bytes ending at top of stack / RAM end.
void printStackDump(); // Prints 16 bit address and hex bytes starting at current stackpointer and ending at ending at top of stack / RAM end.
void printMemoryHexDump(uint8_t *aMemory, uint16_t aSizeOfMemoryToPrint, uint8_t aBytesPerLine = _16_BYTES_PER_LINE,
        uint8_t aFormatFlags = HEX_DUMP_FORMAT_ASCII_VALUES);
void printBytePaddedHex(uint8_t aHexValueToPrint);
void printWordPaddedHex(uint16_t aHexValueToPrint);
// End of the copy of the HexDump.h content

/*
 * Prints no address and hex bytes without ASCII representation.
 */
void printBufferHex(uint8_t *aBufferAddress, uint16_t aNumberOfBytesToPrint) {
    printMemoryHexDump(aBufferAddress, aNumberOfBytesToPrint, _16_BYTES_PER_LINE, HEX_DUMP_FORMAT_NO_ADDRESS_AT_ALL);
}
/*
 * Prints short relative address and hex bytes without ASCII representation.
 */
void printBufferHexDump(uint8_t *aBufferAddress, uint16_t aNumberOfBytesToPrint) {
    printMemoryHexDump(aBufferAddress, aNumberOfBytesToPrint, _16_BYTES_PER_LINE,
    HEX_DUMP_FORMAT_8_BIT_ADDRESS | HEX_DUMP_FORMAT_RELATIVE_ADDRESS);
}
/*
 * Prints short relative address and hex bytes without ASCII representation.
 */
void printBufferHexAndASCIIDump(uint8_t *aBufferAddress, uint16_t aNumberOfBytesToPrint) {
    printMemoryHexDump(aBufferAddress, aNumberOfBytesToPrint, _16_BYTES_PER_LINE,
    HEX_DUMP_FORMAT_8_BIT_ADDRESS | HEX_DUMP_FORMAT_RELATIVE_ADDRESS | HEX_DUMP_FORMAT_ASCII_VALUES);
}

/*
 * Prints 16 bit address and hex bytes with ASCII representation.
 */
void printMemoryHexNoASCIIDump(uint8_t *aMemoryAddress, uint16_t aNumberOfBytesToPrint) {
    printMemoryHexDump(aMemoryAddress, aNumberOfBytesToPrint, _16_BYTES_PER_LINE, HEX_DUMP_FORMAT_16_BIT_ABSOLUTE_ADDRESS);
}

/*
 * Prints 16 bit address and hex bytes starting at current stackpointer and ending at ending at top of stack / RAM end.
 */
void printStackDump() {
    Serial.print(F("Caller address=(0x"));
    uint16_t tCallerAddress = (uint16_t) __builtin_return_address(0);
    Serial.print(tCallerAddress, HEX);
    Serial.print(F(" << 1)=0x"));
    Serial.println(tCallerAddress << 1, HEX);
    Serial.flush();
    printMemoryHexDump((uint8_t*) SP, (RAMEND - SP) + 1, _16_BYTES_PER_LINE, HEX_DUMP_FORMAT_16_BIT_ABSOLUTE_ADDRESS);
    // Print multiple of 16 bytes
//    printMemoryHexDump((uint8_t*) (SP & 0xFFF0), ((RAMEND - SP) | 0x000F) + 1, _16_BYTES_PER_LINE, HEX_DUMP_FORMAT_16_BIT_ABSOLUTE_ADDRESS);
}

/*
 * Prints 16 bit address and hex bytes ending at top of stack / RAM end.
 */
void printStackMemory(uint16_t aNumberOfBytesToPrint) {
    Serial.print(F("SP=0x"));
    Serial.print((uint16_t) SP, HEX);
    Serial.print(F(", caller address=(0x"));
    uint16_t tCallerAddress = (uint16_t) __builtin_return_address(0);
    Serial.print(tCallerAddress, HEX);
    Serial.print(F(" << 1) =0x"));
    Serial.println(tCallerAddress << 1, HEX);

    uint8_t *tMemoryAddress = (uint8_t*) ((RAMEND + 1) - aNumberOfBytesToPrint);
    printMemoryHexDump(tMemoryAddress, aNumberOfBytesToPrint, _16_BYTES_PER_LINE, HEX_DUMP_FORMAT_16_BIT_ABSOLUTE_ADDRESS);
}

/*
 * Prints 16 bit address and hex bytes with ASCII representation.
 * like printMemoryHexDump(aMemoryAddress, aNumberOfBytesToPrint), because of default parameter
 */
void printMemoryHexAndASCIIDump(uint8_t *aMemoryAddress, uint16_t aNumberOfBytesToPrint) {
    printMemoryHexDump(aMemoryAddress, aNumberOfBytesToPrint, _16_BYTES_PER_LINE, HEX_DUMP_FORMAT_ASCII_VALUES);
}

/**
 * Prints lines of memory content
 * 0x0000:  0xF1 0x81 0x82 0x00 0x08 0x02 0x00 0x27 0xFF 0xFF 0x0E 0xB3 0x81 0xFC 0x9B 0x47  ... .. '  .....G
 * @param aNumberOfBytesToPrint     Number of lines to print are: (aSizeOfMemoryToPrint/BYTES_PER_LINE) + 1
 * @param aBytesPerLine             Number of bytes in one line
 * @param aFormatFlags              See definitions above
 */
void printMemoryHexDump(uint8_t *aMemory, uint16_t aNumberOfBytesToPrint, uint8_t aBytesPerLine, uint8_t aFormatFlags) {
    uint16_t tIndex = 0;
    while (true) {
        if (aBytesPerLine > aNumberOfBytesToPrint) {
            // last line
            aBytesPerLine = aNumberOfBytesToPrint;
        }

        if (aBytesPerLine == 0) {
            break;
        } else {
            aNumberOfBytesToPrint -= aBytesPerLine;
            if ((aFormatFlags & HEX_DUMP_FORMAT_NO_ADDRESS_AT_ALL) == 0) {
                /*
                 * Print address in different formats
                 */
                uint16_t tAddress = tIndex;
                if ((aFormatFlags & HEX_DUMP_FORMAT_RELATIVE_ADDRESS) == 0) {
                    tAddress += (uint16_t) aMemory;
                }
                if ((aFormatFlags & HEX_DUMP_FORMAT_8_BIT_ADDRESS) != 0) {
                    printBytePaddedHex(tAddress);
                } else {
                    printWordPaddedHex(tAddress);
                }
                Serial.print(F(": "));
            }

            /*
             * print hex bytes
             */
            for (uint_fast8_t i = 0; i < aBytesPerLine; i++) {
                printBytePaddedHex(aMemory[tIndex + i]);
            }

            if ((aFormatFlags & HEX_DUMP_FORMAT_ASCII_VALUES) != 0) {
                /*
                 * print bytes ASCII representation
                 */
                Serial.print(F("  "));
                for (uint_fast8_t i = 0; i < aBytesPerLine; i++) {
                    uint8_t tCharacterToPrint = aMemory[tIndex + i];
//            if(isalnum(tIndex+i)){ // requires 40 bytes more program space
                    if (' ' <= tCharacterToPrint && tCharacterToPrint <= '~') {
                        Serial.print((char) tCharacterToPrint);
                    } else if (tCharacterToPrint != 0x00 && tCharacterToPrint != 0xFF) {
                        // for non printable characters except 0 and FF
                        Serial.print('.');
                    } else {
                        Serial.print(' ');
                    }
                }
            }
            Serial.flush();
            Serial.println();
            tIndex += aBytesPerLine;
        }
    }
}

/*
 * Print with leading space and "0x" and padded with 0
 */
void printBytePaddedHex(uint8_t aHexValueToPrint) {
    Serial.print(F(" 0x"));
    if (aHexValueToPrint < 0x10) {
        Serial.print('0');
    }
    Serial.print(aHexValueToPrint, HEX);
}

void printWordPaddedHex(uint16_t aHexValueToPrint) {
    Serial.print(F("0x"));
    if (aHexValueToPrint < 0x1000) {
        Serial.print('0');
    }
    if (aHexValueToPrint < 0x100) {
        Serial.print('0');
    }
    if (aHexValueToPrint < 0x10) {
        Serial.print('0');
    }
    Serial.print(aHexValueToPrint, HEX);
}
#endif // _HEX_DUMP_HPP
