ArminJo/JK-BMSToPylontechCAN/JK-BMSToPylontechCAN/EasyButtonAtInt01.hpp

/*
 * EasyButtonAtInt01.hpp
 *
 * This file can be directly configured and included in one source.
 * Include EasyButtonAtInt01.h file if you need the declarations in a second source file.
 *
 *  Arduino library for handling push buttons connected between ground and INT0 and / or INT1 pin.
 *  INT0 and INT1 are connected to Pin 2 / 3 on most Arduinos (ATmega328), to PB6 / PA3 on ATtiny167 and on ATtinyX5 we have only INT0 at PB2.
 *  The library is totally based on interrupt.
 *  Debouncing is implemented in a not blocking way! It is merely done by ignoring a button change within the debouncing time.
 *  So button state is instantly available without debouncing delay!
 *
 *  Usage:
 *  #define USE_BUTTON_0
 *  #include "EasyButtonAtInt01.hpp"
 *  EasyButton Button0AtPin2(true);
 *
 *  Copyright (C) 2018-2026  Armin Joachimsmeyer
 *  armin.joachimsmeyer@gmail.com
 *
 *  This file is part of EasyButtonAtInt01 https://github.com/ArminJo/EasyButtonAtInt01.
 *
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
 *  You should have received a copy of the GNU General Public License
 *  along with this program. If not, see <http://www.gnu.org/licenses/gpl.html>.
 */

/*
 * This library can be configured at compile time by the following options / macros:
 * For more details see: https://github.com/ArminJo/EasyButtonAtInt01#compile-options--macros-for-this-library
 *
 * - USE_BUTTON_0                   Enables code for button at INT0 (pin2 on 328P, PB6 on ATtiny167, PB2 on ATtinyX5).
 * - USE_BUTTON_1                   Enables code for button at INT1 (pin3 on 328P, PA3 on ATtiny167, PCINT0 / PCx for ATtinyX5).
 * - INT1_PIN                       It overrides the usage of pin at the processors INT1 pin. Thus, it is the pin number of the pin for button 1 to use with Pin Change Interrupts.
 * - NO_INITIALIZE_IN_CONSTRUCTOR   Disables the auto initializing in all constructors not having the aIsButtonAtINT0 parameter.
 * - BUTTON_IS_ACTIVE_HIGH          Enable this if your buttons are active high.
 * - USE_ATTACH_INTERRUPT           This forces use of the arduino function attachInterrupt(). It is required if you get the error "multiple definition of __vector_1".
 * - NO_BUTTON_RELEASE_CALLBACK     Disables the code for release callback. This saves 2 bytes RAM and 64 bytes program memory.
 * - BUTTON_DEBOUNCING_MILLIS       With this you can adapt to the characteristic of your button. Default is 50.
 * - ANALYZE_MAX_BOUNCING_PERIOD    Analyze the buttons actual debounce value.
 * - BUTTON_LED_FEEDBACK            This activates LED_BUILTIN as long as button is pressed.
 * - BUTTON_LED_FEEDBACK_PIN        The pin to use for button LED feedback.
 *
 * The macros INT0_PIN and INT1_PIN are set after the include.
 */

#ifndef _EASY_BUTTON_AT_INT01_HPP
#define _EASY_BUTTON_AT_INT01_HPP

#if defined(__AVR__)
#include <Arduino.h>
#include "EasyButtonAtInt01.h"

/*
 * Usage:
 * #define USE_BUTTON_0  // Enables code for button at INT0 (pin2 on 328P, PB6 on ATtiny167, PB2 on ATtinyX5)
 * #define USE_BUTTON_1  // Enables code for button at INT1 (pin3 on 328P, PA3 on ATtiny167, PCINT0 / PCx for ATtinyX5)
 * #include "EasyButtonAtInt01.hpp"
 * EasyButton Button0AtPin2(true);  // true  -> Button is connected to INT0
 * EasyButton Button0AtPin3(false, &Button3CallbackHandler); // false -> button is not connected to INT0 => connected to INT1
 * ...
 * digitalWrite(LED_BUILTIN, Button0AtPin2.ButtonToggleState); // The value at the first call after first press is true
 * ...
 *
 */

// For external measurement of code timing
//#define MEASURE_EASY_BUTTON_INTERRUPT_TIMING
#if defined(MEASURE_EASY_BUTTON_INTERRUPT_TIMING) || defined(BUTTON_LED_FEEDBACK)
#include "digitalWriteFast.h"
#endif

#if defined(USE_BUTTON_0)
EasyButton *EasyButton::sPointerToButton0ForISR;
#endif
#if defined(USE_BUTTON_1)
EasyButton *EasyButton::sPointerToButton1ForISR;
#endif
#if !defined(USE_BUTTON_0) && !defined(USE_BUTTON_1)
#error One of USE_BUTTON_0 or USE_BUTTON_1 must be defined
#endif

// After all includes
#if defined(TRACE)
#define LOCAL_TRACE
#else
//#define LOCAL_TRACE // This enables trace output only for this file
#endif

// The eclipse formatter has problems with // comments in undefined code blocks
// !!! Must be without trailing comment and closed by @formatter:on
// @formatter:off

/*
 * These constructors are deterministic if only one button is enabled
 * If both buttons are enabled, it initializes the 1. button (USE_BUTTON_0),
 * so the second button must be enabled manually or by using a constructor with the parameter aIsButtonAtINT0.
 */
EasyButton::EasyButton() { // @suppress("Class members should be properly initialized")
#if !defined(NO_INITIALIZE_IN_CONSTRUCTOR)
#  if defined(USE_BUTTON_0)
    init(BUTTON_AT_INT0);  // 1. button
#  else
    init(BUTTON_AT_INT1_OR_PCINT); // 2. button
#  endif
#endif
}
/*
 * The same with aButtonPressCallback
 * If both buttons are enabled, it initializes the 1. button (USE_BUTTON_0)
 */
EasyButton::EasyButton(void (*aButtonPressCallback)(bool aButtonToggleState)) { // @suppress("Class members should be properly initialized")
    ButtonPressCallback = aButtonPressCallback;
#if !defined(NO_INITIALIZE_IN_CONSTRUCTOR)
#  if defined(USE_BUTTON_0)
    init(BUTTON_AT_INT0);  // 1. button
#  else
    init(BUTTON_AT_INT1_OR_PCINT); // 2. button
#  endif
#endif
}

#if !defined(NO_BUTTON_RELEASE_CALLBACK)
EasyButton::EasyButton(void (*aButtonPressCallback)(bool aButtonToggleState),
        void (*aButtonReleaseCallback)(bool aButtonToggleState, uint16_t aButtonPressDurationMillis)) { // @suppress("Class members should be properly initialized")
    ButtonPressCallback = aButtonPressCallback;
    ButtonReleaseCallback = aButtonReleaseCallback;
#if !defined(NO_INITIALIZE_IN_CONSTRUCTOR)
#    if defined(USE_BUTTON_0)
    init(BUTTON_AT_INT0); // 1. button
#    else
    init(BUTTON_AT_INT1_OR_PCINT); // 2. button
#    endif
#  endif
}
#endif // NO_BUTTON_RELEASE_CALLBACK

/**
 * @param aIsButtonAtINT0   true if this button is connected to INT0 i.e. is button 0
 */
EasyButton::EasyButton(bool aIsButtonAtINT0) {
#if !(defined(USE_BUTTON_0) && defined(USE_BUTTON_1))
    (void) aIsButtonAtINT0; // to suppress compiler warnings
#endif
#if defined(USE_BUTTON_0) && not defined(USE_BUTTON_1)
    init(BUTTON_AT_INT0); // 1. button
#elif defined(USE_BUTTON_1) && not defined(USE_BUTTON_0)
    init(BUTTON_AT_INT1_OR_PCINT); // 2. button
#else
    init(aIsButtonAtINT0);
#endif
}

/**
 * @param aIsButtonAtINT0   true if this button is connected to INT0 i.e. is button 0
 */
EasyButton::EasyButton(bool aIsButtonAtINT0, void (*aButtonPressCallback)(bool aButtonToggleState)) {
#if !(defined(USE_BUTTON_0) && defined(USE_BUTTON_1))
    (void) aIsButtonAtINT0; // to suppress compiler warnings
#endif
    ButtonPressCallback = aButtonPressCallback;
#if defined(USE_BUTTON_0) && not defined(USE_BUTTON_1)
    init(BUTTON_AT_INT0); // 1. button
#elif defined(USE_BUTTON_1) && not defined(USE_BUTTON_0)
    init(BUTTON_AT_INT1_OR_PCINT); // 2. button
#else
    init(aIsButtonAtINT0);
#endif
}

#if !defined(NO_BUTTON_RELEASE_CALLBACK)
/**
 * @param aIsButtonAtINT0   true if this button is connected to INT0 i.e. is button 0
 */
EasyButton::EasyButton(bool aIsButtonAtINT0, void (*aButtonPressCallback)(bool aButtonToggleState),
        void (*aButtonReleaseCallback)(bool aButtonToggleState, uint16_t aButtonPressDurationMillis)) {
#  if !(defined(USE_BUTTON_0) && defined(USE_BUTTON_1))
    (void) aIsButtonAtINT0; // to suppress compiler warnings
#  endif
    ButtonPressCallback = aButtonPressCallback;
    ButtonReleaseCallback = aButtonReleaseCallback;
#  if defined(USE_BUTTON_0) && not defined(USE_BUTTON_1)
init(BUTTON_AT_INT0); // 1. button
#  elif defined(USE_BUTTON_1) && not defined(USE_BUTTON_0)
init(BUTTON_AT_INT1_OR_PCINT); // 2. button
#  else
    init(aIsButtonAtINT0);
#  endif
}
#endif // NO_BUTTON_RELEASE_CALLBACK

#if !defined(CHANGE)
#define CHANGE 1 // For those crappy cores which did not define it. Is used as 3. Parameter for attachInterrupt() below.
#endif
/*
 * Sets pin mode to INPUT_PULLUP if not defined(BUTTON_IS_ACTIVE_HIGH) and enables INT0 Interrupt on any logical change.
 * @param aIsButtonAtINT0   true if this button is connected to INT0 i.e. is button 0
 */
void EasyButton::init(bool aIsButtonAtINT0) {
    isButtonAtINT0 = aIsButtonAtINT0;
#if defined(MEASURE_EASY_BUTTON_INTERRUPT_TIMING)
    pinModeFast(INTERRUPT_TIMING_OUTPUT_PIN, OUTPUT);
#endif

#if defined(BUTTON_LED_FEEDBACK)
    pinModeFast(BUTTON_LED_FEEDBACK_PIN, OUTPUT);
#endif

#if defined(USE_BUTTON_0) && not defined(USE_BUTTON_1)
    /*
     * Only button 0 requested
     */
    INT0_DDR_PORT &= ~(_BV(INT0_BIT)); // pinModeFast(2, INPUT_PULLUP);
#  if !defined(BUTTON_IS_ACTIVE_HIGH)
    INT0_OUT_PORT |= _BV(INT0_BIT); // enable pullup
#  endif
    sPointerToButton0ForISR = this;
#  if defined(USE_ATTACH_INTERRUPT)
#    if defined(ARDUINO_ARCH_SAMD) // see https://www.arduino.cc/reference/tr/language/functions/external-interrupts/attachinterrupt/ paragraph: Syntax
    attachInterrupt(INT0_PIN, &handleINT1Interrupt, CHANGE);
#    else
    attachInterrupt(digitalPinToInterrupt(INT0_PIN), &handleINT0Interrupt, CHANGE);
#    endif

#  elif defined(USE_INT2_FOR_BUTTON_0)
    EICRA |= _BV(ISC20);  // interrupt on any logical change
    EIFR |= _BV(INTF2);// clear interrupt bit
    EIMSK |= _BV(INT2);// enable interrupt on next change

#  else
    EICRA |= _BV(ISC00);  // interrupt on any logical change
    EIFR |= _BV(INTF0);// clear interrupt bit
    EIMSK |= _BV(INT0);// enable interrupt on next change
#  endif //USE_ATTACH_INTERRUPT

#elif defined(USE_BUTTON_1) && not defined(USE_BUTTON_0)
    /*
     * Only button 1 requested
     */
    INT1_DDR_PORT &= ~(_BV(INT1_BIT));
#  if !defined(BUTTON_IS_ACTIVE_HIGH)
    INT1_OUT_PORT |= _BV(INT1_BIT); // enable pullup
#  endif
    sPointerToButton1ForISR = this;

#  if (!defined(ISC10)) || ((defined(__AVR_ATtiny87__) || defined(__AVR_ATtiny167__)) && INT1_PIN != 3)
#    if defined(PCICR)
    PCICR |= _BV(PCIE0); // Enable pin change interrupt for port PA0 to PA7
    PCMSK0 = digitalPinToBitMask(INT1_PIN);
#    else
    // ATtinyX5 no ISC10 flag existent
    GIMSK |= _BV(PCIE); //PCINT enable, we have only one
    PCMSK = digitalPinToBitMask(INT1_PIN);
#    endif
#  elif (INT1_PIN != 3)
    /*
     * ATmega328 (Uno, Nano ) etc. Enable pin change interrupt for port PD0 to PD7 (Arduino pin 0 to 7)
     */
    PCICR |= _BV(PCIE2);
    PCMSK2 = digitalPinToBitMask(INT1_PIN);
#  else
#    if defined(USE_ATTACH_INTERRUPT)
#      if defined(ARDUINO_ARCH_SAMD) // see https://www.arduino.cc/reference/tr/language/functions/external-interrupts/attachinterrupt/ paragraph: Syntax
    attachInterrupt(INT1_PIN, &handleINT1Interrupt, CHANGE);
#      else
    attachInterrupt(digitalPinToInterrupt(INT1_PIN), &handleINT1Interrupt, CHANGE);
#      endif
#    else
    EICRA |= _BV(ISC10);  // interrupt on any logical change
    EIFR |= _BV(INTF1);     // clear interrupt bit
    EIMSK |= _BV(INT1);     // enable interrupt on next change
#    endif //USE_ATTACH_INTERRUPT
#  endif // !defined(ISC10)

#elif defined(USE_BUTTON_0) && defined(USE_BUTTON_1)
    /*
     * Both buttons 0 + 1 requested
     */
    if (isButtonAtINT0) {
        /*
         * Button 0
         */
        INT0_DDR_PORT &= ~(_BV(INT0_BIT)); // pinModeFast(2, INPUT);
#  if !defined(BUTTON_IS_ACTIVE_HIGH)
        INT0_OUT_PORT |= _BV(INT0_BIT); // enable pullup
#  endif
        sPointerToButton0ForISR = this;
#  if defined(USE_ATTACH_INTERRUPT)
#    if defined(ARDUINO_ARCH_SAMD) // see https://www.arduino.cc/reference/tr/language/functions/external-interrupts/attachinterrupt/ paragraph: Syntax
        attachInterrupt(INT1_PIN, &handleINT1Interrupt, CHANGE);
#    else
        attachInterrupt(digitalPinToInterrupt(INT0_PIN), &handleINT0Interrupt, CHANGE);
#    endif
#  else
        EICRA |= _BV(ISC00);    // interrupt on any logical change
        EIFR |= _BV(INTF0);     // clear interrupt bit
        EIMSK |= _BV(INT0);     // enable interrupt on next change
#  endif //USE_ATTACH_INTERRUPT
    } else {
        /*
         * Button 1
         * Allow PinChangeInterrupt
         */
        INT1_DDR_PORT &= ~(_BV(INT1_BIT));  // pinModeFast(INT1_BIT, INPUT_PULLUP);
#  if !defined(BUTTON_IS_ACTIVE_HIGH)
        INT1_OUT_PORT |= _BV(INT1_BIT); // enable pullup
#  endif
        sPointerToButton1ForISR = this;

        /*
         * Enable interrupt for 2. buttons
         */
#  if (!defined(ISC10)) || ((defined(__AVR_ATtiny87__) || defined(__AVR_ATtiny167__)) && INT1_PIN != 3)
#    if defined(PCICR)
        /*
         * ATtiny167 + 87. Enable pin change interrupt for port PA0 to PA7
         */
        PCICR |= _BV(PCIE0);
        PCMSK0 = digitalPinToBitMask(INT1_PIN);
#    else
        /*
         *ATtinyX5. Enable pin change interrupt for port PB0 to PB5
         */
        GIMSK |= _BV(PCIE); // PCINT enable, we have only one
        PCMSK = digitalPinToBitMask(INT1_PIN);
#    endif
#  elif INT1_PIN == 4 || INT1_PIN == 5 || INT1_PIN == 6 || INT1_PIN == 7
    //ATmega328 (Uno, Nano ) etc. Enable pin change interrupt for port PD0 to PD7 (Arduino pin 0 to 7)
        PCICR |= _BV(PCIE2);
        PCMSK2 = digitalPinToBitMask(INT1_PIN);
#    elif INT1_PIN == 8 || INT1_PIN == 9 || INT1_PIN == 10 || INT1_PIN == 11 || INT1_PIN == 12 || INT1_PIN == 13
    //ATmega328 (Uno, Nano ) etc. Enable pin change interrupt 0 to 5 for port PB0 to PB5 (Arduino pin 8 to 13)
        PCICR |= _BV(PCIE0);
        PCMSK0 = digitalPinToBitMask(INT1_PIN);
#    elif INT1_PIN == A0 || INT1_PIN == A1 || INT1_PIN == A2 || INT1_PIN == A3 || INT1_PIN == A4 || INT1_PIN == A5
    //ATmega328 (Uno, Nano ) etc. Enable pin change interrupt 8 to 13 for port PC0 to PC5 (Arduino pin A0 to A5)
        PCICR |= _BV(PCIE1);
        PCMSK1 = digitalPinToBitMask(INT1_PIN);
#  else
#    if defined(USE_ATTACH_INTERRUPT)
#      if defined(ARDUINO_ARCH_SAMD) // see https://www.arduino.cc/reference/tr/language/functions/external-interrupts/attachinterrupt/ paragraph: Syntax
        attachInterrupt(INT1_PIN, &handleINT1Interrupt, CHANGE);
#      else
        attachInterrupt(digitalPinToInterrupt(INT1_PIN), &handleINT1Interrupt, CHANGE);
#      endif
#    else
        // ATmega328 here
        EICRA |= _BV(ISC10);  // interrupt on any logical change
        EIFR |= _BV(INTF1);     // clear interrupt bit
        EIMSK |= _BV(INT1);     // enable interrupt on next change
#    endif //USE_ATTACH_INTERRUPT
#  endif // !defined(ISC10)
    }
#endif
    ButtonStateIsActive = false; // negative logic for ButtonStateIsActive! true means button pin is LOW
    ButtonToggleState = false;
}

/*
 * if NOT defined BUTTON_IS_ACTIVE_HIGH we have negative logic for readButtonState()!
 * In this case BUTTON_IS_ACTIVE (true) means button pin is LOW
 * @return BUTTON_IS_ACTIVE (true) or BUTTON_IS_INACTIVE (false)
 */
bool EasyButton::readButtonState() {
#if defined(USE_BUTTON_0) && not defined(USE_BUTTON_1)
#  if defined(BUTTON_IS_ACTIVE_HIGH)
    return (INT0_IN_PORT & _BV(INT0_BIT));  //  = digitalReadFast(2);
#  else
    return !(INT0_IN_PORT & _BV(INT0_BIT));  //  = digitalReadFast(2);
#  endif

#elif defined(USE_BUTTON_1) && not defined(USE_BUTTON_0)
#  if defined(BUTTON_IS_ACTIVE_HIGH)
    return (INT1_IN_PORT & _BV(INT1_BIT));  //  = digitalReadFast(3);
#  else
    return !(INT1_IN_PORT & _BV(INT1_BIT));  //  = digitalReadFast(3);
#  endif

#elif defined(USE_BUTTON_0) && defined(USE_BUTTON_1)
#  if defined(BUTTON_IS_ACTIVE_HIGH)
    if (isButtonAtINT0) {
        return (INT0_IN_PORT & _BV(INT0_BIT));  //  = digitalReadFast(2);
    } else {
        return (INT1_IN_PORT & _BV(INT1_BIT));  //  = digitalReadFast(3);
    }
#  else
    if (isButtonAtINT0) {
        return !(INT0_IN_PORT & _BV(INT0_BIT));  //  = digitalReadFast(2);
    } else {
        return !(INT1_IN_PORT & _BV(INT1_BIT));  //  = digitalReadFast(3);
    }
#  endif
#else
    return false;
#endif
}

// @formatter:on

bool EasyButton::getButtonStateIsActive() {
    return ButtonStateIsActive;

}
/*
 * Returns stored state if in debouncing period otherwise current state of button
 * If button is in bouncing period, we do not know button state, so it is only save to return BUTTON_IS_INACTIVE
 * @return BUTTON_IS_ACTIVE (true) or BUTTON_IS_INACTIVE (false)
 */
bool EasyButton::readDebouncedButtonState() {
    // Check if we are in bouncing period
    if (millis() - ButtonLastChangeMillis <= BUTTON_DEBOUNCING_MILLIS) {
        // If button is in bouncing period, we do not know button state, so it is only save to return BUTTON_IS_INACTIVE
        return BUTTON_IS_INACTIVE;
    }
    return readButtonState();
}

/*
 * Update button state if state change was not captured by the ISR
 * @return true if state was changed and updated
 */
bool EasyButton::updateButtonState() {
    noInterrupts();
    if (readDebouncedButtonState() != ButtonStateIsActive) {
#if defined(LOCAL_TRACE)
        if (LastBounceWasChangeToInactive) {
            Serial.print(F("Updated button state, assume last button press was shorter than debouncing period of "));
            Serial.print(BUTTON_DEBOUNCING_MILLIS);
            Serial.print(F(" ms"));
#if defined(ANALYZE_MAX_BOUNCING_PERIOD)
            Serial.print(F(" MaxBouncingPeriod was="));
            Serial.print(MaxBouncingPeriodMillis);
            MaxBouncingPeriodMillis = 0;
#endif
        } else {
            // It can happen, that we just catch the release of the button here, so no worry!
            Serial.print(F("Update button state to "));
            Serial.print(!ButtonStateIsActive);
            Serial.print(F(", current state was not yet caught by ISR"));
        }
        Serial.println();
#endif
        handleINT01Interrupts();
        interrupts();
        return true;
    }
    interrupts();
    return false;
}

/*
 * Updates the ButtonPressDurationMillis by polling, since this cannot be done by interrupt.
 */
uint16_t EasyButton::updateButtonPressDuration() {
    if (readDebouncedButtonState()) {
        // Button still active -> update ButtonPressDurationMillis
        ButtonPressDurationMillis = millis() - ButtonLastChangeMillis;
    }
    return ButtonPressDurationMillis;
}

/*
 * Used for long button press recognition, while button is still pressed!
 * !!! Consider to use button release callback handler and check the ButtonPressDurationMillis
 * You may use EASY_BUTTON_LONG_PRESS_DEFAULT_MILLIS which is 400
 * returns EASY_BUTTON_LONG_PRESS_DETECTED, EASY_BUTTON_LONG_PRESS_STILL_POSSIBLE and EASY_BUTTON_LONG_PRESS_ABORT
 */
uint8_t EasyButton::checkForLongPress(uint16_t aLongPressThresholdMillis) {
    uint8_t tRetvale = EASY_BUTTON_LONG_PRESS_ABORT;
    // noInterrupts() is required, since otherwise we may get wrong results if interrupted during processing by button ISR
    noInterrupts();
    if (readDebouncedButtonState() != BUTTON_IS_INACTIVE) {
        // Button still active -> update current ButtonPressDurationMillis

        ButtonPressDurationMillis = millis() - ButtonLastChangeMillis;
        tRetvale = EASY_BUTTON_LONG_PRESS_STILL_POSSIBLE; // if not detected, you may try again
    }
    interrupts();
    if (ButtonPressDurationMillis >= aLongPressThresholdMillis) {
        // long press detected
        return EASY_BUTTON_LONG_PRESS_DETECTED;
    }

    return tRetvale;
}

/*
 * Checks for long press of button
 * Blocks until long press threshold is reached or button was released.
 * !!! Consider to use button release callback handler and check the ButtonPressDurationMillis
 * @return true if long press was detected - only once for each long press
 */
bool EasyButton::checkForLongPressBlocking(uint16_t aLongPressThresholdMillis) {
    /*
     * wait as long as button is pressed shorter than threshold millis.
     */
    while (checkForLongPress(aLongPressThresholdMillis) == EASY_BUTTON_LONG_PRESS_STILL_POSSIBLE) {
        delay(1);
    }
    /*
     * Here button was not pressed or time was greater than threshold.
     * ButtonPressDurationMillis was updated by call to checkForLongPress before
     */
    return (ButtonPressDurationMillis >= aLongPressThresholdMillis);
}

/*
 * Double press detection by computing difference between current (active) timestamp ButtonLastChangeMillis
 * and last release timestamp ButtonReleaseMillis.
 * !!!Works only reliable if called early in ButtonPress callback function!!!
 * !!!Do not call it in ButtonRelease callback function, it makes no sense!!!
 * You may use EASY_BUTTON_DOUBLE_PRESS_DEFAULT_MILLIS which is 400
 * @return true if double press detected.
 */
bool EasyButton::checkForDoublePress(uint16_t aDoublePressDelayMillis) {
    /*
     * Check if ButtonReleaseMillis is not in initialized state
     * otherwise a single press before aDoublePressDelayMillis after boot is mistakenly detected as double press
     * Check costs 26 bytes program memory :-(
     */
    if (ButtonReleaseMillis != 0) {
        // because ButtonReleaseMillis is initialized with 0 milliseconds, which is interpreted as the first press happened at the beginning of boot.
        unsigned long tReleaseToPressTimeMillis = ButtonLastChangeMillis - ButtonReleaseMillis;
#if defined(LOCAL_TRACE)
        Serial.print(F("DoublePressDelayMillis="));
        Serial.print(aDoublePressDelayMillis);
        Serial.print(F(", ReleaseToPressTimeMillis="));
        Serial.println(tReleaseToPressTimeMillis);
#endif
        // tReleaseToPressTimeMillis != 0 adds 4 bytes, but avoids wrong double press detection if calling this function after release of button
        return (tReleaseToPressTimeMillis != 0 && tReleaseToPressTimeMillis <= aDoublePressDelayMillis);
    }
    return false;
}

/*
 * Checks if button was not pressed in the last aTimeoutMillis
 * Can be used to recognize timeout for user button actions
 * @return true if timeout reached: false if last button release was before aTimeoutMillis
 */
bool EasyButton::checkForForButtonNotPressedTime(uint16_t aTimeoutMillis) {
    // noInterrupts() is required, since otherwise we may get wrong results if interrupted during load of long value by button ISR
    noInterrupts();
    unsigned long tButtonReleaseMillis = ButtonReleaseMillis;
    interrupts();
    return (millis() - tButtonReleaseMillis >= aTimeoutMillis);
}

/*
 * 1. Read button pin level and invert logic level since we have negative logic because of using pullups.
 * 2. Check for bouncing - state change during debounce period. We need millis() to be enabled to run in the background.
 * 3. Check for spikes - interrupts but no level change.
 * 4. Process valid button state change. If callback requested, call callback routine, get button pin level again and handle if button was released in the meantime.
 */
void EasyButton::handleINT01Interrupts() {
    // Read button value
    bool tCurrentButtonStateIsActive;

    /*
     * This is faster than readButtonState();
     */
#if defined(USE_BUTTON_0) && not defined(USE_BUTTON_1)
    tCurrentButtonStateIsActive = INT0_IN_PORT & _BV(INT0_BIT);  //  = digitalReadFast(2);

#elif defined(USE_BUTTON_1) && not defined(USE_BUTTON_0)
    tCurrentButtonStateIsActive = INT1_IN_PORT & _BV(INT1_BIT);  //  = digitalReadFast(3);

#elif defined(USE_BUTTON_0) && defined(USE_BUTTON_1)
    if (isButtonAtINT0) {
        tCurrentButtonStateIsActive = INT0_IN_PORT & _BV(INT0_BIT);  //  = digitalReadFast(2);
    } else {
        tCurrentButtonStateIsActive = INT1_IN_PORT & _BV(INT1_BIT);  //  = digitalReadFast(3);
    }
#endif
#if !defined(BUTTON_IS_ACTIVE_HIGH)
    tCurrentButtonStateIsActive = !tCurrentButtonStateIsActive; // negative logic for tCurrentButtonStateIsActive! true means button pin is LOW
#endif

#if defined(LOCAL_TRACE)
    Serial.print(tCurrentButtonStateIsActive);
    Serial.print('-');
#endif

    unsigned long tMillis = millis();
    unsigned int tDeltaMillis = tMillis - ButtonLastChangeMillis;
    // Check for bouncing - state change during debounce period
    if (tDeltaMillis <= BUTTON_DEBOUNCING_MILLIS) {
        /*
         * Button is bouncing, signal is ringing - do nothing, ignore and wait for next interrupt
         */
#if defined(ANALYZE_MAX_BOUNCING_PERIOD)
        if (MaxBouncingPeriodMillis < tDeltaMillis) {
            MaxBouncingPeriodMillis = tDeltaMillis;
            Serial.print(F("Bouncing, MBP="));
            Serial.println(MaxBouncingPeriodMillis);
            //        Serial.print(F("ms="));
            //        Serial.print(tMillis);
            //        Serial.print(F(" D="));
            //        Serial.println(tDeltaMillis);
        }
#endif
        if (tCurrentButtonStateIsActive) {
            LastBounceWasChangeToInactive = false;
        } else {
            /*
             * Store, that switch goes inactive during debouncing period.
             * This may be a bouncing issue (fine) but it can also be a very short button press.
             * In this case we do not set the ButtonStateIsActive to false because we are in debouncing period.
             * On the next press this will be detected as a spike, if not considered.
             */
            LastBounceWasChangeToInactive = true;
        }

    } else {
        /*
         * Here we are after debouncing period
         */
        if (tCurrentButtonStateIsActive == ButtonStateIsActive) {
            /*
             * No valid change detected - current is equals last state
             */
            if (tCurrentButtonStateIsActive && LastBounceWasChangeToInactive) {
                // We assume we had a very short press before (or a strange spike), which was handled as a bounce. -> must adjust last button state
                ButtonStateIsActive = false;
#if defined(LOCAL_TRACE)
                Serial.println(F("Preceding short press detected, which was handled as bounce"));
#endif

            } else {
                /*
                 * tCurrentButtonStateIsActive == OldButtonStateIsActive. We had an interrupt, but nothing seems to have changed -> spike
                 * Do nothing, ignore and wait for next interrupt
                 */
#if defined(LOCAL_TRACE)
                Serial.println(F("Spike"));
#endif
            }
        }

        // do not use else since we may have changed ButtonStateIsActive
        if (tCurrentButtonStateIsActive != ButtonStateIsActive) {
            /*
             * Valid change detected
             */
            ButtonLastChangeMillis = tMillis;
            LastBounceWasChangeToInactive = false;
#if defined(LOCAL_TRACE)
            Serial.println(F("Change"));
#endif
            ButtonStateIsActive = tCurrentButtonStateIsActive;
            ButtonStateHasJustChanged = true;
            if (tCurrentButtonStateIsActive) {
                /*
                 * Button pressed
                 */
#if defined(BUTTON_LED_FEEDBACK)
                digitalWriteFast(BUTTON_LED_FEEDBACK_PIN, HIGH);
#endif
                ButtonToggleState = !ButtonToggleState;
                if (ButtonPressCallback != nullptr) {
                    /*
                     * Call callback function.
                     * interrupts() is required if callback function needs more time to allow millis() to proceed.
                     * Otherwise we may see bouncing instead of button release followed by spike instead of button press
                     */
                    interrupts();
                    ButtonPressCallback(ButtonToggleState);
                    /*
                     * Check button again since it may changed back while processing callback function
                     */
                    if (!readButtonState()) {
                        // button released now, so maintain status
#if defined(LOCAL_TRACE)
                        Serial.println(F("Button release during callback processing detected."));
#endif
                        ButtonStateIsActive = false;
                        tMillis = millis();
                        ButtonPressDurationMillis = tMillis - ButtonLastChangeMillis;
                        ButtonLastChangeMillis = tMillis;
                        ButtonStateHasJustChanged = true;
                        ButtonReleaseMillis = tMillis;
                    }
                }
            } else {
                /*
                 * Button release
                 */
                ButtonPressDurationMillis = tDeltaMillis;
                ButtonReleaseMillis = tMillis;
#if !defined(NO_BUTTON_RELEASE_CALLBACK)
                if (ButtonReleaseCallback != nullptr) {
                    /*
                     * Call callback function.
                     * interrupts() is required if callback function needs more time to allow millis() to proceed.
                     */
                    interrupts();
                    ButtonReleaseCallback(ButtonToggleState, ButtonPressDurationMillis);
                    /*
                     * Check button again since it may be activated while processing callback function
                     */
                    if (readButtonState()) {
                        // button activated now, so maintain status
#  if defined(LOCAL_TRACE)
                        Serial.println(F("Button active after callback processing detected."));
#  endif
                        ButtonStateIsActive = true;
                        ButtonLastChangeMillis = millis();
                        ButtonStateHasJustChanged = true;
                        LastBounceWasChangeToInactive = false;
                    }
                }
#endif
#if defined(BUTTON_LED_FEEDBACK)
                digitalWriteFast(BUTTON_LED_FEEDBACK_PIN, LOW);
#endif
            }
        }
    }
}

// end of class definitions

/*
 * This functions are weak and can be replaced by your own code
 */
#if defined(USE_BUTTON_0)
void __attribute__ ((weak)) handleINT0Interrupt() {
    EasyButton::sPointerToButton0ForISR->handleINT01Interrupts();
}
#endif

#if defined(USE_BUTTON_1)
void __attribute__ ((weak)) handleINT1Interrupt() {
    EasyButton::sPointerToButton1ForISR->handleINT01Interrupts();
}
#endif

#if not defined(USE_ATTACH_INTERRUPT)
// ISR for PIN PD2
// Cannot make the vector itself weak, since the vector table is already filled by weak vectors resulting in ignoring my weak one:-(
//ISR(INT0_vect, __attribute__ ((weak))) {
#  if defined(USE_INT2_FOR_BUTTON_0)
ISR(INT2_vect) {
#    if defined(MEASURE_EASY_BUTTON_INTERRUPT_TIMING)
    digitalWriteFast(INTERRUPT_TIMING_OUTPUT_PIN, HIGH);
#    endif
    handleINT0Interrupt();
#    if defined(MEASURE_EASY_BUTTON_INTERRUPT_TIMING)
    digitalWriteFast(INTERRUPT_TIMING_OUTPUT_PIN, LOW);
#    endif
}
#  else
#    if defined(USE_BUTTON_0)
ISR(INT0_vect) {
#      if defined(MEASURE_EASY_BUTTON_INTERRUPT_TIMING)
    digitalWriteFast(INTERRUPT_TIMING_OUTPUT_PIN, HIGH);
#      endif
    handleINT0Interrupt();
#      if defined(MEASURE_EASY_BUTTON_INTERRUPT_TIMING)
    digitalWriteFast(INTERRUPT_TIMING_OUTPUT_PIN, LOW);
#      endif
}
#    endif
#  endif

#  if defined(USE_BUTTON_1)
#    if (!defined(ISC10)) || ((defined(__AVR_ATtiny87__) || defined(__AVR_ATtiny167__)) && INT1_PIN != 3)
// on ATtinyX5 we do not have a INT1_vect but we can use the PCINT0_vect
ISR(PCINT0_vect)
#    elif INT1_PIN == 4 || INT1_PIN == 5 || INT1_PIN == 6 || INT1_PIN == 7
// PCINT for ATmega328 Arduino pins 0 to 7
ISR(PCINT2_vect)
#    elif INT1_PIN == 8 || INT1_PIN == 9 || INT1_PIN == 10 || INT1_PIN == 11 || INT1_PIN == 12 || INT1_PIN == 13
// PCINT for ATmega328 Arduino pins 8 (PB0) to 13 (PB5) - (PCINT 0 to 5)
ISR(PCINT0_vect)
#    elif INT1_PIN == A0 || INT1_PIN == A1 || INT1_PIN == A2 || INT1_PIN == A3 || INT1_PIN == A4 || INT1_PIN == A5
// PCINT for ATmega328 Arduino pins A1 (PC0) to A5 (PC5) - (PCINT 8 to 13)
ISR(PCINT1_vect)
#    else
ISR(INT1_vect)
#    endif
{
#    if defined(MEASURE_EASY_BUTTON_INTERRUPT_TIMING)
    digitalWriteFast(INTERRUPT_TIMING_OUTPUT_PIN, HIGH);
#    endif
    handleINT1Interrupt();
#    if defined(MEASURE_EASY_BUTTON_INTERRUPT_TIMING)
    digitalWriteFast(INTERRUPT_TIMING_OUTPUT_PIN, LOW);
#    endif
}
#  endif
#endif // not defined(USE_ATTACH_INTERRUPT)

#if defined(LOCAL_TRACE)
#undef LOCAL_TRACE
#endif

#endif // defined(__AVR__)
#endif // _EASY_BUTTON_AT_INT01_HPP
