ArminJo/JK-BMSToPylontechCAN/JK-BMSToPylontechCAN/JK-BMS_SOCHistory.h

/*
 * JK-BMS_SOCHistory.h
 *
 * Definitions of the data structures used by JK-BMS_SOCHistory
 *
 *  Copyright (C) 2024-2026  Armin Joachimsmeyer
 *
 *  This file is part of ArduinoUtils https://github.com/ArminJo/JK-BMSToPylontechCAN.
 *
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
 */
#ifndef _JK_BMS_SOC_HISTORY_H
#define _JK_BMS_SOC_HISTORY_H

/*
 * The value of AverageAccumulator10Milliampere for 1 Ah is:
 * (60 * 60 * 1000L / MILLISECONDS_BETWEEN_JK_DATA_FRAME_REQUESTS) is number of samples in 1 hour -> 1800 at 1 sample / 2 seconds
 * 100 is factor for 10 mA to 1 A
 */
#define CAPACITY_10_mA_ACCUMULATOR_1_AMPERE_HOUR  (100L * 60L * 60L * 1000L / MILLISECONDS_BETWEEN_JK_DATA_FRAME_REQUESTS) // 180,000

/*
 * This structure is stored to EEPROM
 */
#define SOC_EVEN_EEPROM_PAGE_INDICATION_BIT 0x80 // Set in SOCPercent if we currently write on an even page. Required to find the end of current data in cyclic buffer.
struct SOCDataPointDeltaStruct {
    uint8_t SOCPercent;
    uint8_t VoltageDifferenceToEmpty50Millivolt; // 1 = 50 mV, 255 = 12.75 V. Values > 240 to 255 / 12 V to 12.7 V are taken as negative ones, just in case it happens.
    int8_t AverageAmpere;   // Direct value, no delta required for this resolution
    int8_t Delta100MilliampereHour; // -12.8 Ah to 12.7 Ah. At a capacity of 320 Ah we have 3.2 Ah per 1% SOC
};
#define NUMBER_OF_SOC_DATA_POINTS   (((E2END + 1) - sizeof(SOCDataPointDeltaStruct)) / sizeof(SOCDataPointDeltaStruct)) // 0xFE for 1k EEPROM, 0x1FE for 2kEEPROM

/*
 * This structure is initially filled while reading data from EEPROM and updated on writing
 */
struct SOCDataPointsInfoStruct {
    /*
     * Index of next value to be written is ArrayStartIndex + ArrayLength % NUMBER_OF_SOC_DATA_POINTS
     * => if array is full i.e. ArrayLength == NUMBER_OF_SOC_DATA_POINTS, index of next value to be written is ArrayStartIndex.
     */
    uint16_t ArrayStartIndex; // Index of first data entry in cyclic SOCDataPointsEEPROMArray. Index of next value to be written if ArrayLength == NUMBER_OF_SOC_DATA_POINTS.
    uint16_t ArrayLength;      // Length of valid data in Array. Required if not fully written. Maximum is NUMBER_OF_SOC_DATA_POINTS
    bool currentlyWritingOnAnEvenPage; // If true SOC_EVEN_EEPROM_PAGE_INDICATION_BIT is set in SOCPercent.

    uint16_t NumberOfSamples; // For one sample each 2 seconds, we can store up to 36.4 hours here.
    long AverageAccumulatorVoltageDifferenceToEmpty10Millivolt; // Serves as accumulator to enable a more smooth graph.
    long AverageAccumulator10Milliampere; // Serves as accumulator for AverageAmpere
    long DeltaAccumulator10Milliampere; // Serves as accumulator to avoid rounding errors for consecutive data points of Delta100MilliampereHour. 1 Ah is 180,000 => Can hold values of +/-11930 Ah. We can have a residual of up to 18,000 (100 mAh) after write.
    long lastWrittenBatteryCapacityAsAccumulator10Milliampere;

    uint16_t checksumForReboot; // Checksum of values from NumberOfSamples up to lastWrittenBatteryCapacityAsAccumulator10Milliampere to decide if we can keep this data at reboot
};
extern SOCDataPointsInfoStruct SOCDataPointsInfo;

struct SOCDataPointMinMaxStruct {
    uint8_t SOCPercent;
    int16_t VoltageDifferenceToEmpty50Millivolt;
    int16_t CapacityAmpereHour;
    int8_t AverageAmpere;
};

void initializeAnalytics();
void updateCompleteEEPROMTo_FF();
void writeSOCDataToEEPROMIfSOCChanged();
void findFirstSOCDataPointIndex();
void readBatteryESRfromEEPROM();
void readAndPrintSOCData();

#endif // _JK_BMS_SOC_HISTORY_H
