ArminJo/JK-BMSToPylontechCAN/(commit log)

2023-07-27 Added 250 kBaud for CAN. Improved connection schematic.
2023-07-29 Bug fixes and display of power instead of current in Big Info Page
    [JK-BMS.cpp, JK-BMS.h, JK-BMSToPylontechCAN.ino, LCDBigNumbers.hpp, MCP2515_TX.h, MCP2515_TX.hpp, Pylontech_CAN.h]
2023-08-05 Improved printing
2023-08-06 Renamed cpp to hpp to fix inconsistent MAXIMUM_NUMBER_OF_CELLS values. closes #7
    [EasyButtonAtInt01.hpp, JK-BMS.h, JK-BMS.hpp, JK-BMSToPylontechCAN.ino, LCDBigNumbers.hpp, Pylontech_CAN.hpp]
2023-08-06 Improved button handling
2023-08-07 Fix force charging bug
    [JK-BMS.h, JK-BMS.hpp, JK-BMSToPylontechCAN.ino, Pylontech_CAN.h]
2023-08-08 BMS startup handling
2023-08-08 Version 1.3: Changed debug pin, improved beep handling and added overvoltage check
2023-08-11 Improved button and timeout handling
2023-10-01 GUI and print improvements
2023-10-13 Version 2.1.1 - Fixed SOH == 0 bug
    [EasyButtonAtInt01.h, JK-BMS.h, JK-BMS.hpp, JK-BMSToPylontechCAN.ino]
2023-10-16 Substituted debug button by long press of page button.
2023-10-18 Fixed LCD backlight timeout bug introduced in 1.3.0
    [JK-BMSToPylontechCAN.ino, Pylontech_CAN.hpp]
2023-10-23 Add frame 0x35F for total capacity as SMA extension, which is no problem for Deye inverters.
    [JK-BMSToPylontechCAN.ino, Pylontech_CAN.h, Pylontech_CAN.hpp]
2023-10-27 Add frame 0x379 for total capacity as Luxpower extension, which is no problem for Deye inverters.
    [JK-BMSToPylontechCAN.ino, Pylontech_CAN.h, Pylontech_CAN.hpp]
2023-11-03 Separated non converting features and added capacity computing
2023-11-06 - Added optional user function to reduce max current at high SOC level. - Optional 3 digits cell voltage on LCD.
2023-11-13 Improved capacity computing display
2023-12-17 Support for communication status LED
2023-12-22 Changed mV to V in Capacity Statistics Voltage Page
2024-01-12 Renaming + added frame 0x373 for BYD style Cell limits.
2024-01-12 Included code from https://github.com/paulsteigel/JK-BMSToPylontechCAN/blob/b96af8e2e39850211ca847f347a632ed57e5ce4f/JK-BMSToPylontechCAN/Pylontech_CAN.hpp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
2024-01-31 SOC graph output for Arduino Serial Plotter at Capacity Statistics page
2024-02-01 Fixing race condition while debug and options for saving program space
    [EasyButtonAtInt01.hpp, JK-BMS.h, JK-BMS.hpp, JK-BMSToPylontechCAN.ino, JK-BMS_LCD.hpp]
2024-03-03 Back to start page at next button press after 1 minute
2024-03-11 Added BATTERY_ESR_MILLIOHM
2024-03-20 fixed bug in graph legend
    [JK-BMS_Analytics.h, JK-BMS_Analytics.hpp]
2024-04-09 Seldom occurring overflow error fixed. Improved beep handling.
    [JK-BMS.h, JK-BMS.hpp, JK-BMSToPylontechCAN.ino, JK-BMS_Analytics.hpp, JK-BMS_LCD.hpp]
2024-04-09 Changed EEPROM voltage value from 40 mV resolution to 50 mV resolution and allow small negative values
2024-04-21 Refactored alarm and timeout handling. Removed default setting of CAPACITY_35F_EXTENSIONS, CAPACITY_379_EXTENSIONS and BYD_LIMITS_373_EXTENSIONS. Bumped version to 2.6.0.
2024-05-29 Bumped version to 3.1.0 - Analytics bug fixing and graph handling of extra capacity below 0 % and above 100 %.
    [JK-BMS.h, JK-BMS.hpp, JK-BMSToPylontechCAN.ino, JK-BMS_Analytics.h, JK-BMS_Analytics.hpp]
2024-06-27 Bumped version to 3.2.0 - Keep accumulated analytics data at reset.
    [JK-BMS.h, JK-BMS.hpp, JK-BMSToPylontechCAN.ino, JK-BMS_Analytics.h, JK-BMS_Analytics.hpp, JK-BMS_LCD.hpp, Pylontech_CAN.h]
2024-09-22 Bumped version to 4.0.0. JK_BMS communication and print functions are now contained in the JK_BMS class.
2024-10-08 Support for multi BMS
2026-05-08 Zero voltage check and beep handling improvements
2026-05-09 Fix status display bug
    [JK-BMS.h, JK-BMS_LCD.hpp]
2026-05-13 Added removed Capacity Info page
